blues/blues-kicad-lib/3d-models/DIST-WASMSIM0250.step

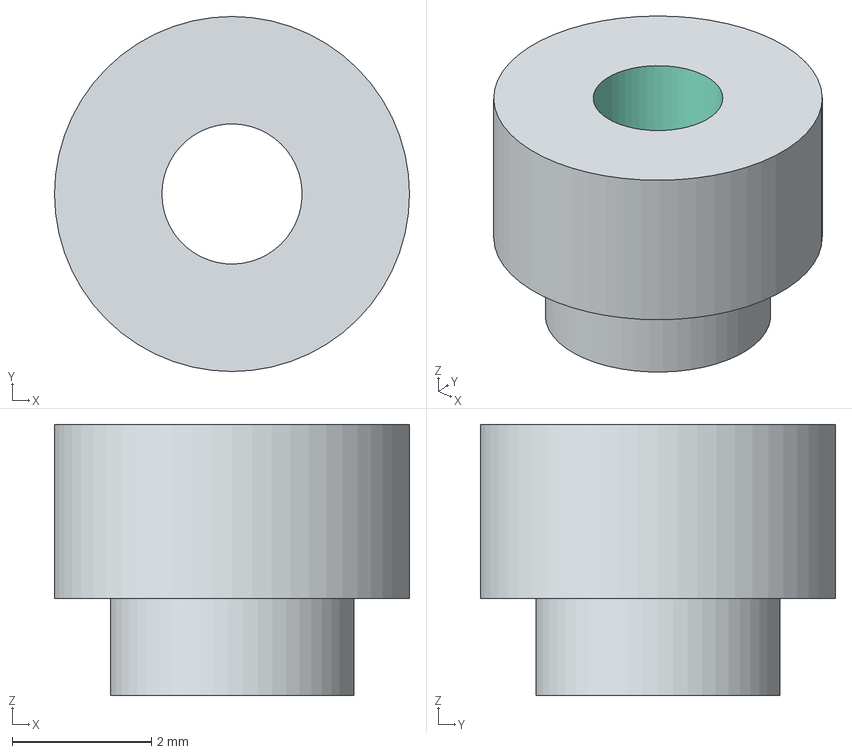
[picture p2: CAD file, 2023-12-04]
3d-models/DIST-WASMSIM0250.step
5.10 x 5.10 x 3.90 mm
