blues/blues-kicad-lib/3d-models/F930J107KAABE1.stp

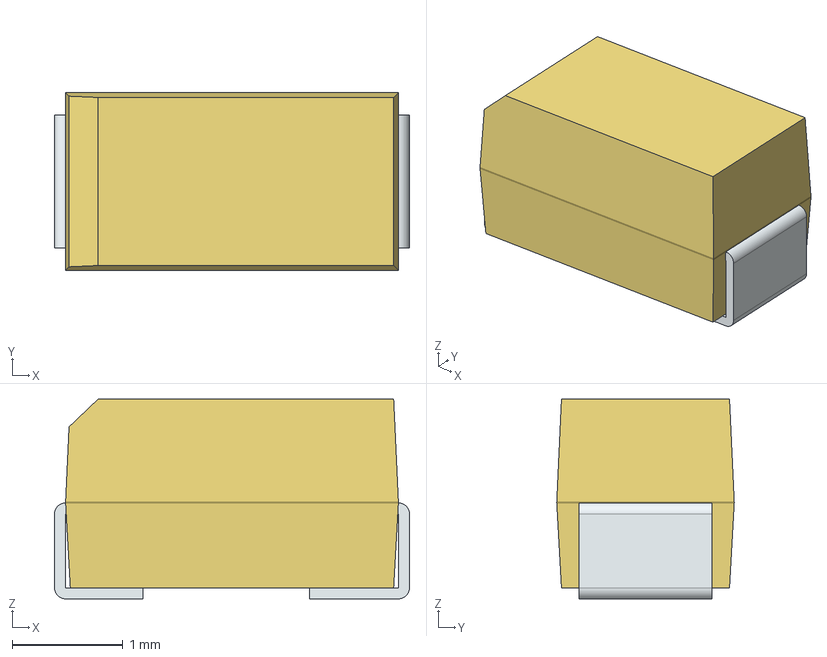
[picture p3: CAD file, 2026-10-05]
3d-models/F930J107KAABE1.stp
3.20 x 1.60 x 1.80 mm
FilletPin1
FilletPin2
