blues/blues-kicad-lib/3d-models/1769.stp

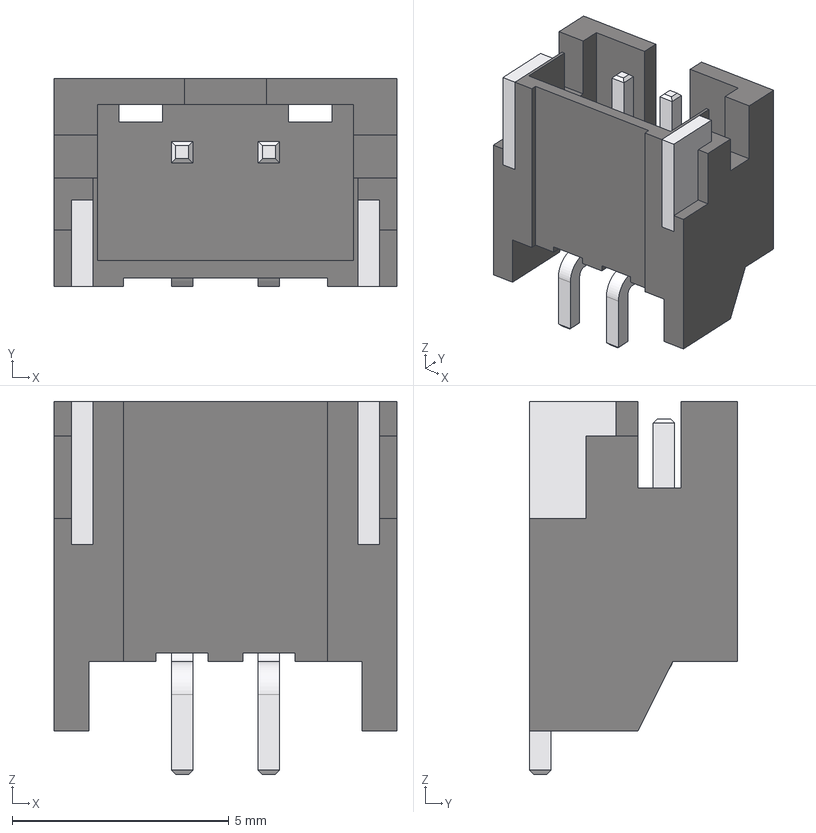
[picture p4: CAD file, 2026-10-05]
3d-models/1769.stp
7.90 x 4.80 x 8.60 mm
