blues/blues-kicad-lib/3d-models/C1206C103KDRACTU.stp

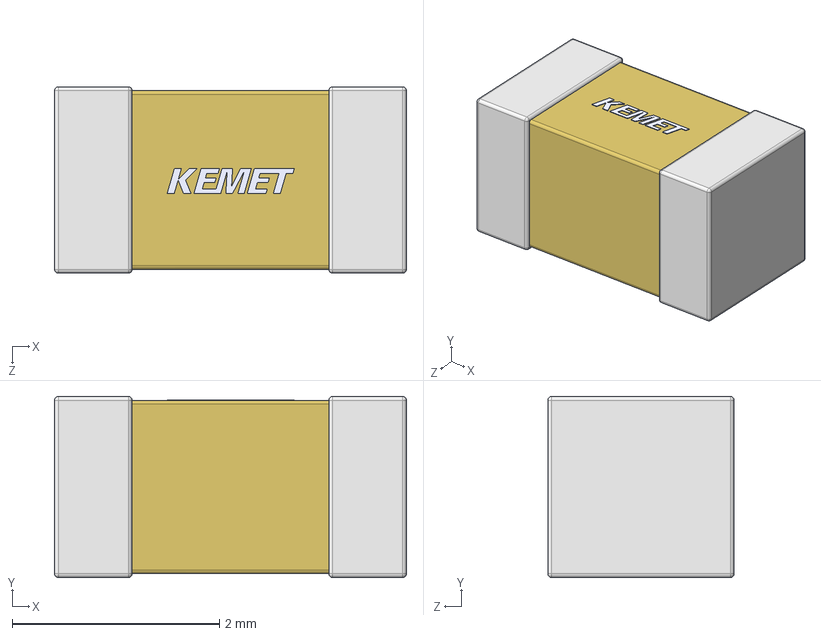
[picture p5: CAD file, 2026-10-05]
3d-models/C1206C103KDRACTU.stp
3.40 x 1.75 x 1.80 mm
