blues/blues-kicad-lib/3d-models/XTAL_3.2x1.5 MM.STEP

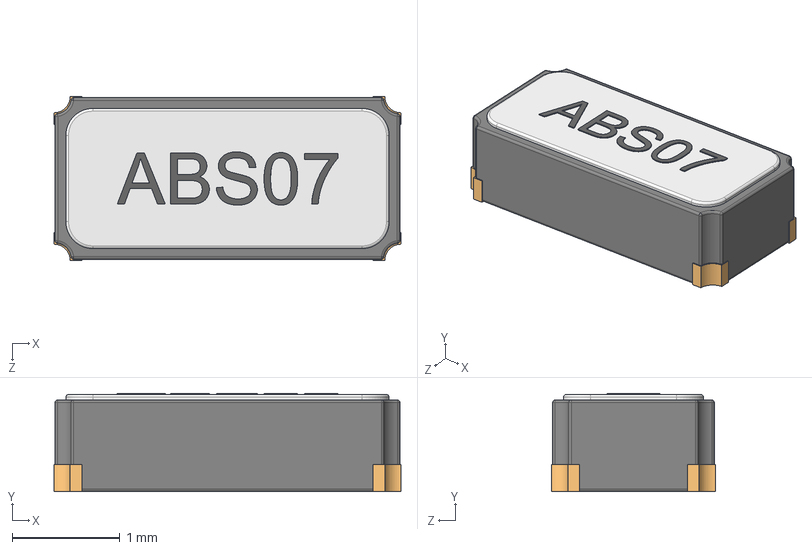
[picture p6: CAD file, 2026-10-05]
3d-models/XTAL_3.2x1.5 MM.STEP
3.22 x 0.91 x 1.52 mm
User Library-ABS07_ABS07 Body_2
User Library-ABS07_ABS07 Body2_2
User Library-ABS07_ABS07 Beschriftung_2
User Library-ABS07_ABS07 Pads_2
