blues/blues-kicad-lib/3d-models/XCVR_NN03-310.STEP

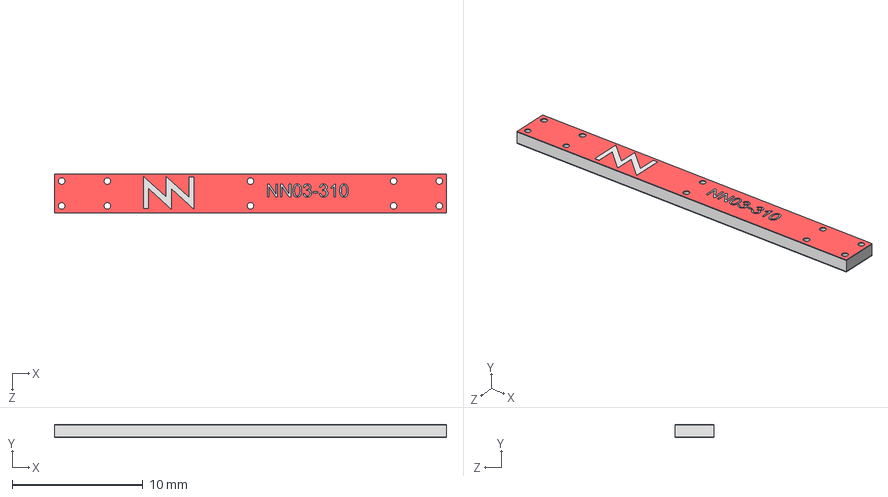
[picture p7: CAD file, 2026-10-05]
3d-models/XCVR_NN03-310.STEP
30.0 x 1.01 x 3.00 mm
