blues/blues-kicad-lib/3d-models/PHR-2-for-Battery-Adafruit.stp

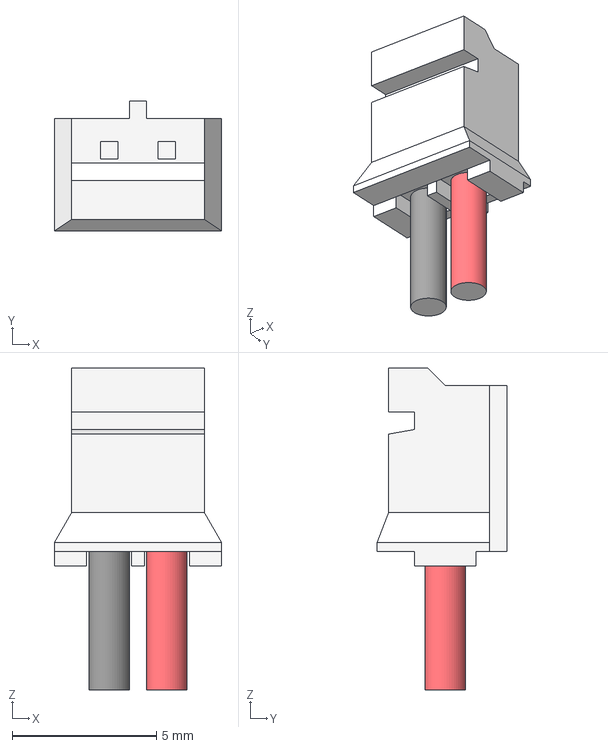
[picture p8: CAD file, 2026-10-05]
3d-models/PHR-2-for-Battery-Adafruit.stp
5.80 x 4.50 x 11.2 mm
