blues/blues-kicad-lib/3d-models/Cap_Murata_GRM188R61A106KE69D_eec.STEP

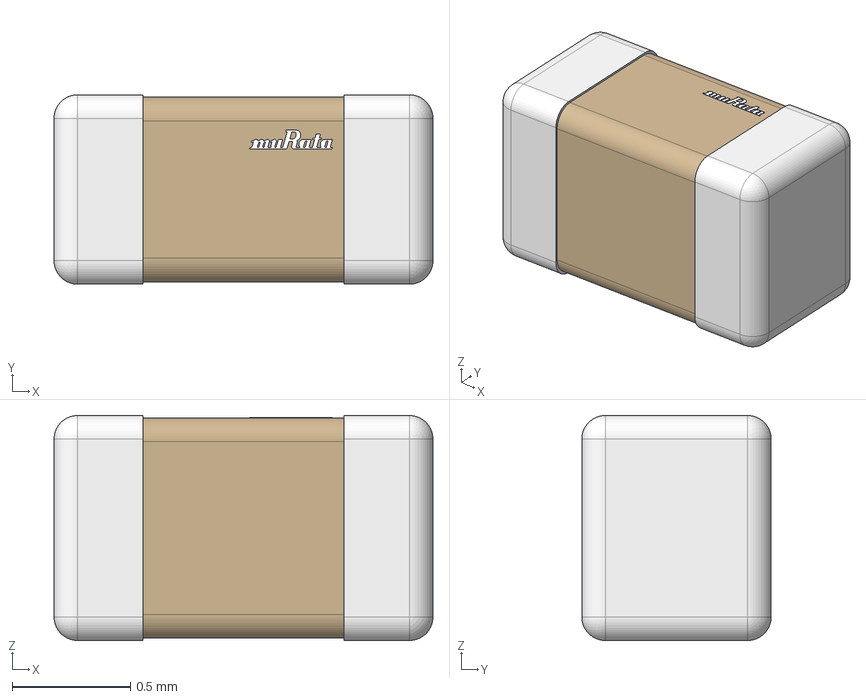
[picture p9: CAD file, 2026-10-05]
3d-models/Cap_Murata_GRM188R61A106KE69D_eec.STEP
1.60 x 0.8 x 0.95 mm
