blues/blues-kicad-lib/3d-models/RESC1608X38N EIA 0603.step

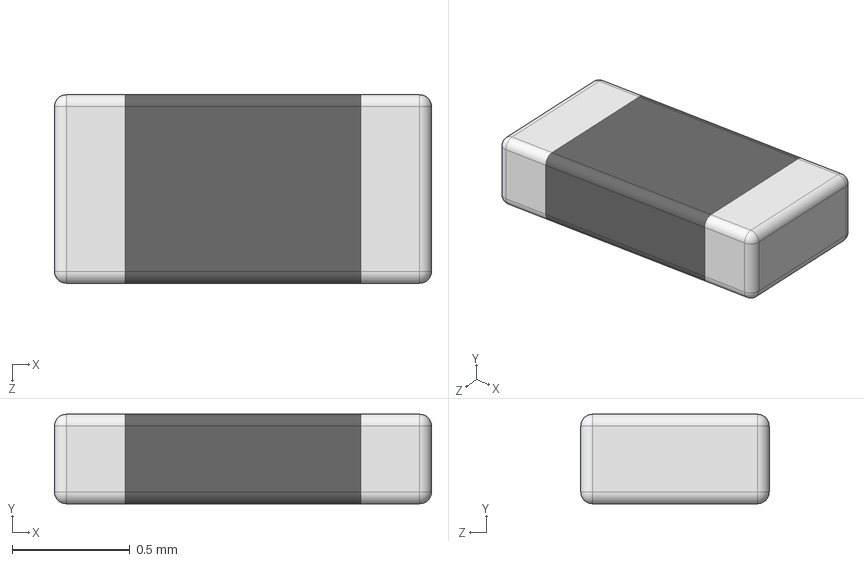
[picture p10: CAD file, 2026-10-05]
3d-models/RESC1608X38N EIA 0603.step
1.60 x 0.38 x 0.8 mm
