blues/blues-kicad-lib/3d-models/MAXWELL_BCAP0010_P300_X12.stp

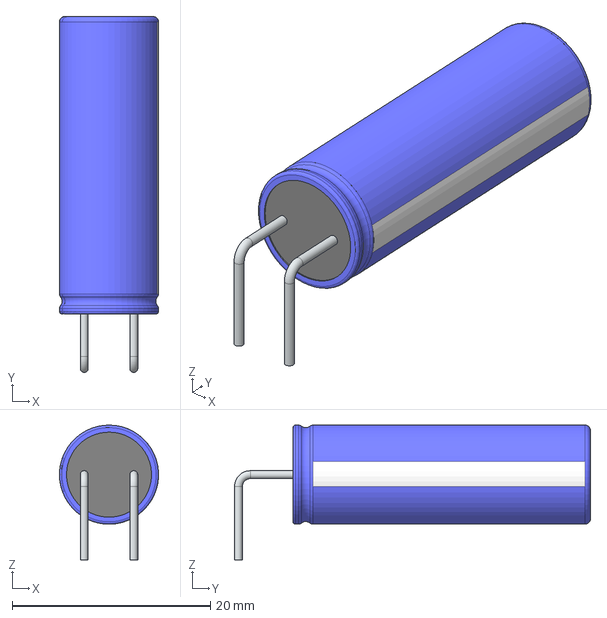
[picture p11: CAD file, 2026-10-05]
3d-models/MAXWELL_BCAP0010_P300_X12.stp
10.00 x 35.9 x 13.6 mm
