blues/blues-kicad-lib/3d-models/LQFP48_Grid_0_5.STEP

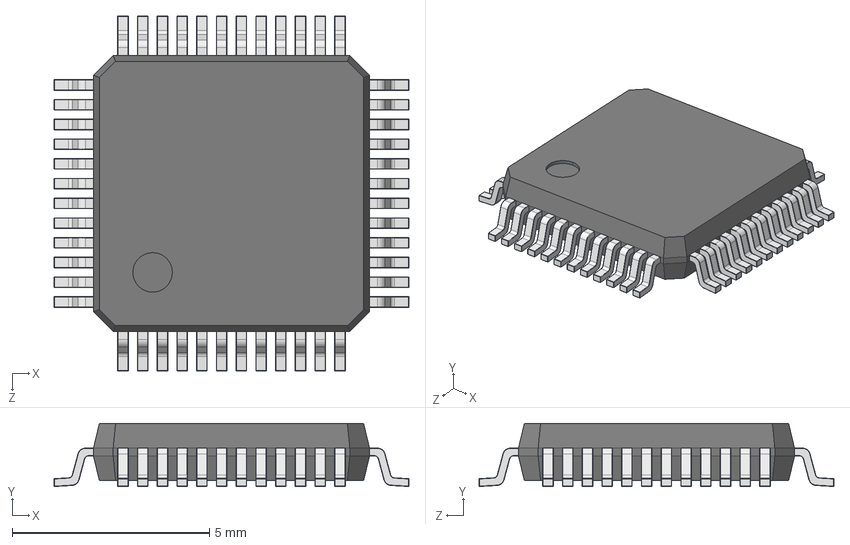
[picture p12: CAD file, 2026-10-05]
3d-models/LQFP48_Grid_0_5.STEP
9.00 x 1.60 x 9.00 mm
User Library-LQFP48_Grid_0.5_LQFP48_Koerper_2
User Library-LQFP48_Grid_0.5_LQFP_PIN_2 x 48
