blues/blues-kicad-lib/3d-models/IC_STMicroelectronics_STM32L433CCT6_eec.STEP

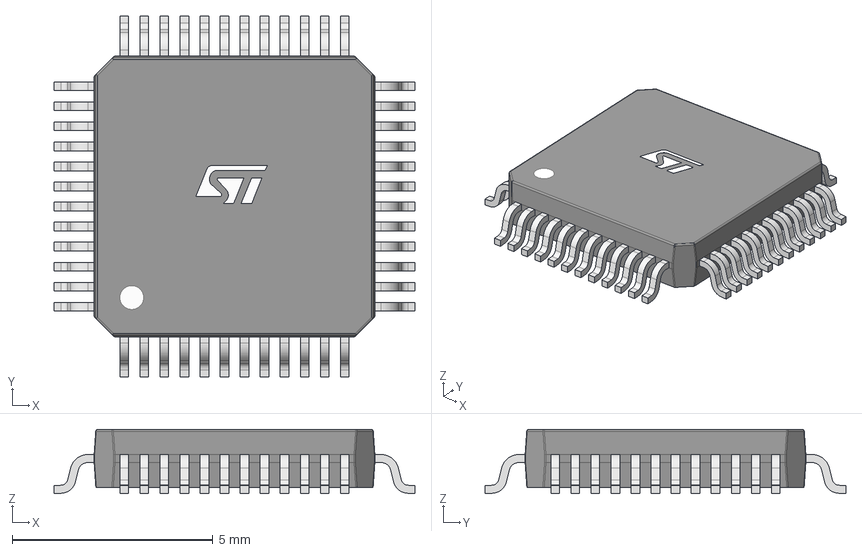
[picture p13: CAD file, 2026-10-05]
3d-models/IC_STMicroelectronics_STM32L433CCT6_eec.STEP
9.00 x 9.00 x 1.60 mm
STMicroelectronics STM32L433CCT6 1
STMicroelectronics STM32L433CCT6 2_MIR x 24
STMicroelectronics STM32L433CCT6 2 x 24
STMicroelectronics
