blues/blues-kicad-lib/3d-models/Cap_YAGEO_CC0402KRX7R9BB101_eec.STEP

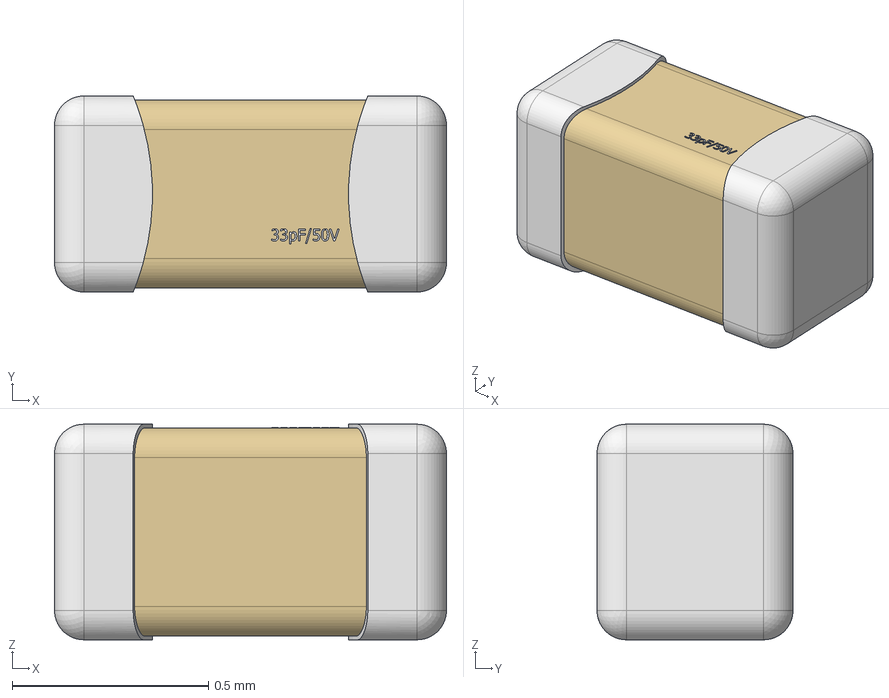
[picture p14: CAD file, 2026-10-05]
3d-models/Cap_YAGEO_CC0402KRX7R9BB101_eec.STEP
1.00 x 0.5 x 0.55 mm
