blues/blues-kicad-lib/3d-models/SOT-23-5.STEP

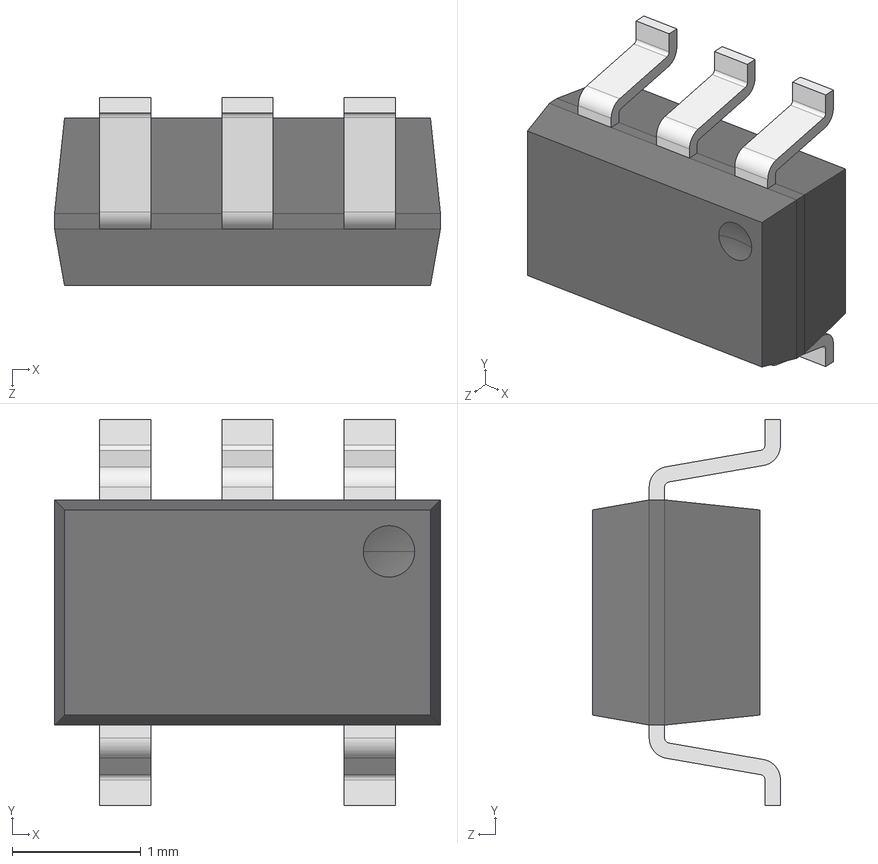
[picture p15: CAD file, 2026-10-05]
3d-models/SOT-23-5.STEP
3.00 x 3.00 x 1.46 mm
User Library-SOT-23-5_pin_SOT_sot-23-6_1 x 5
User Library-SOT-23-5_body_sot23-6_1
