blues/blues-kicad-lib/3d-models/User Library-XQFN-16-1.step

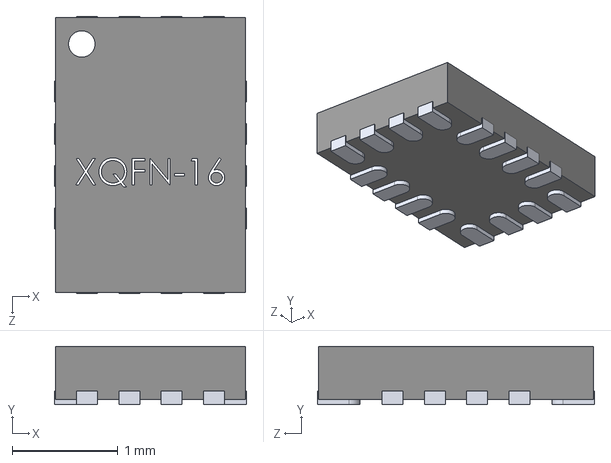
[picture p16: CAD file, 2026-10-05]
3d-models/User Library-XQFN-16-1.step
1.82 x 0.55 x 2.62 mm
