blues/blues-kicad-lib/3d-models/SSSS820101.STEP

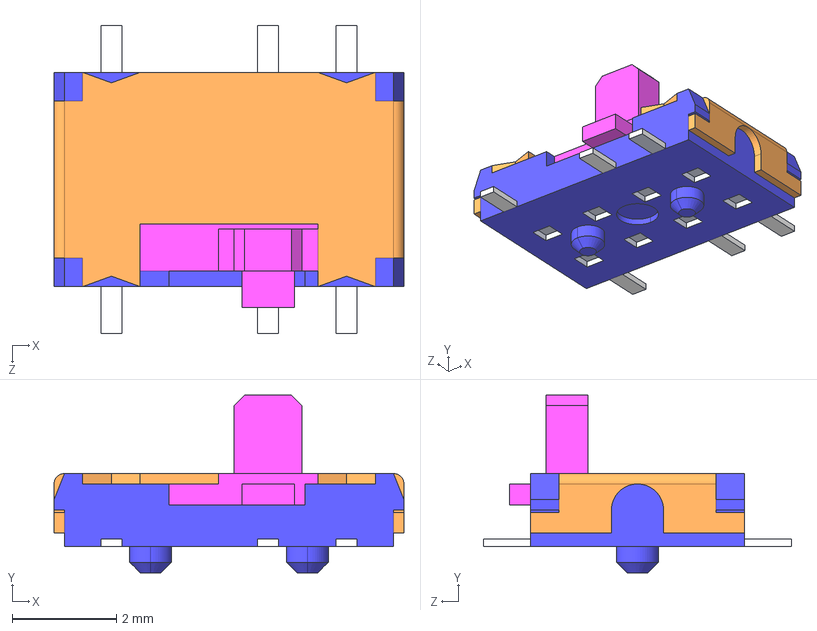
[picture p17: CAD file, 2026-10-05]
3d-models/SSSS820101.STEP
6.70 x 3.40 x 5.90 mm
