blues/blues-kicad-lib/3d-models/CAPC1608X95N EIA 0603.STEP

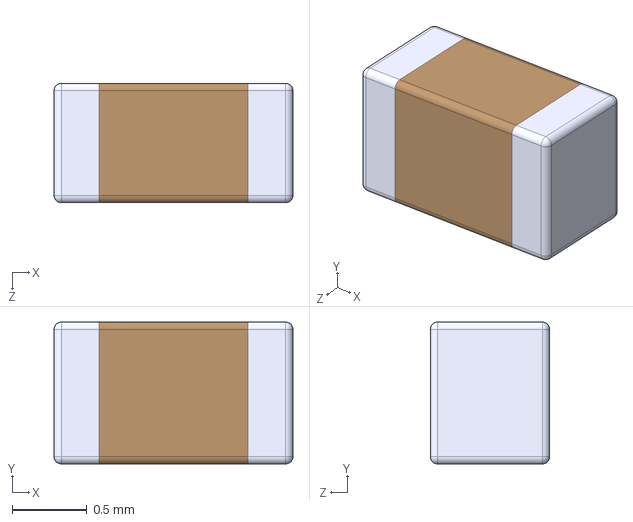
[picture p18: CAD file, 2026-10-05]
3d-models/CAPC1608X95N EIA 0603.STEP
1.60 x 0.95 x 0.8 mm
