blues/blues-kicad-lib/3d-models/SMLP1.step

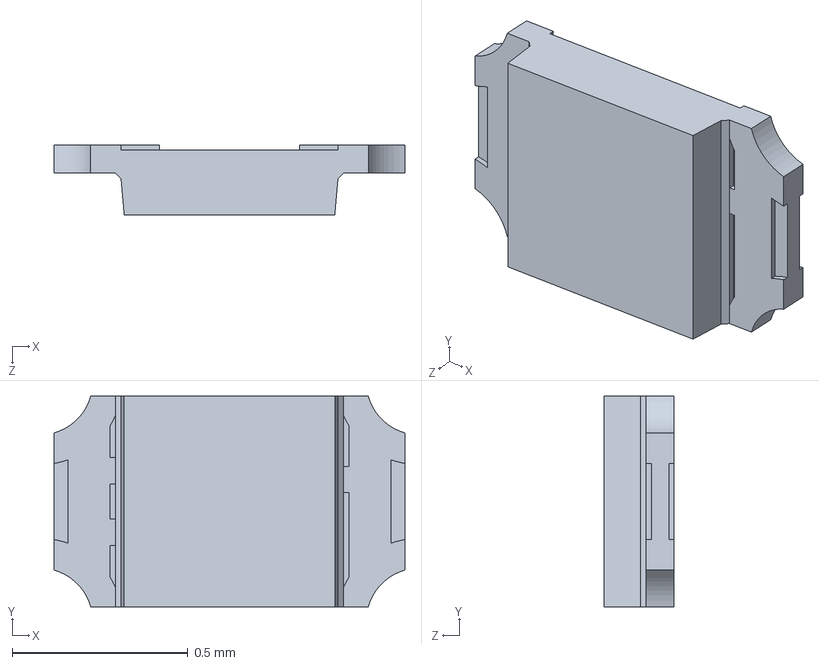
[picture p19: CAD file, 2026-10-05]
3d-models/SMLP1.step
1.00 x 0.6 x 0.2 mm
