blues/blues-kicad-lib/3d-models/ESDA7P120-1U1M.STEP

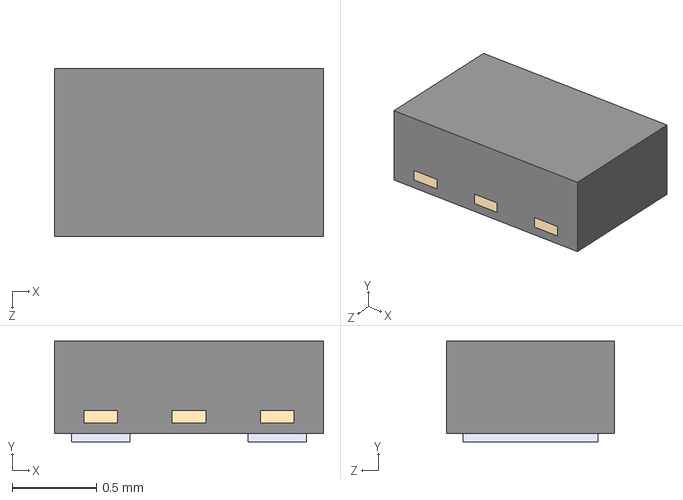
[picture p20: CAD file, 2026-10-05]
3d-models/ESDA7P120-1U1M.STEP
1.60 x 0.6 x 1.00 mm
