blues/blues-kicad-lib/3d-models/ftsh-107-01-l-dv-k.stp

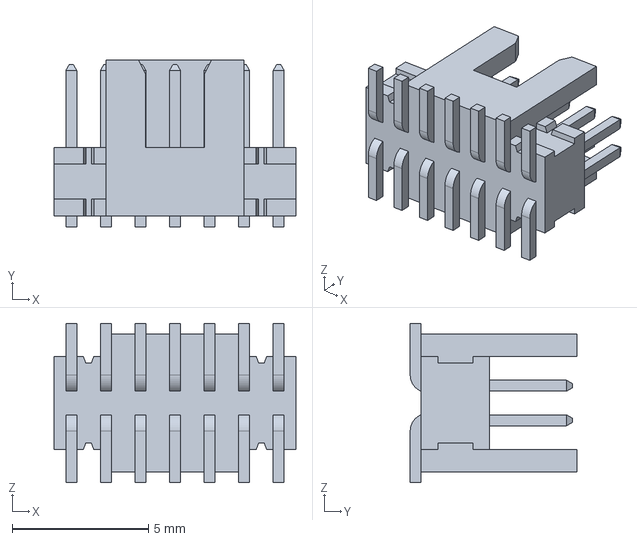
[picture p21: CAD file, 2026-10-05]
3d-models/ftsh-107-01-l-dv-k.stp
8.89 x 6.12 x 5.84 mm
