blues/blues-kicad-lib/3d-models/U.FL-R-SMT-1(10).STEP

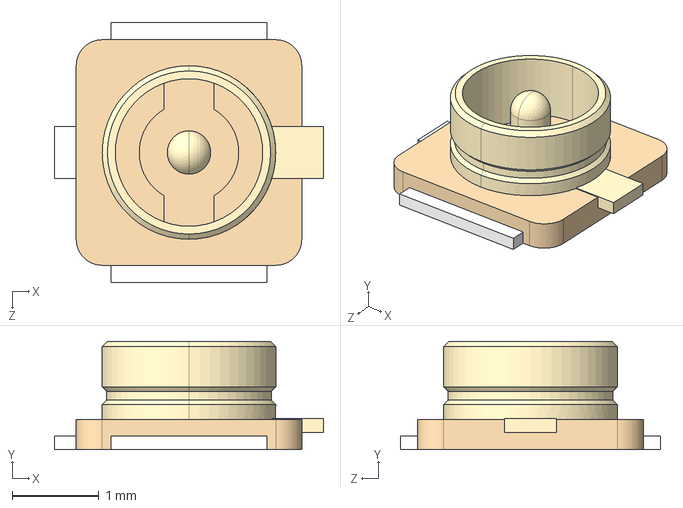
[picture p22: CAD file, 2026-10-05]
3d-models/U.FL-R-SMT-1(10).STEP
3.10 x 1.25 x 3.00 mm
