blues/blues-kicad-lib/3d-models/Hold Wire.stp

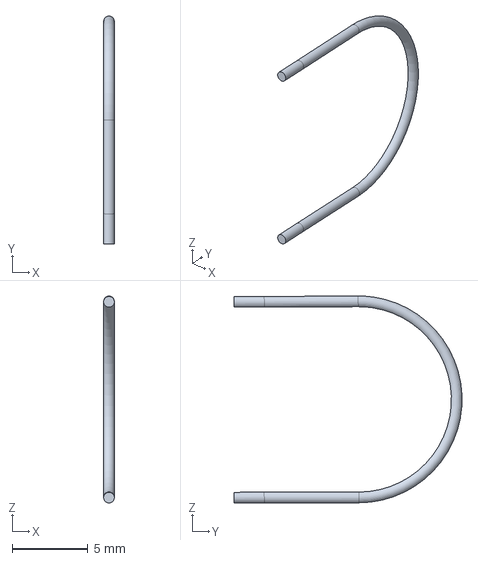
[picture p23: CAD file, 2026-10-05]
3d-models/Hold Wire.stp
0.709 x 15.1 x 13.7 mm
