blues/blues-kicad-lib/3d-models/IC_Microchip_MCP73831-2ACI-MC_eec.STEP

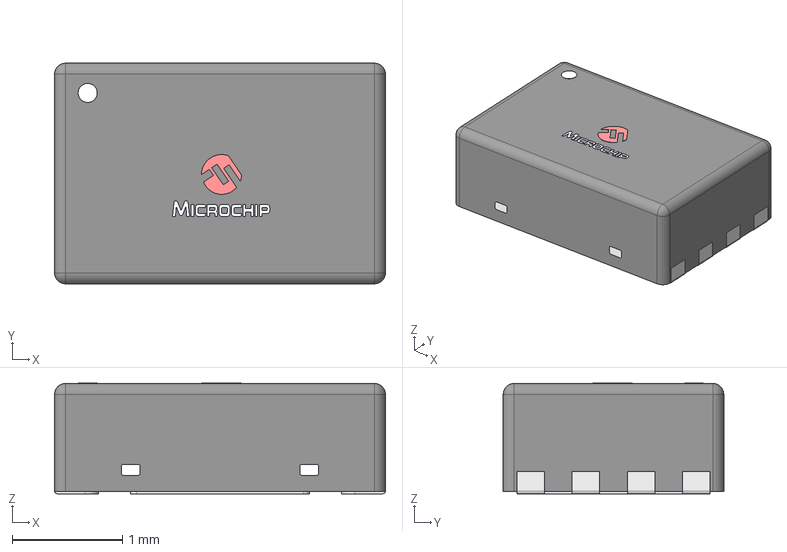
[picture p24: CAD file, 2026-10-05]
3d-models/IC_Microchip_MCP73831-2ACI-MC_eec.STEP
3.00 x 2.00 x 1.00 mm
