blues/blues-kicad-lib/3d-models/IC_Texas_Instruments_TPS63020DSJT_eec.STEP

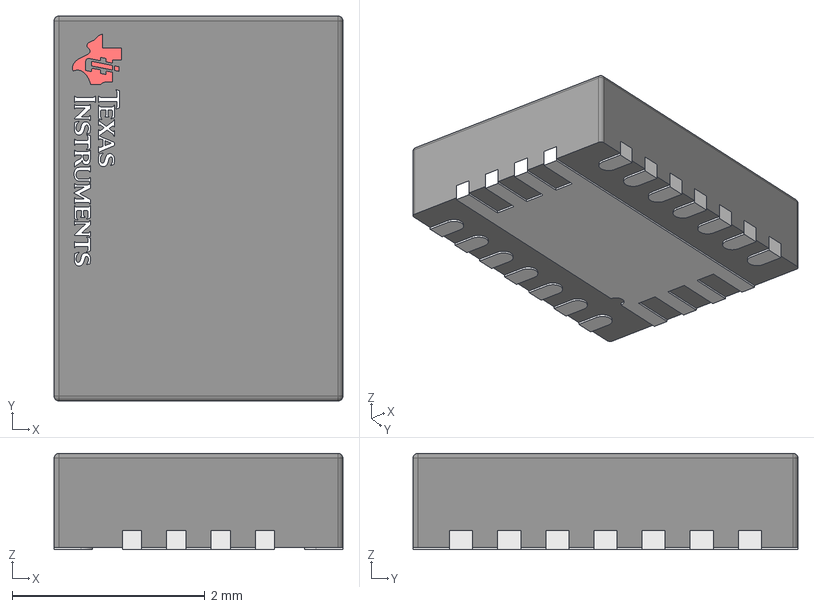
[picture p25: CAD file, 2026-10-05]
3d-models/IC_Texas_Instruments_TPS63020DSJT_eec.STEP
3.00 x 4.00 x 1.00 mm
