blues/blues-kicad-lib/3d-models/SOD-523F.step

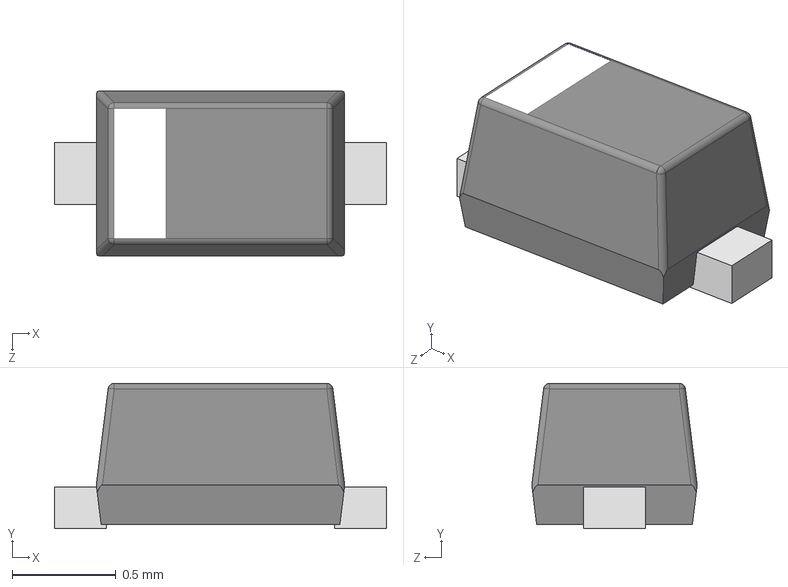
[picture p26: CAD file, 2026-10-05]
3d-models/SOD-523F.step
1.60 x 0.7 x 0.798 mm
