blues/blues-kicad-lib/3d-models/Coilcraft-XFL4020.STEP

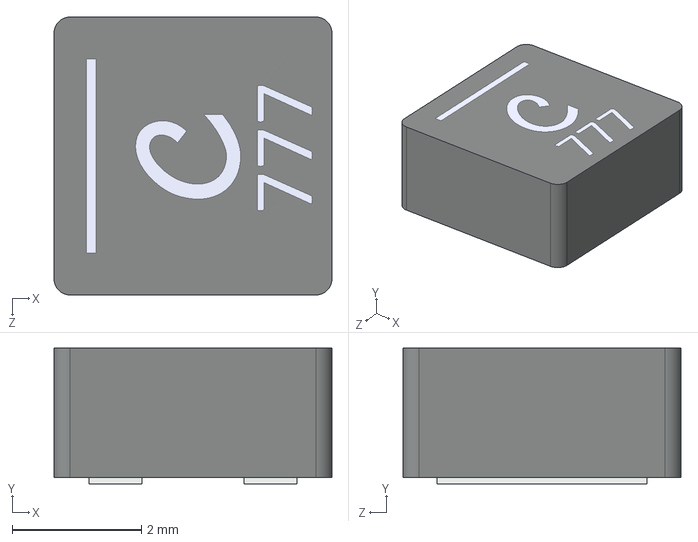
[picture p27: CAD file, 2026-10-05]
3d-models/Coilcraft-XFL4020.STEP
4.30 x 2.10 x 4.30 mm
