blues/blues-kicad-lib/3d-models/Header 254 1x2.STEP

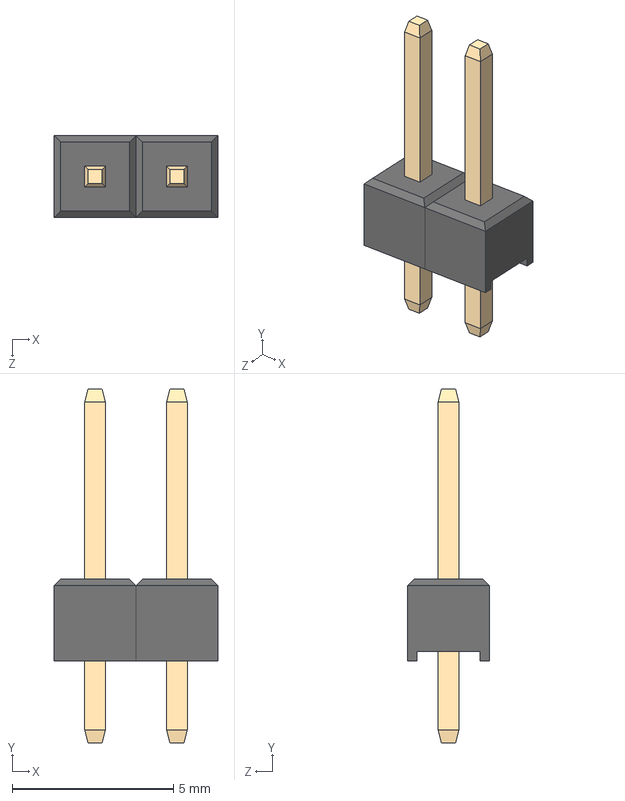
[picture p28: CAD file, 2026-10-05]
3d-models/Header 254 1x2.STEP
5.08 x 11.0 x 2.54 mm
User Library-Header1x2_Header1_1 x 2
