blues/blues-kicad-lib/3d-models/User Library-TSOT-23.step

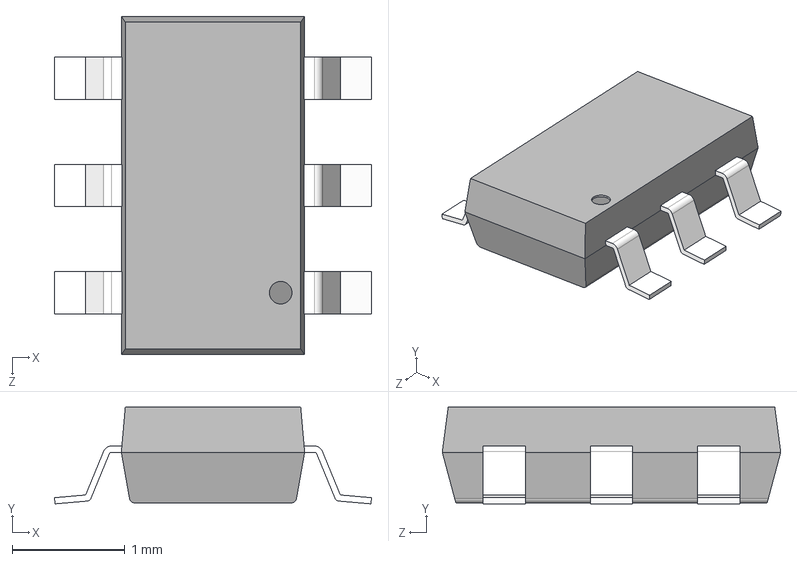
[picture p29: CAD file, 2026-10-05]
3d-models/User Library-TSOT-23.step
2.81 x 0.857 x 3.00 mm
