blues/blues-kicad-lib/3d-models/IC_Maxim_Integrated_MAX40203AUK+T_eec.STEP

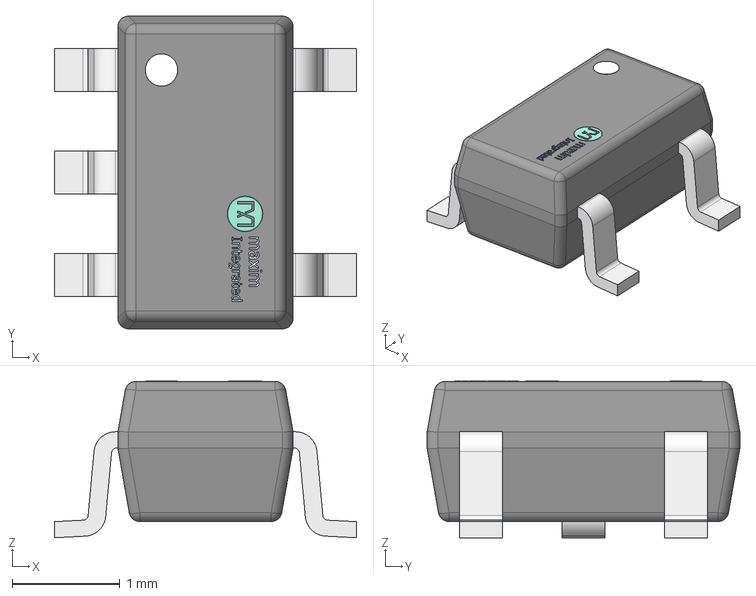
[picture p30: CAD file, 2026-10-05]
3d-models/IC_Maxim_Integrated_MAX40203AUK+T_eec.STEP
2.80 x 2.90 x 1.45 mm
