blues/blues-kicad-lib/3d-models/Crys_Abracon_ABS06-32_768KHZ-1-T_eec.STEP

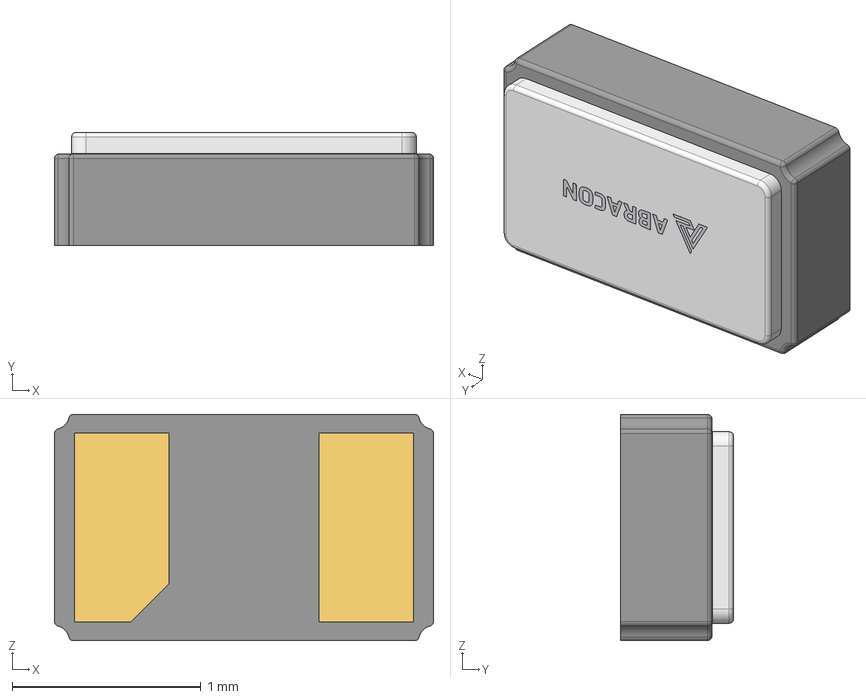
[picture p31: CAD file, 2026-10-05]
3d-models/Crys_Abracon_ABS06-32_768KHZ-1-T_eec.STEP
2.01 x 0.6 x 1.20 mm
LID
Termination
Logo
