blues/blues-kicad-lib/3d-models/Res_Vishay_Dale_WSL2010R1500FEA18_eec.STEP

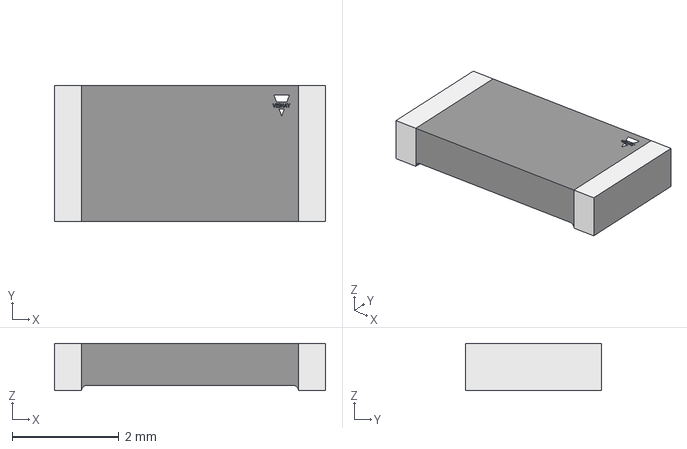
[picture p32: CAD file, 2026-10-05]
3d-models/Res_Vishay_Dale_WSL2010R1500FEA18_eec.STEP
5.08 x 2.54 x 0.89 mm
