blues/blues-kicad-lib/3d-models/MDT580E01002--3DModel-STEP-56544.STEP

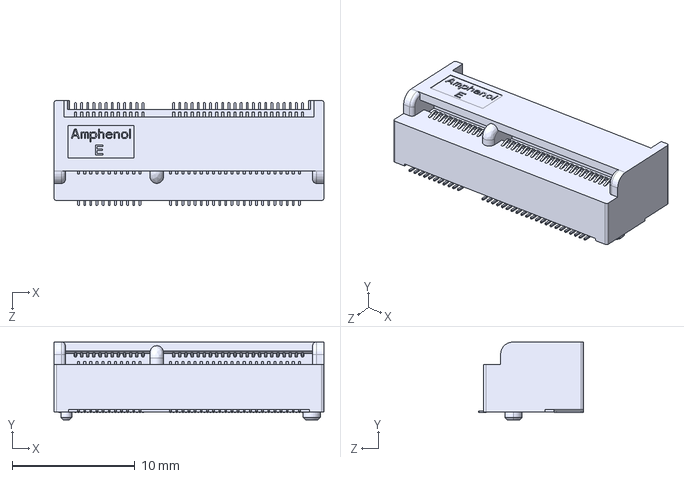
[picture p33: CAD file, 2026-10-05]
3d-models/MDT580E01002--3DModel-STEP-56544.STEP
22.0 x 6.35 x 8.55 mm
