blues/blues-kicad-lib/3d-models/L-0603.STEP

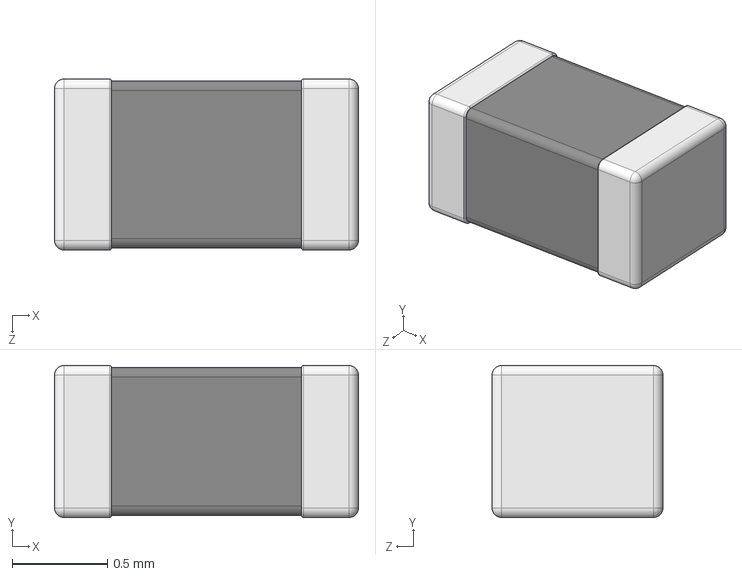
[picture p34: CAD file, 2026-10-05]
3d-models/L-0603.STEP
1.60 x 0.8 x 0.9 mm
User Library-V0603HD_K_X_F6rper_1
User Library-V0603HD_Anschl_X_FCsse_1
