blues/blues-kicad-lib/3d-models/SOT-563.STEP

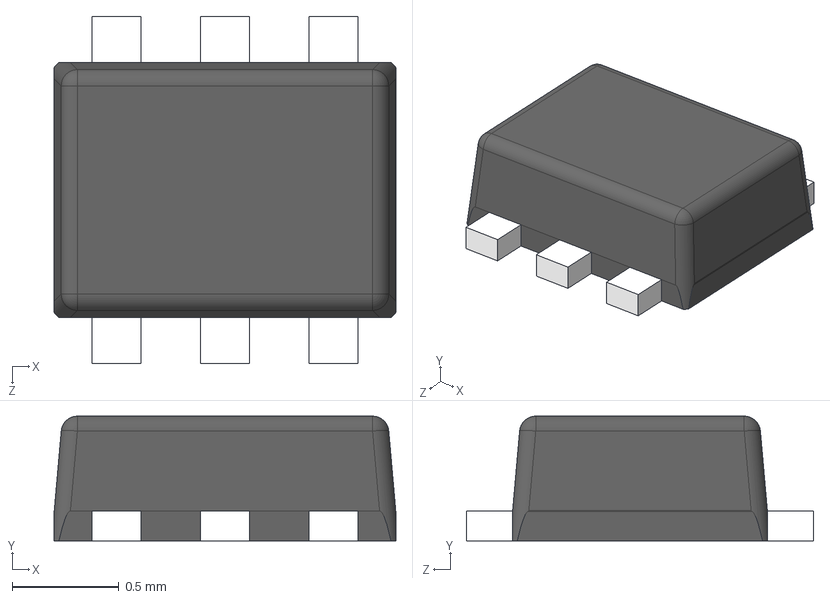
[picture p35: CAD file, 2026-10-05]
3d-models/SOT-563.STEP
1.60 x 0.584 x 1.63 mm
