blues/blues-kicad-lib/3d-models/Ind_Coilcraft_XFL4020-152MEC_eec.STEP

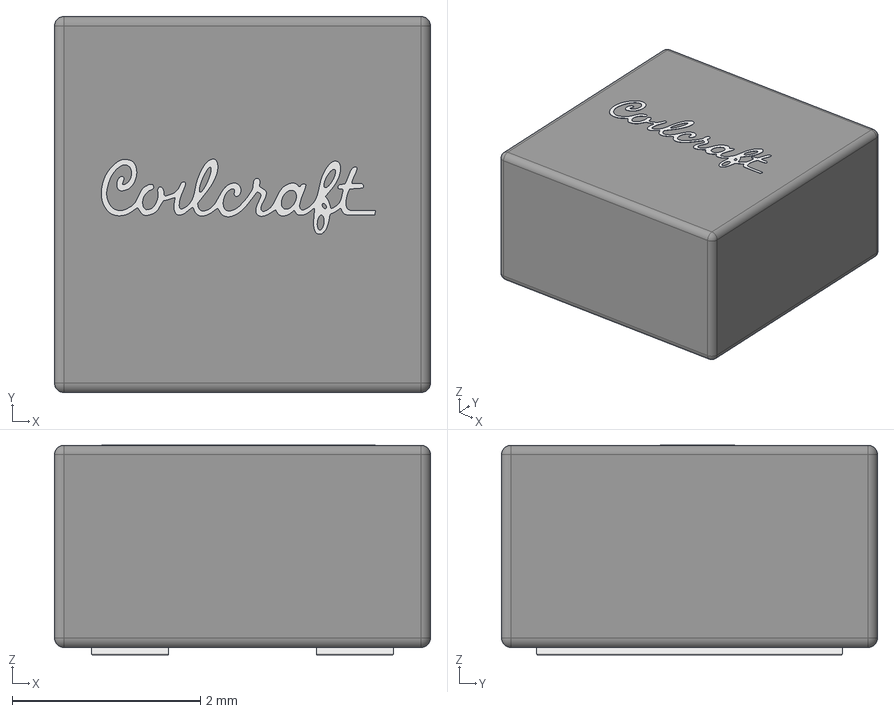
[picture p36: CAD file, 2026-10-05]
3d-models/Ind_Coilcraft_XFL4020-152MEC_eec.STEP
4.00 x 4.00 x 2.23 mm
Leads
Coilcraft Logo
