blues/blues-kicad-lib/3d-models/Cap_Samsung_CL10B473KO8NNWC_eec.STEP

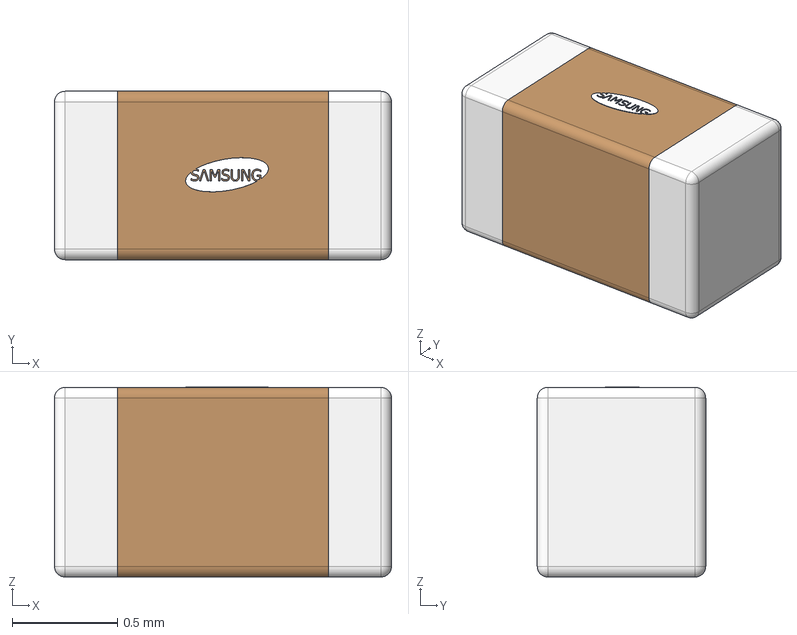
[picture p37: CAD file, 2026-10-05]
3d-models/Cap_Samsung_CL10B473KO8NNWC_eec.STEP
1.60 x 0.8 x 0.902 mm
Samsung logo
