blues/blues-kicad-lib/3d-models/RESC1005X04M.step

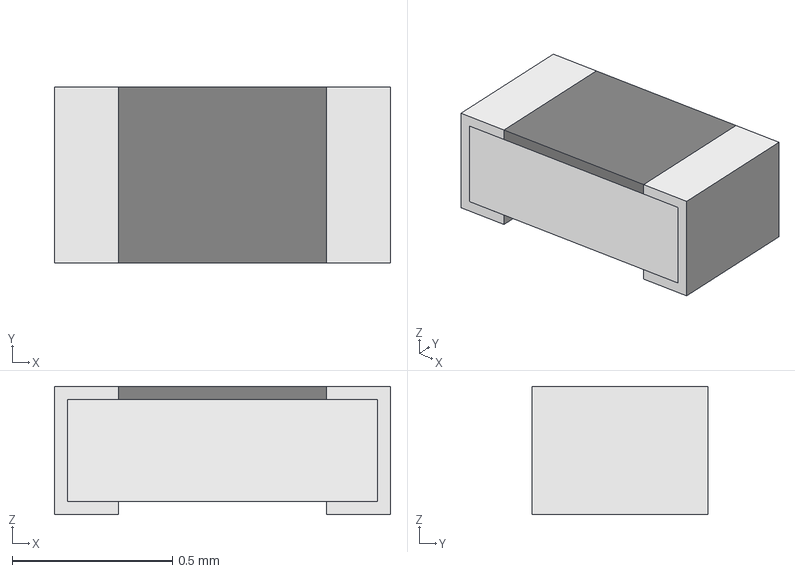
[picture p38: CAD file, 2026-10-05]
3d-models/RESC1005X04M.step
1.05 x 0.55 x 0.4 mm
Mid_Body
Mark
