blues/blues-kicad-lib/3d-models/STEP-WE-MAPI-2512-rev1.stp

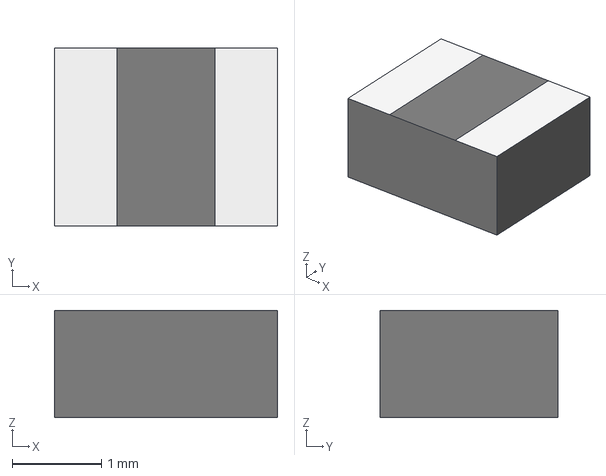
[picture p39: CAD file, 2026-10-05]
3d-models/STEP-WE-MAPI-2512-rev1.stp
2.50 x 2.00 x 1.20 mm
