blues/blues-kicad-lib/3d-models/C003SAAN-RC.STEP

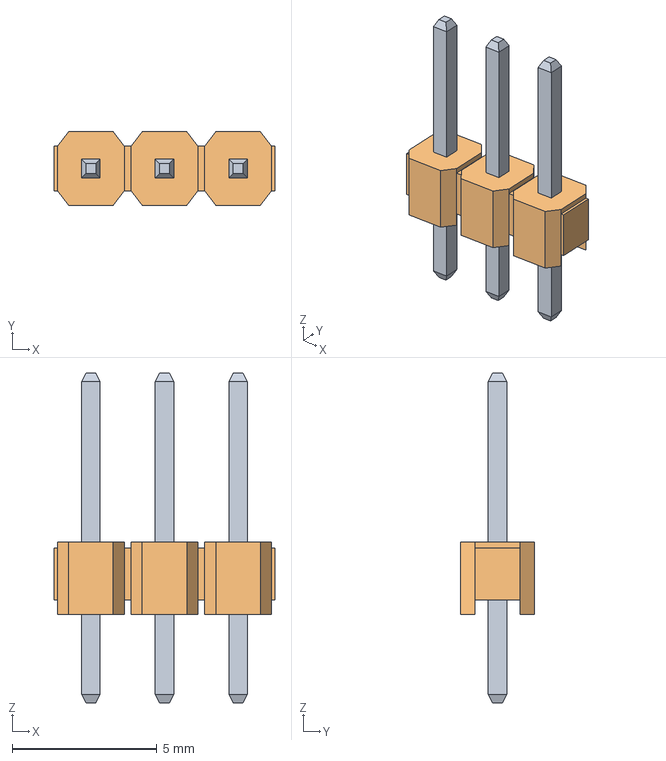
[picture p40: CAD file, 2026-10-05]
3d-models/C003SAAN-RC.STEP
7.62 x 2.54 x 11.4 mm
