blues/blues-kicad-lib/3d-models/SOT95P280X125-3N.step

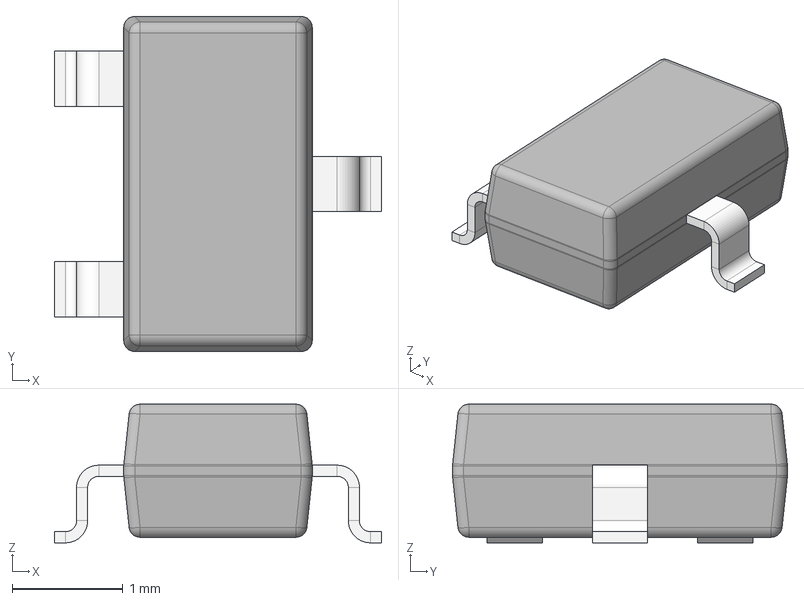
[picture p41: CAD file, 2026-10-05]
3d-models/SOT95P280X125-3N.step
2.95 x 3.02 x 1.25 mm
Leader x 3
