blues/blues-kicad-lib/3d-models/Cap_KEMET_C0805C472J3HAC_eec.STEP

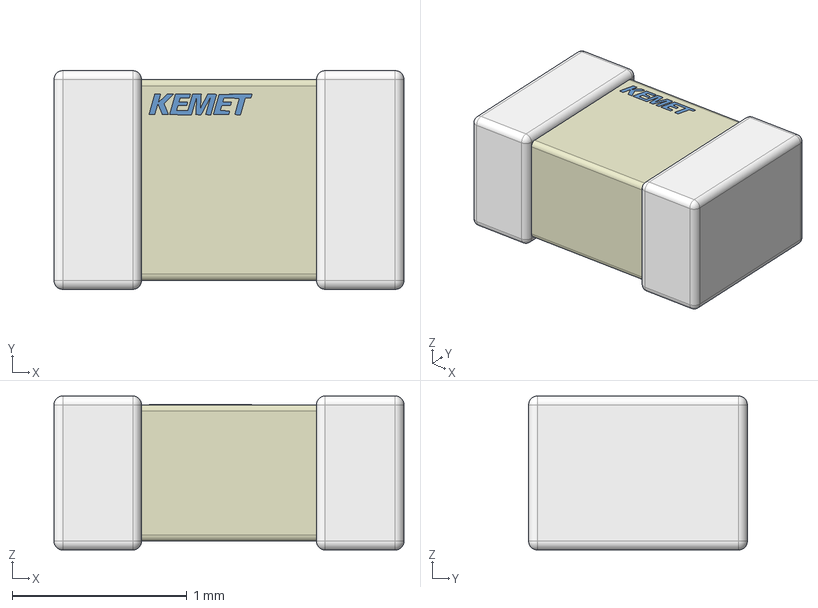
[picture p42: CAD file, 2026-10-05]
3d-models/Cap_KEMET_C0805C472J3HAC_eec.STEP
2.00 x 1.25 x 0.88 mm
