blues/blues-kicad-lib/3d-models/C002SAAN-RC.STEP

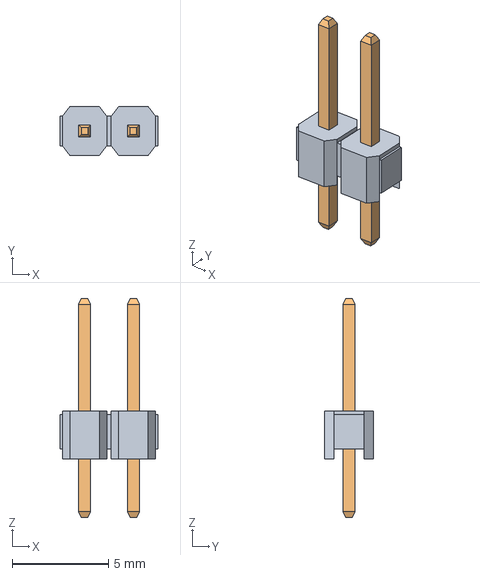
[picture p43: CAD file, 2026-10-05]
3d-models/C002SAAN-RC.STEP
5.08 x 2.54 x 11.4 mm
