blues/blues-kicad-lib/3d-models/J-5X2-0254-MDT.stp

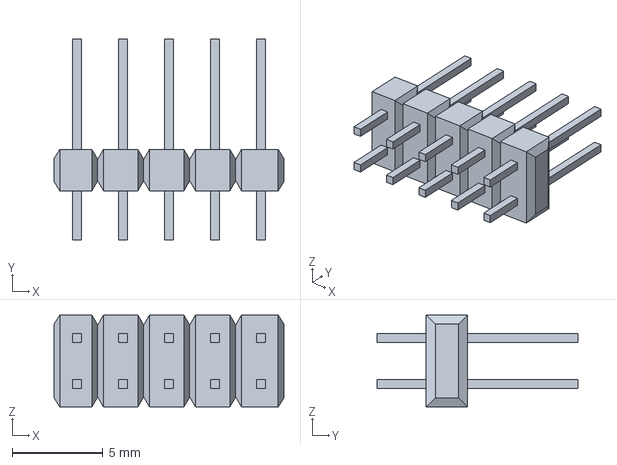
[picture p44: CAD file, 2026-10-05]
3d-models/J-5X2-0254-MDT.stp
12.7 x 11.1 x 5.08 mm
