blues/blues-kicad-lib/3d-models/IND_SRP7050_BRN.step

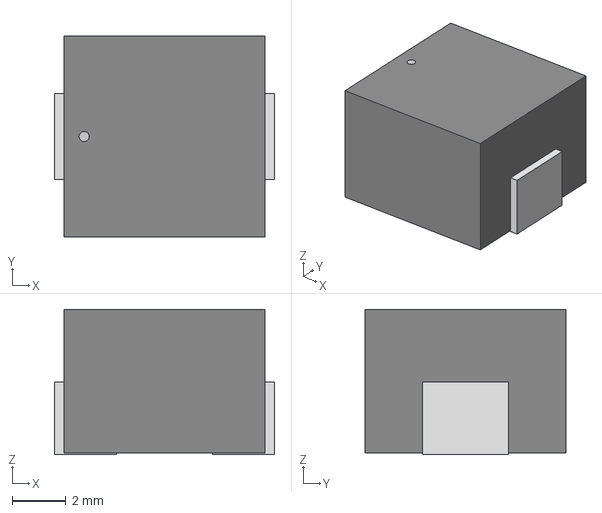
[picture p45: CAD file, 2026-10-05]
3d-models/IND_SRP7050_BRN.step
8.20 x 7.49 x 5.41 mm
