blues/blues-kicad-lib/3d-models/0805 resistor.STEP

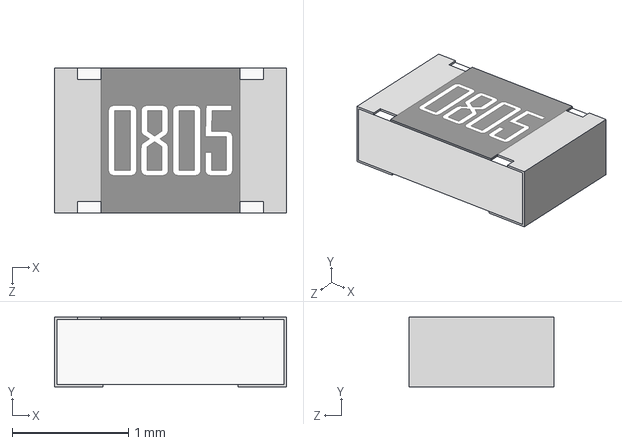
[picture p46: CAD file, 2026-10-05]
3d-models/0805 resistor.STEP
2.00 x 0.6 x 1.25 mm
