blues/blues-kicad-lib/3d-models/B2B-PH-SM4-TBT.STEP

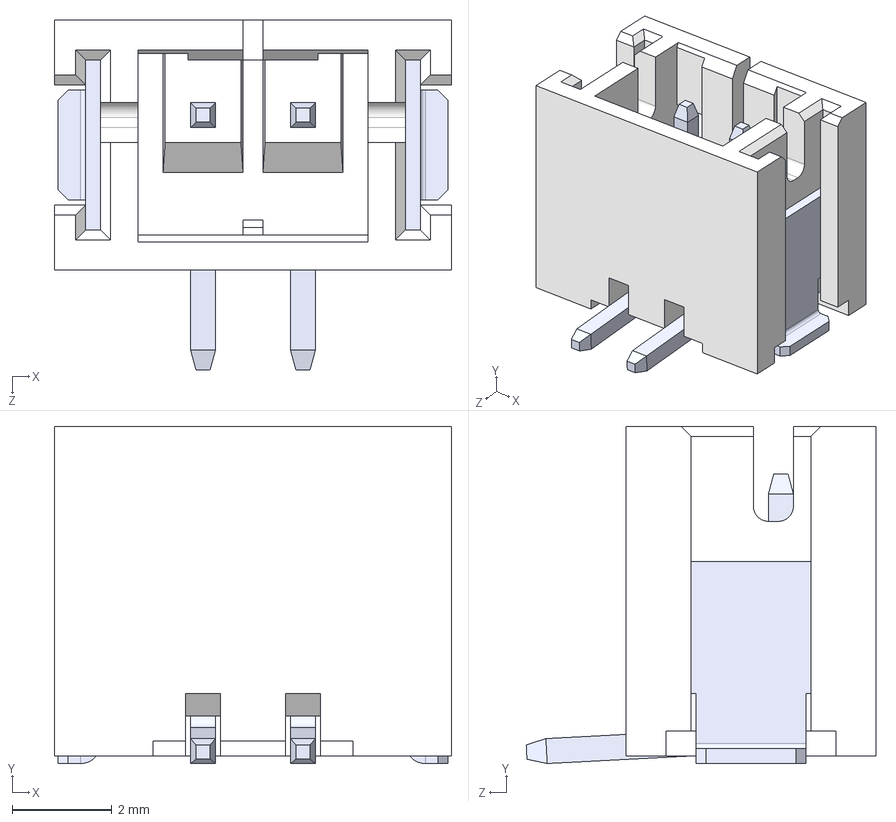
[picture p47: CAD file, 2026-10-05]
3d-models/B2B-PH-SM4-TBT.STEP
7.95 x 6.75 x 7.00 mm
BxB-PH-SM4 body_2
BxB-PH-SM4 tab x 2
BxB-PH-SM4 pin x 2
