blues/blues-kicad-lib/3d-models/Conn_JST_BM04B-SRSS-TBT_LF_SN_eec.STEP

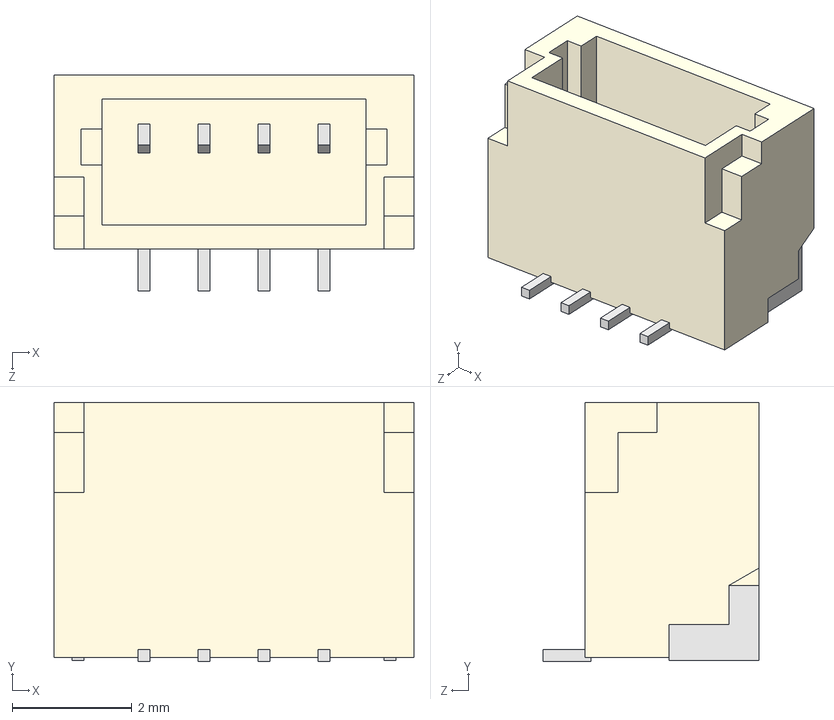
[picture p48: CAD file, 2026-10-05]
3d-models/Conn_JST_BM04B-SRSS-TBT_LF_SN_eec.STEP
6.00 x 4.32 x 3.60 mm
BNody
Pins
New Marking
JST Logo
