blues/blues-kicad-lib/3d-models/MCKK1608T1R0MN.stp

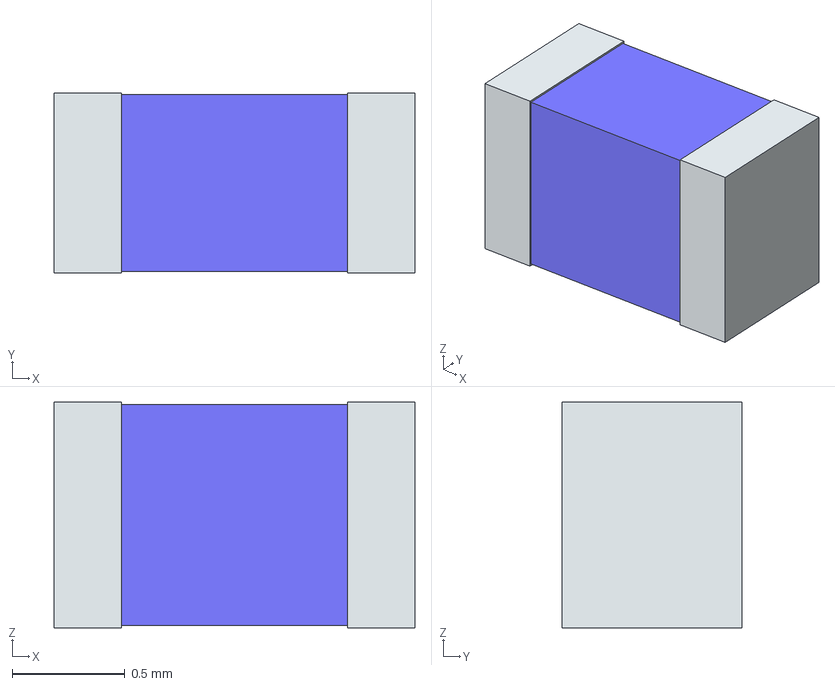
[picture p49: CAD file, 2026-10-05]
3d-models/MCKK1608T1R0MN.stp
1.60 x 0.8 x 1.00 mm
term1
term2
