blues/blues-kicad-lib/3d-models/IC_On_Semiconductor_NCP718BSNADJT1G_eec.STEP

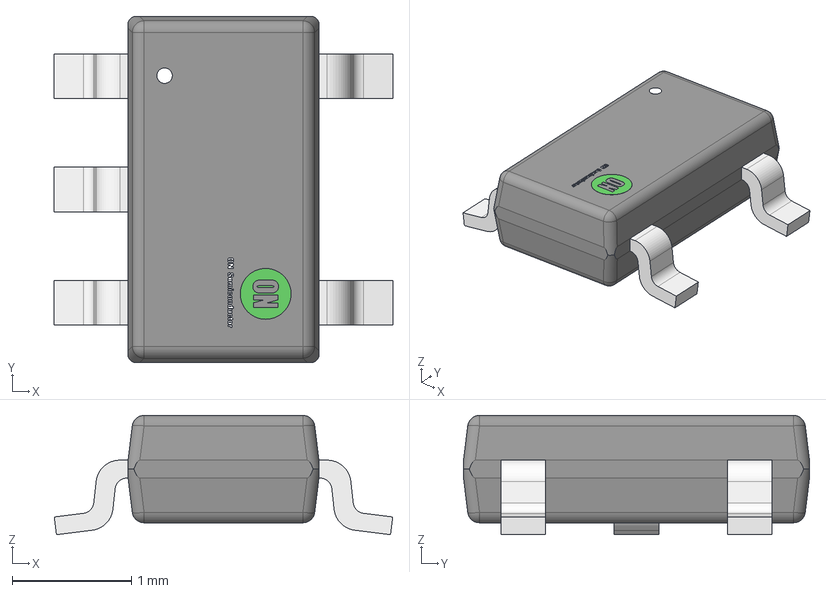
[picture p50: CAD file, 2026-10-05]
3d-models/IC_On_Semiconductor_NCP718BSNADJT1G_eec.STEP
2.84 x 2.90 x 1.00 mm
