blues/blues-kicad-lib/3d-models/SM05B-SRSS-TB--3DModel-STEP-269445.STEP

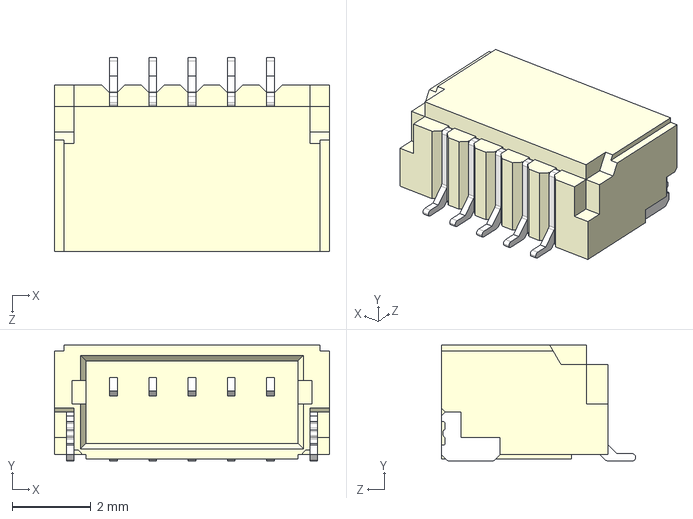
[picture p51: CAD file, 2026-10-05]
3d-models/SM05B-SRSS-TB--3DModel-STEP-269445.STEP
7.00 x 2.95 x 4.95 mm
