blues/blues-kicad-lib/3d-models/RES0603.step

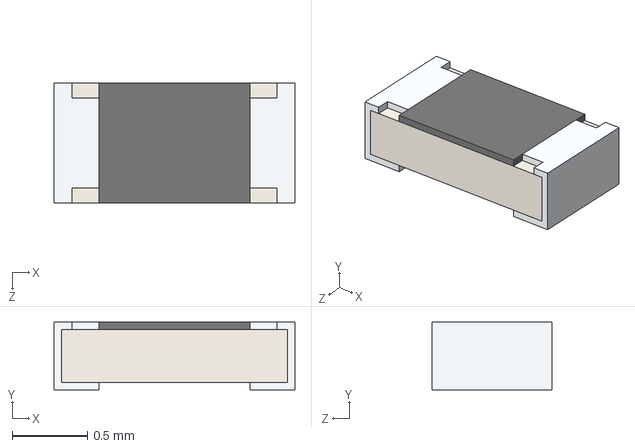
[picture p52: CAD file, 2026-10-05]
3d-models/RES0603.step
1.60 x 0.45 x 0.8 mm
