blues/blues-kicad-lib/3d-models/Cap_AVX_06036C105JAT2A_eec.STEP

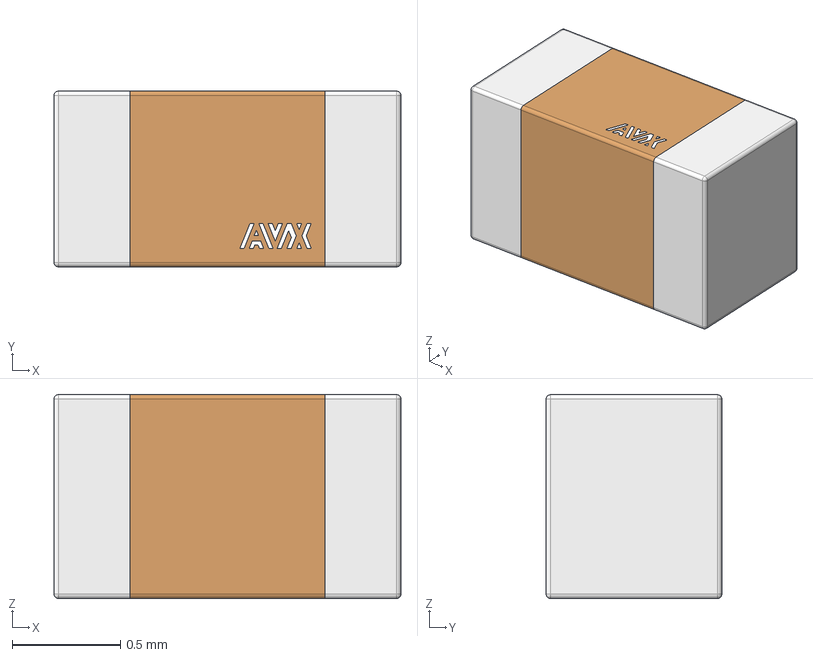
[picture p53: CAD file, 2026-10-05]
3d-models/Cap_AVX_06036C105JAT2A_eec.STEP
1.60 x 0.81 x 0.941 mm
Terminals
AVX
