blues/blues-kicad-lib/3d-models/ISL9122AIINZ-T.stp

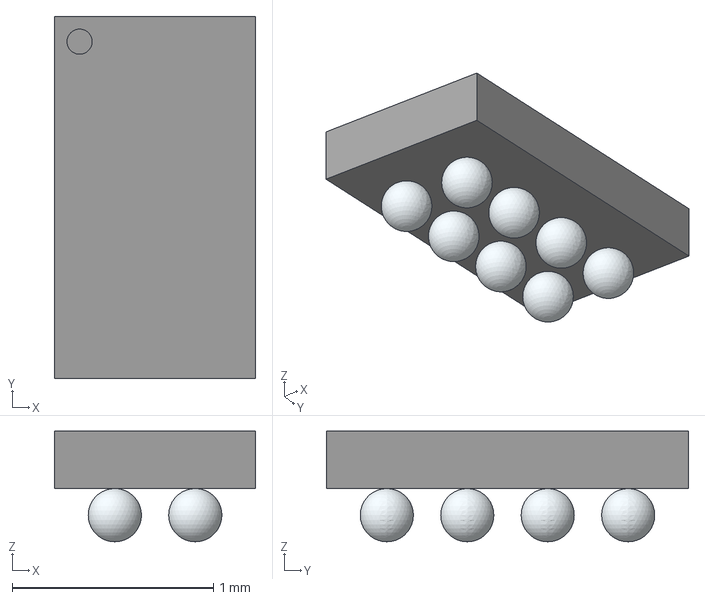
[picture p54: CAD file, 2026-10-05]
3d-models/ISL9122AIINZ-T.stp
1.00 x 1.80 x 0.55 mm
