blues/blues-kicad-lib/3d-models/Cap_Murata_GRM0335C1HR30BA01D_eec.STEP

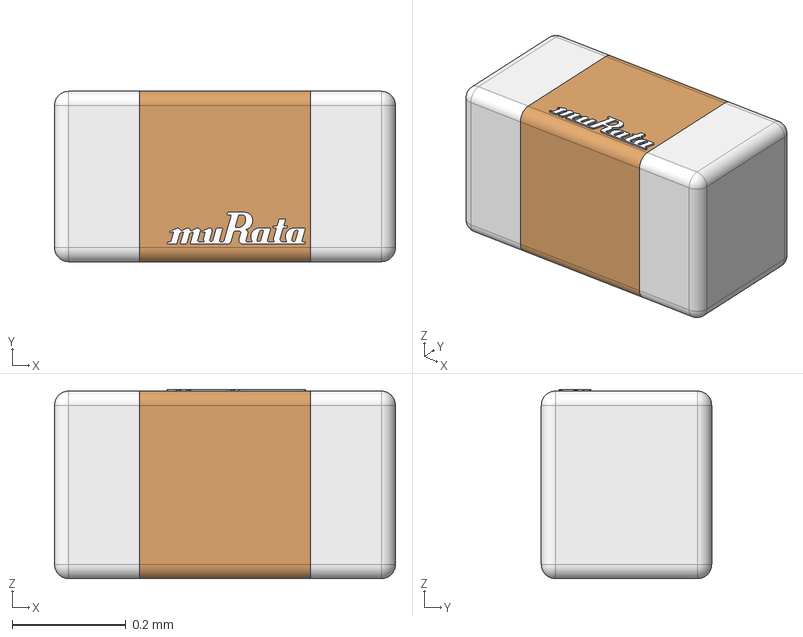
[picture p55: CAD file, 2026-10-05]
3d-models/Cap_Murata_GRM0335C1HR30BA01D_eec.STEP
0.6 x 0.3 x 0.333 mm
terminals
logo
