blues/blues-kicad-lib/3d-models/LTC2959IDDB#TRMPBF.stp

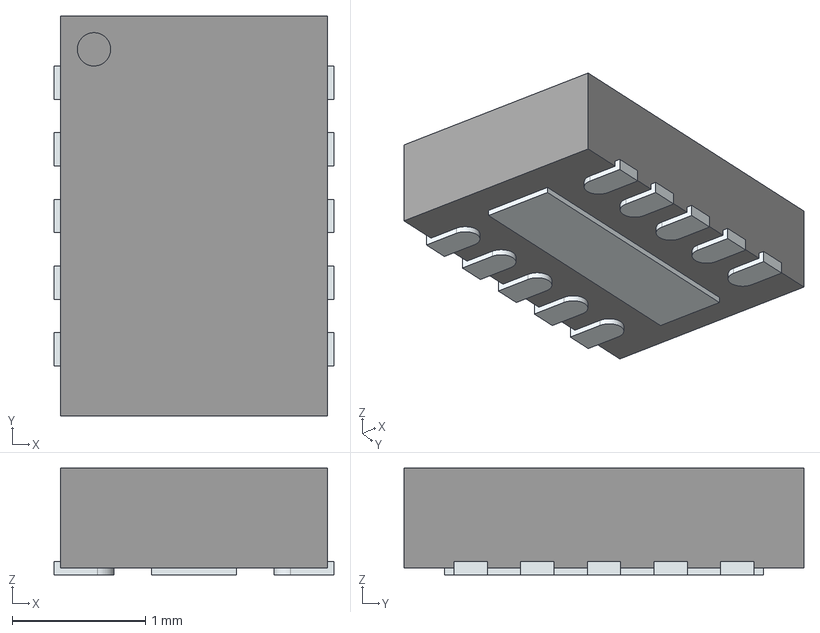
[picture p56: CAD file, 2026-10-05]
3d-models/LTC2959IDDB#TRMPBF.stp
2.10 x 3.00 x 0.8 mm
ThermalPin
PinsArrayLR
