blues/blues-kicad-lib/3d-models/BM04B-SRSS-TB.STEP

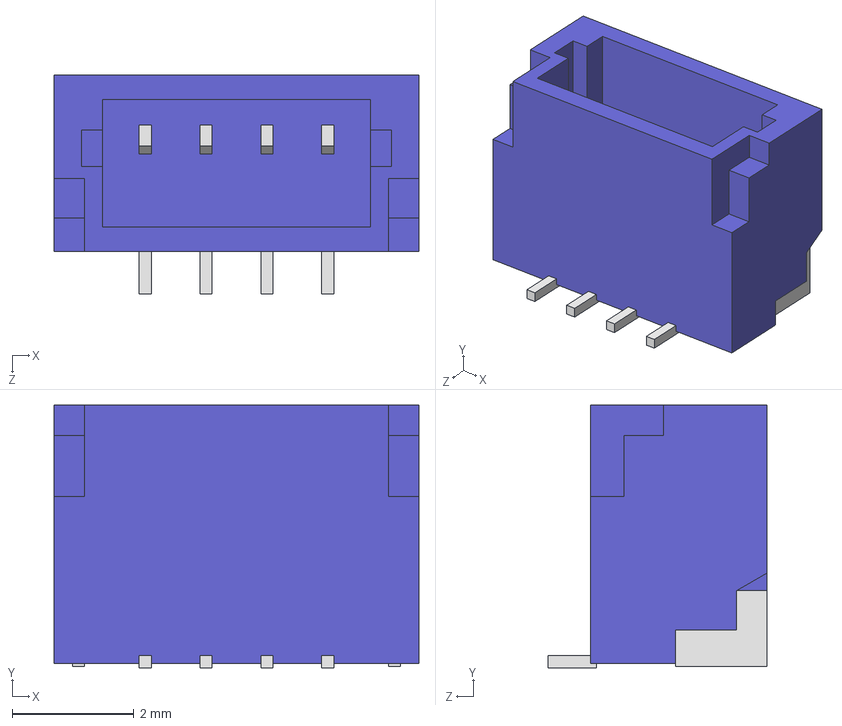
[picture p57: CAD file, 2026-10-05]
3d-models/BM04B-SRSS-TB.STEP
6.00 x 4.32 x 3.60 mm
