blues/blues-kicad-lib/3d-models/SM6T6V8A-E3_52.stp

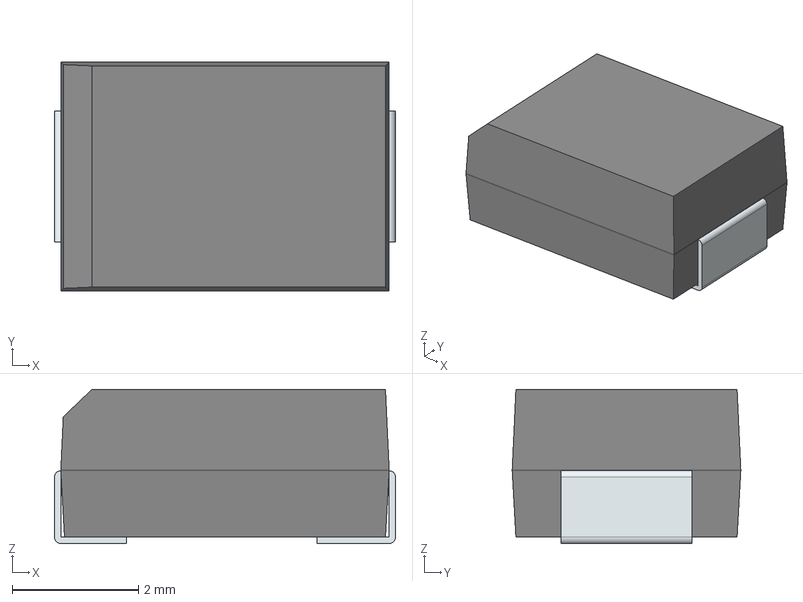
[picture p58: CAD file, 2026-09-28]
3d-models/SM6T6V8A-E3_52.stp
5.40 x 3.62 x 2.44 mm
FilletPin1
FilletPin2
