blues/blues-kicad-lib/3d-models/AMPHENOL_12402012E212A.STEP

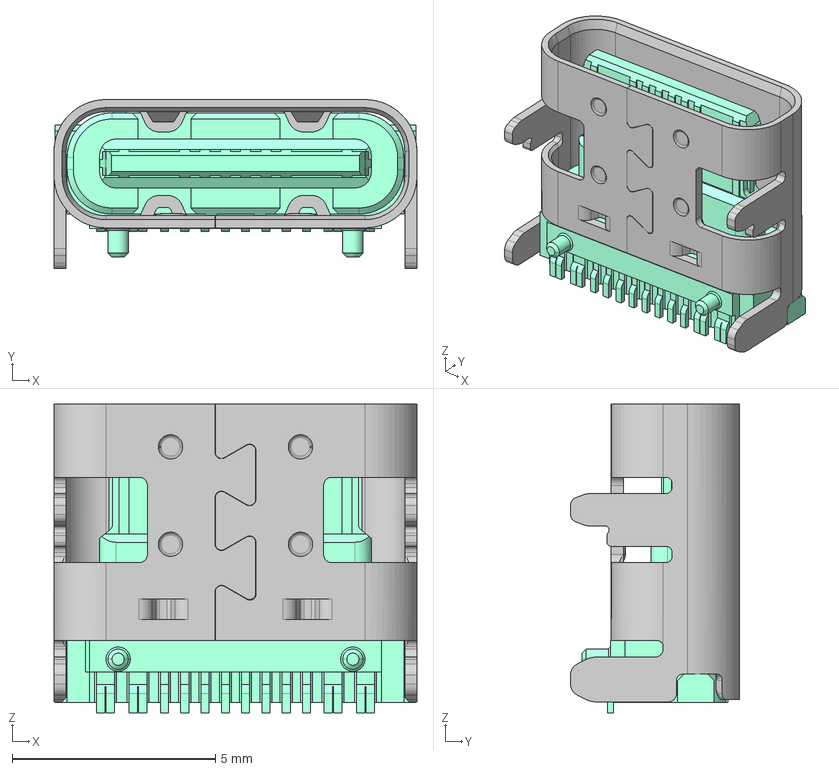
[picture p59: CAD file, 2026-09-28]
3d-models/AMPHENOL_12402012E212A.STEP
8.94 x 4.16 x 7.60 mm
