blues/blues-kicad-lib/3d-models/Conn_Samtec_FTSH-107-01-L-DV-K_eec.STEP

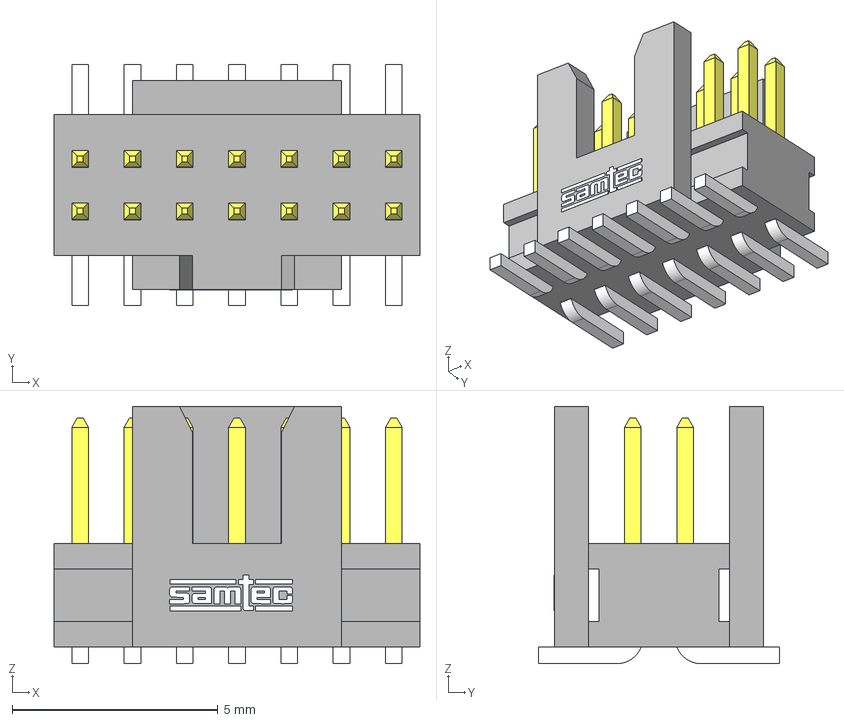
[picture p60: CAD file, 2026-09-28]
3d-models/Conn_Samtec_FTSH-107-01-L-DV-K_eec.STEP
8.89 x 5.84 x 6.25 mm
FTSH-107-01-L-DV-K_body
FTSH-107-01-L-DV-K_pins1
FTSH-107-01-L-DV-K_pins2
Samtec
