blues/blues-kicad-lib/3d-models/SKRPAD.STEP

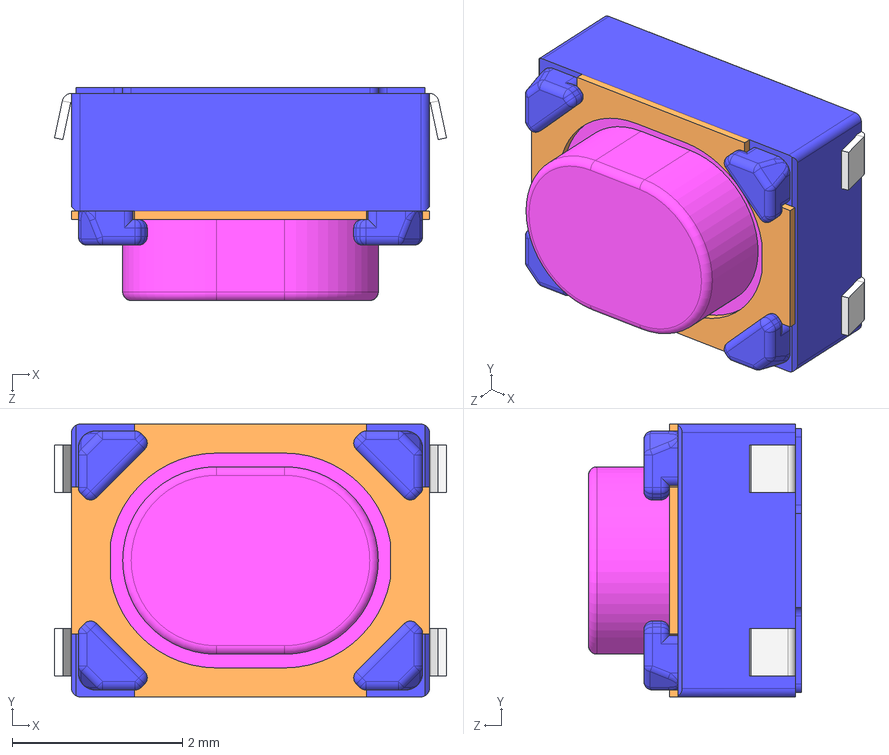
[picture p61: CAD file, 2026-09-28]
3d-models/SKRPAD.STEP
4.60 x 3.20 x 2.50 mm
