blues/blues-kicad-lib/3d-models/NOTECARD_STEP.step

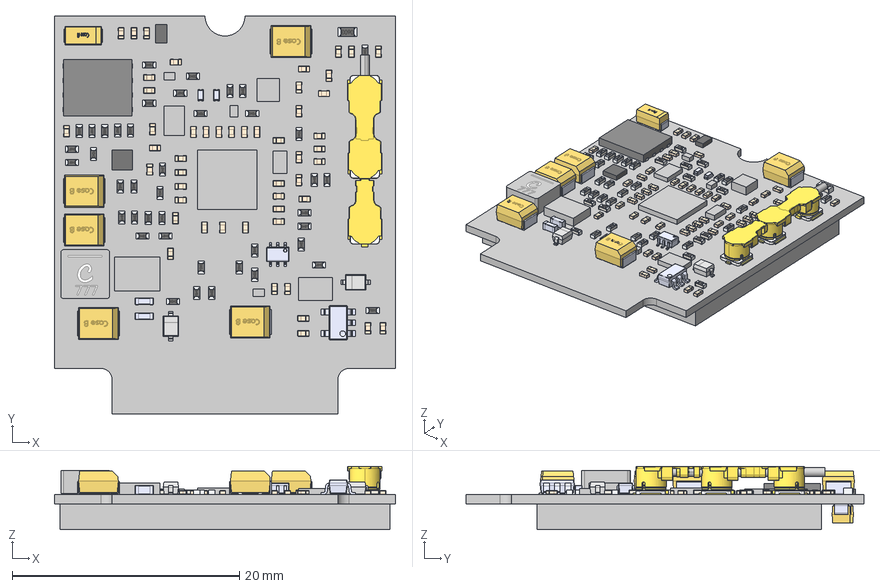
[picture p62: CAD file, 2023-12-04]
3d-models/NOTECARD_STEP.step
30.0 x 35.0 x 5.58 mm
BOARD_OUTLINE45
User Library-Tantalum Capacitor Case A_Tantalum case A part211 x 8
User Library-Tantalum Capacitor Case A_Tantalum case A part128 x 4
Document40
Document48
User Library-RES_1609-0603
Document32
Document44 x 3
User Library-Tantalum Capacitor Case B_Tantalum case B part126 x 5
User Library-Tantalum Capacitor Case B_Tantalum case B part29 x 10
UFDFN3 x 3
Document2021
Document1617
Document67
Document38
Document42
User Library-led_0402 x 2
User Library-DFN8-5X6_Pad004
User Library-DFN8-5X6_Pad009
User Library-DFN8-5X6_Pad007
User Library-DFN8-5X6_Pad001
User Library-DFN8-5X6_Pad006
User Library-DFN8-5X6_Pad
User Library-DFN8-5X6_Pad008
User Library-DFN8-5X6_Pad003
User Library-DFN8-5X6_Pad002
User Library-DFN8-5X6_Pad005
Cubo46
SW3dPS-SW3dPS-SOT363
User Library-SOT23-5-1
User Library-0402C24
User Library-SOD323-1 x 2
Document36
User Library-cap_0603_lowprofile34 x 2
Document23
User Library-RES_1005-040213 x 42
User Library-0402C30 x 49
