blues/blues-kicad-lib/3d-models/J-20X2-0254-FDT-SSQX03.step

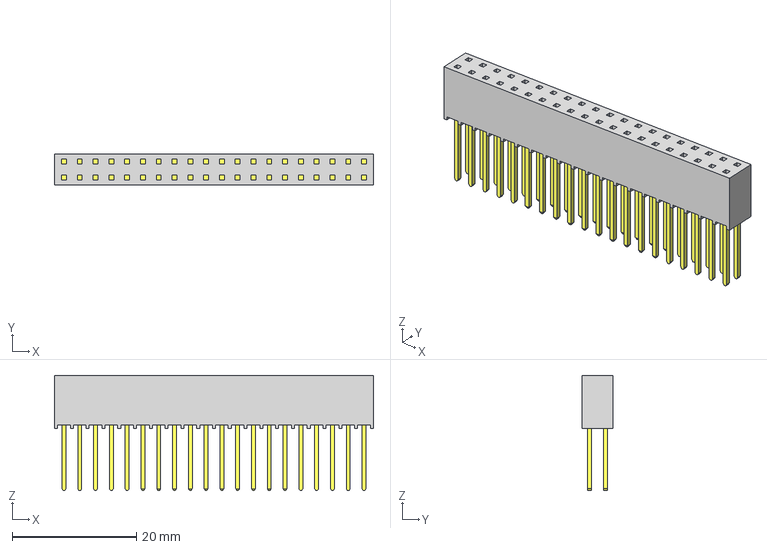
[picture p63: CAD file, 2023-12-04]
3d-models/J-20X2-0254-FDT-SSQX03.step
51.3 x 4.95 x 18.5 mm
_T1SSQ-120-03-G-D
_P2SSQ-120-03-G-D
