blues/blues-kicad-lib/3d-models/DSS-CHS-01TB.step

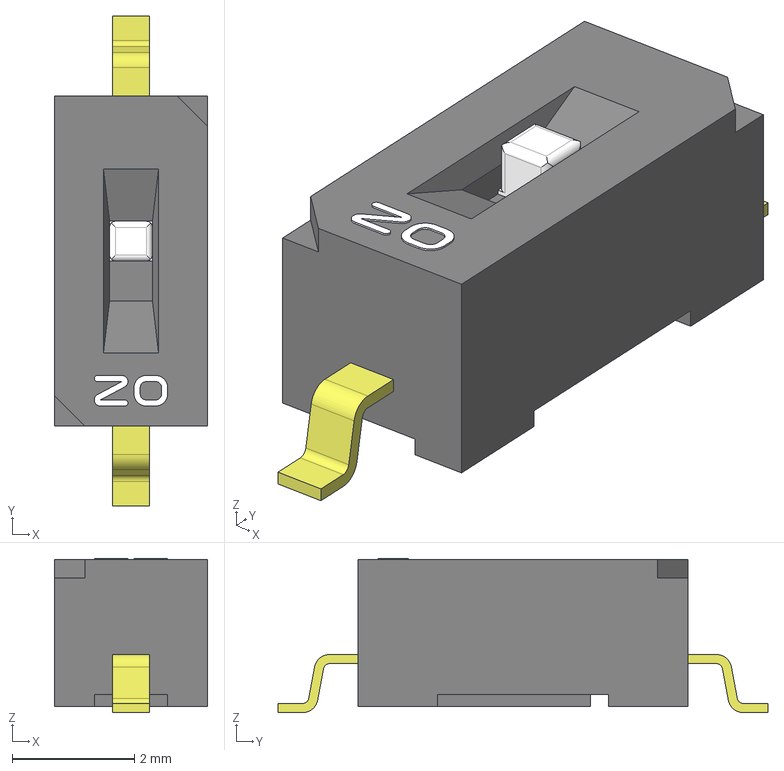
[picture p64: CAD file, 2023-12-04]
3d-models/DSS-CHS-01TB.step
2.50 x 8.00 x 2.52 mm
_CHS-01-G-body
_CHS-slider
