blues/blues-kicad-lib/3d-models/CS-T-B.step

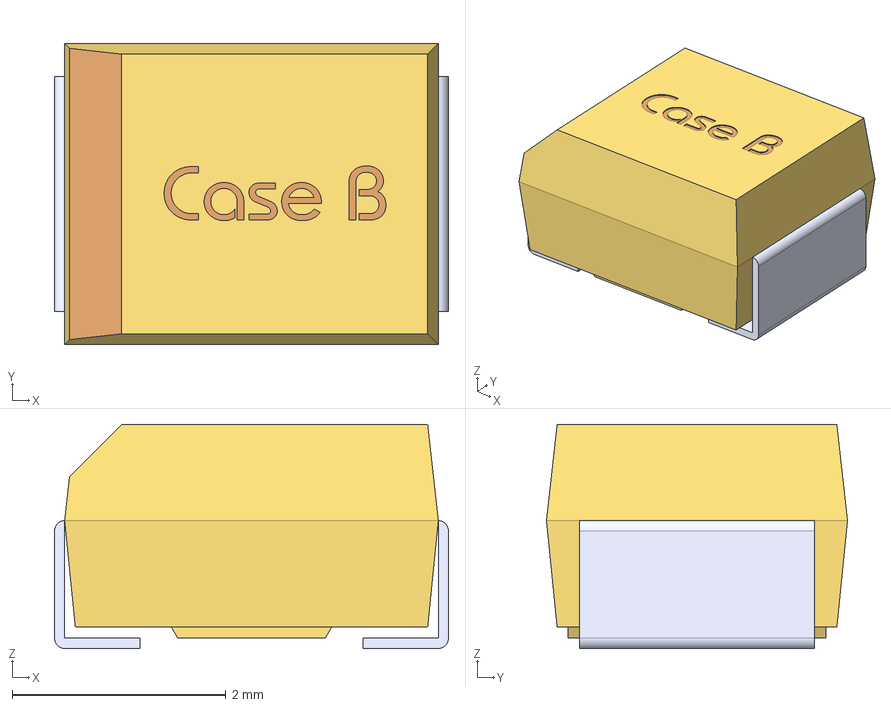
[picture p65: CAD file, 2023-12-04]
3d-models/CS-T-B.step
3.69 x 2.82 x 2.10 mm
User Library-Tantalum Capacitor Case B_Tantalum case B part1
User Library-Tantalum Capacitor Case B_Tantalum case B part2 x 2
