blues/blues-kicad-lib/3d-models/C-0402.step

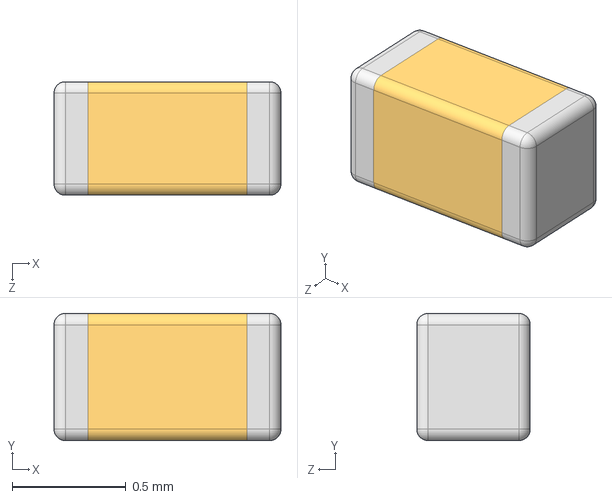
[picture p66: CAD file, 2023-12-04]
3d-models/C-0402.step
1.00 x 0.56 x 0.5 mm
