blues/blues-kicad-lib/3d-models/21-0164_L622+1C_MXM.step

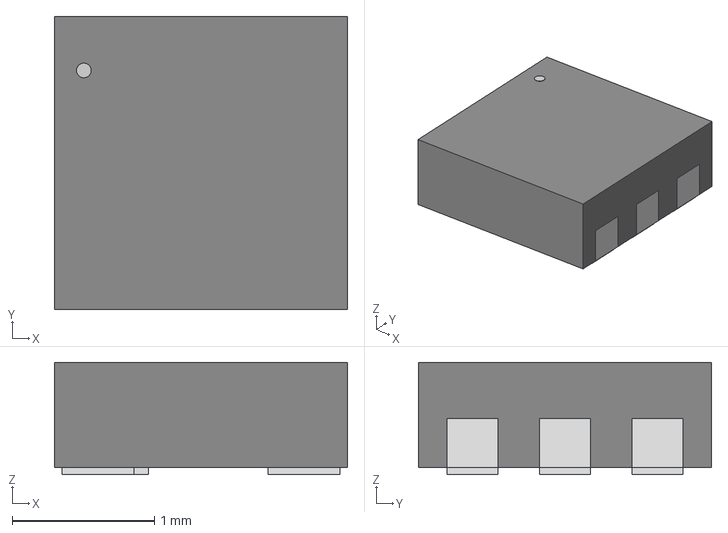
[picture p67: CAD file, 2023-12-04]
3d-models/21-0164_L622+1C_MXM.step
2.06 x 2.06 x 0.79 mm
