blues/blues-kicad-lib/3d-models/SOT23.step

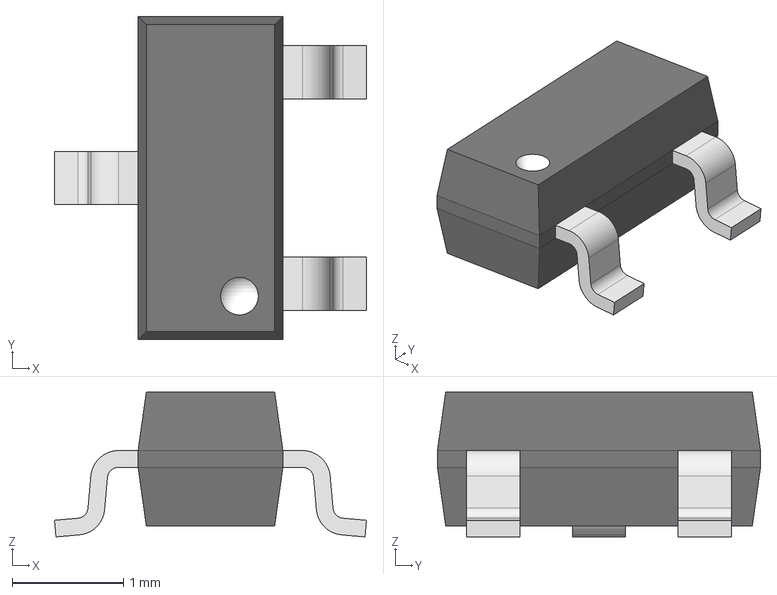
[picture p68: CAD file, 2023-12-04]
3d-models/SOT23.step
2.80 x 2.90 x 1.30 mm
