blues/blues-kicad-lib/3d-models/CAP FILM - 0805.step

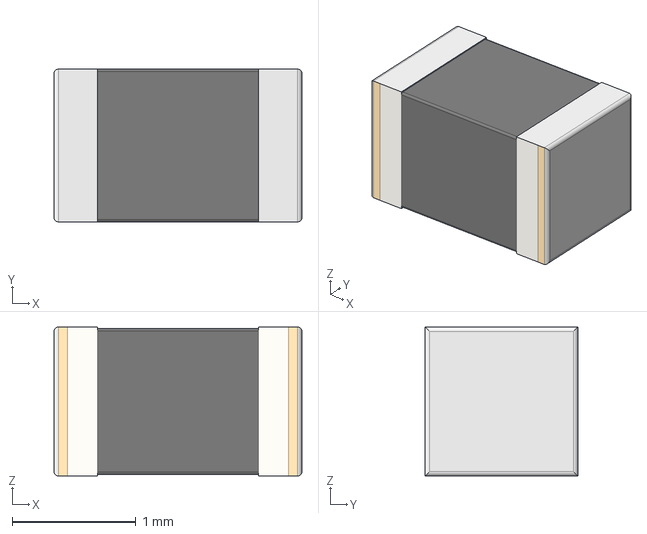
[picture p69: CAD file, 2023-12-04]
3d-models/CAP FILM - 0805.step
2.00 x 1.23 x 1.20 mm
