blues/blues-kicad-lib/3d-models/FRACTUS-0404.step

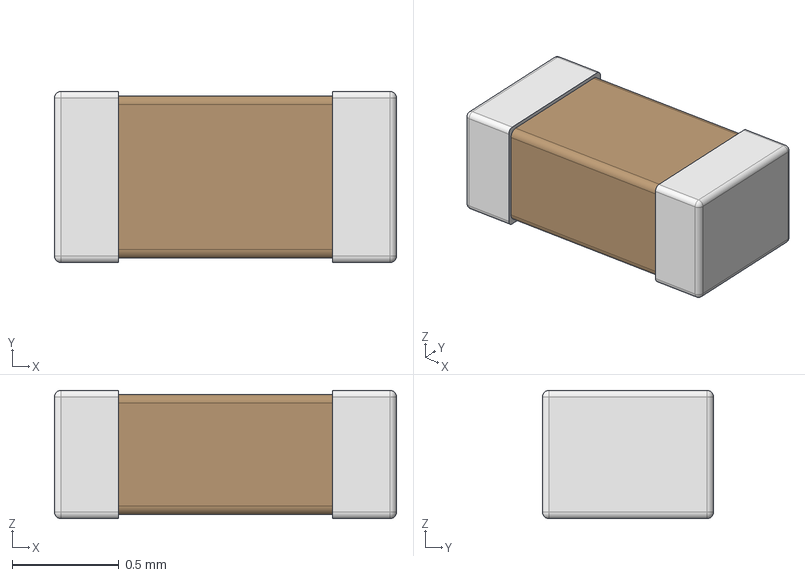
[picture p70: CAD file, 2023-12-04]
3d-models/FRACTUS-0404.step
1.60 x 0.8 x 0.6 mm
