blues/blues-kicad-lib/3d-models/SW-CJS1200TA.step

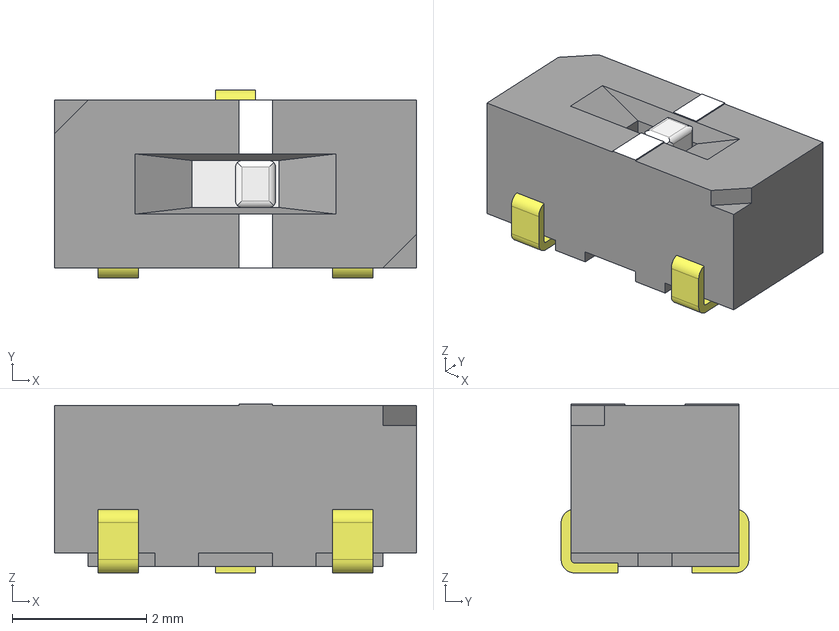
[picture p71: CAD file, 2023-12-04]
3d-models/SW-CJS1200TA.step
5.40 x 2.80 x 2.52 mm
_CJS_c_11
_CJS Slider_s
