blues/blues-kicad-lib/3d-models/S2B-PH-SM4-TB_CX17.STEP

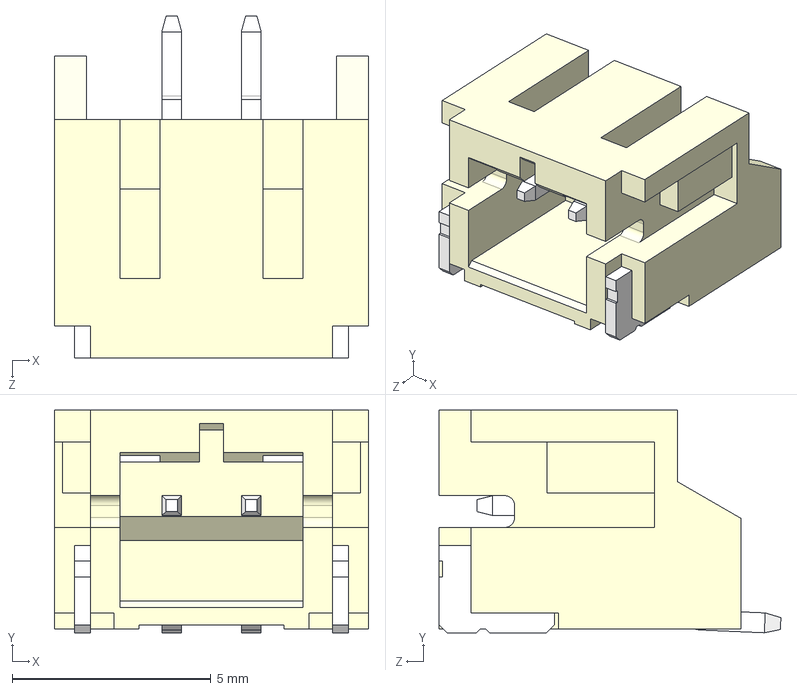
[picture p72: CAD file, 2023-12-04]
3d-models/S2B-PH-SM4-TB_CX17.STEP
7.90 x 5.60 x 8.60 mm
