blues/blues-kicad-lib/3d-models/LS-0806.step

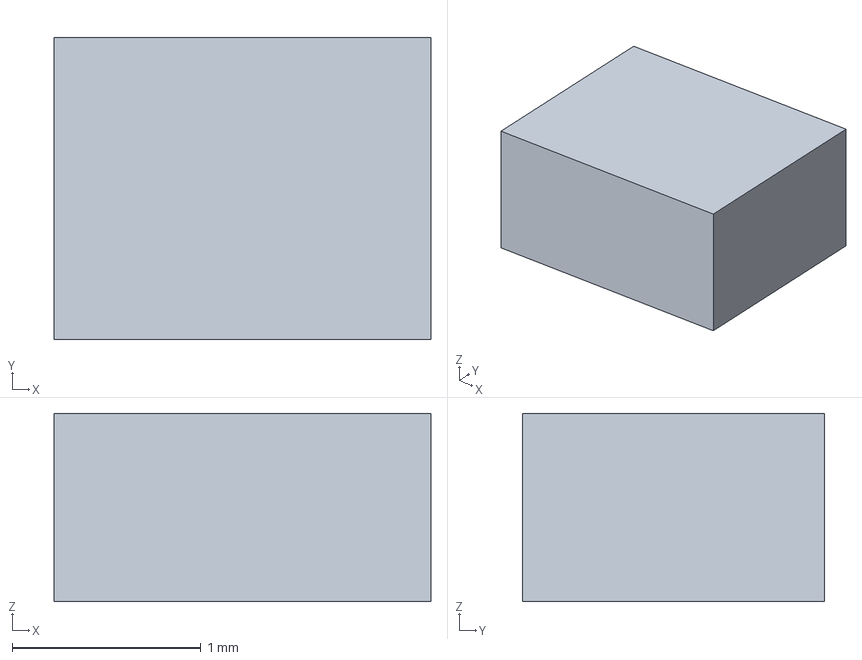
[picture p73: CAD file, 2023-12-04]
3d-models/LS-0806.step
2.00 x 1.60 x 1.00 mm
