blues/blues-kicad-lib/3d-models/CES-112-01-L-S.stp

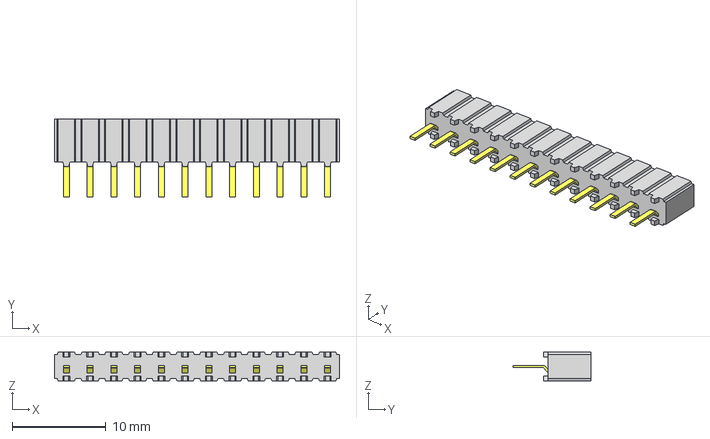
[picture p74: CAD file, 2023-12-04]
3d-models/CES-112-01-L-S.stp
30.5 x 8.33 x 3.05 mm
_CES-112-01-S_socket
_011201S
