blues/blues-kicad-lib/3d-models/LD-0402.step

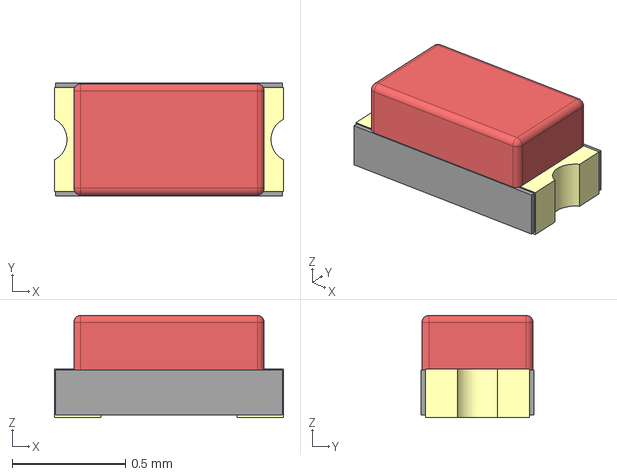
[picture p75: CAD file, 2023-12-04]
3d-models/LD-0402.step
1.01 x 0.5 x 0.45 mm
