blues/blues-kicad-lib/3d-models/0603 cap.STEP

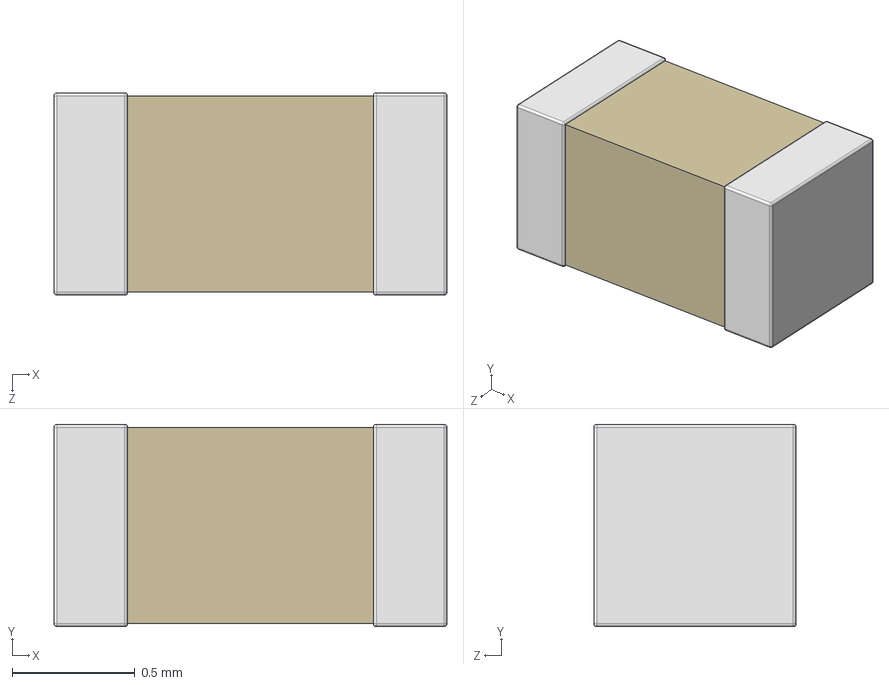
[picture p76: CAD file, 2023-12-04]
3d-models/0603 cap.STEP
1.60 x 0.824 x 0.824 mm
