blues/blues-kicad-lib/3d-models/SMB.step

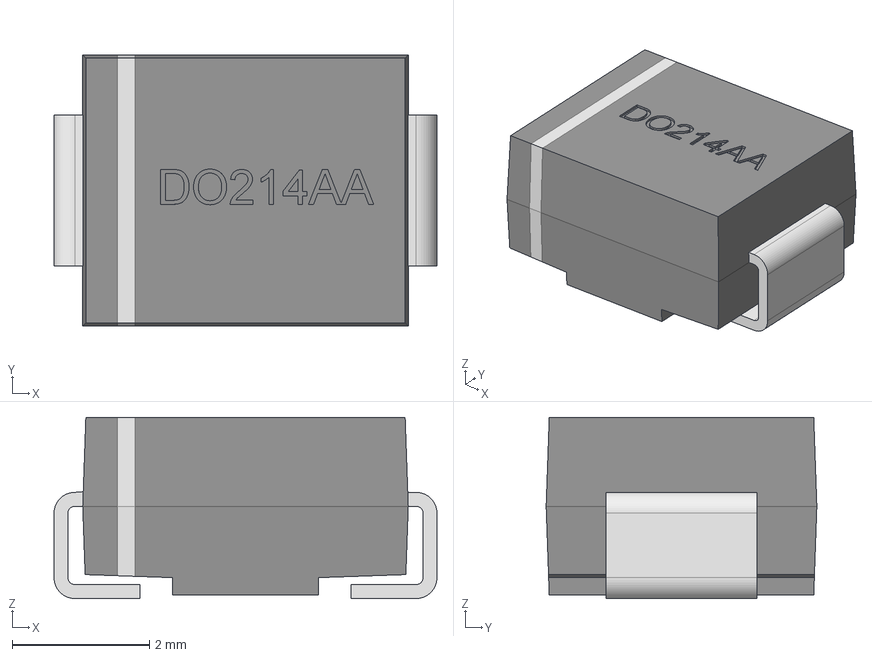
[picture p77: CAD file, 2023-12-04]
3d-models/SMB.step
5.59 x 3.95 x 2.64 mm
