blues/blues-kicad-lib/3d-models/CES-116-01-L-S.stp

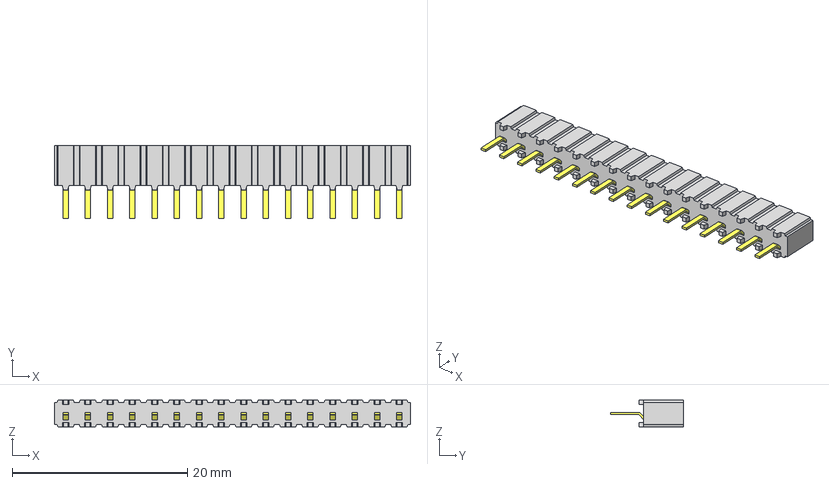
[picture p78: CAD file, 2023-12-04]
3d-models/CES-116-01-L-S.stp
40.6 x 8.33 x 3.05 mm
_CES-116-01-S_socket
_011601S
