blues/blues-kicad-lib/3d-models/J-5-0065-FOS-USB10118192-NOF.step

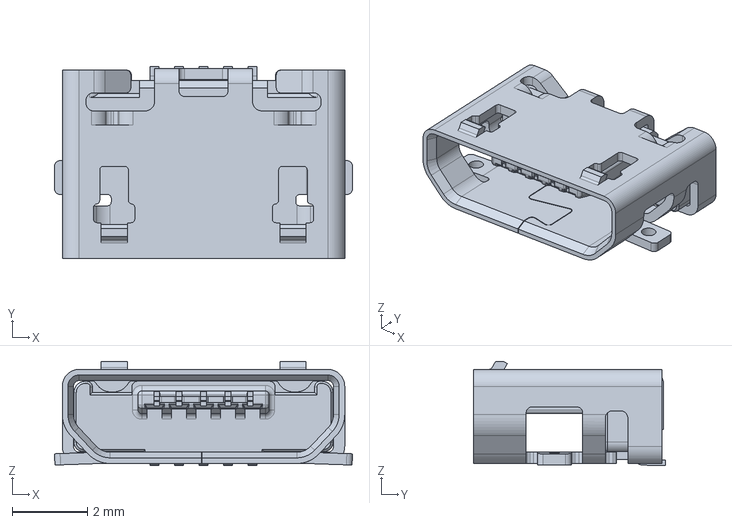
[picture p79: CAD file, 2023-12-04]
3d-models/J-5-0065-FOS-USB10118192-NOF.step
7.91 x 5.10 x 2.77 mm
