blues/blues-kicad-lib/3d-models/RS-0402.step

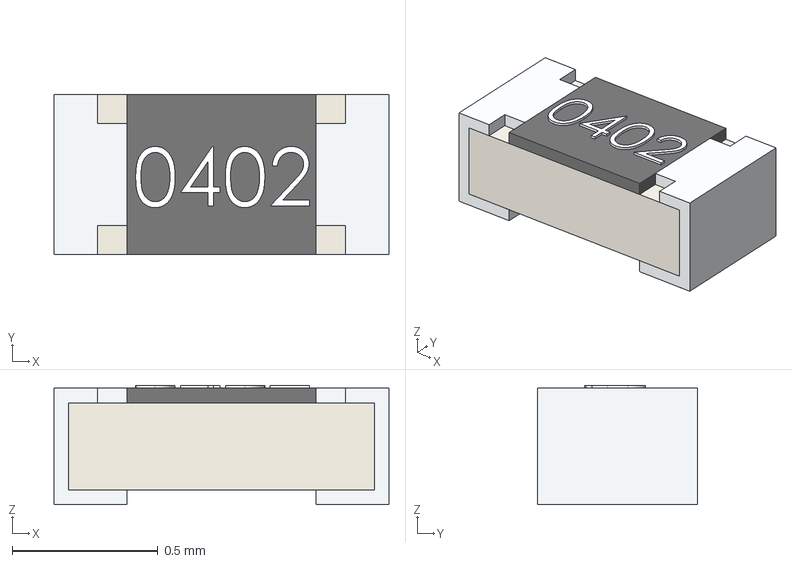
[picture p80: CAD file, 2023-12-04]
3d-models/RS-0402.step
1.15 x 0.55 x 0.41 mm
