blues/blues-kicad-lib/3d-models/XFDFN6.step

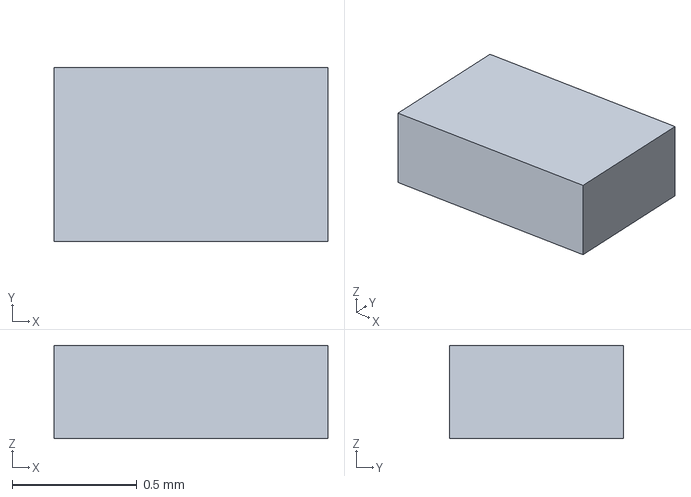
[picture p81: CAD file, 2023-12-04]
3d-models/XFDFN6.step
1.10 x 0.7 x 0.375 mm
