blues/blues-kicad-lib/3d-models/J-22-0254-FDT-H0508_EDGE.step

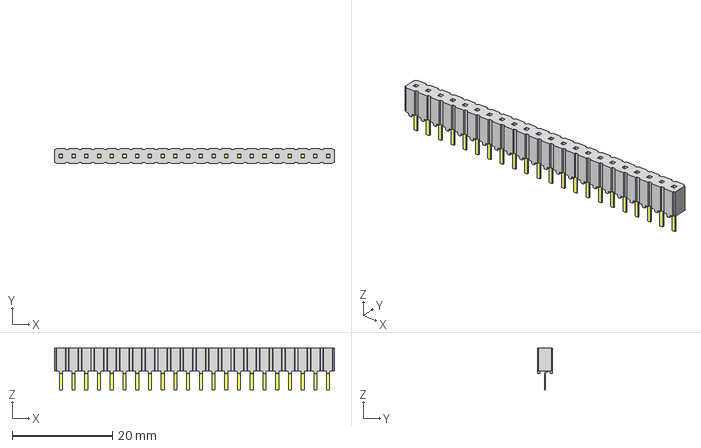
[picture p82: CAD file, 2023-12-04]
3d-models/J-22-0254-FDT-H0508_EDGE.step
55.9 x 3.05 x 8.33 mm
_CES-122-01-S_socket
_012201S
