blues/blues-kicad-lib/3d-models/TO277-3.step

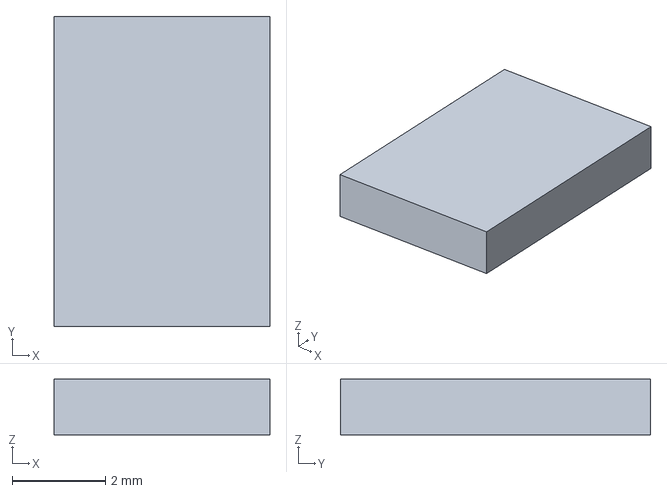
[picture p83: CAD file, 2023-12-04]
3d-models/TO277-3.step
4.63 x 6.65 x 1.20 mm
