blues/blues-kicad-lib/3d-models/cay_16-f4.stp

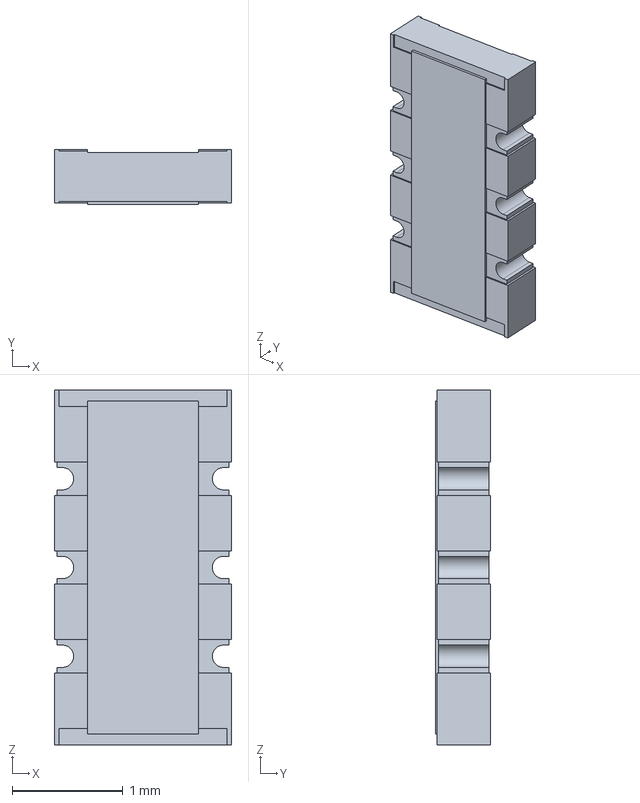
[picture p84: CAD file, 2023-12-04]
3d-models/cay_16-f4.stp
1.60 x 0.5 x 3.20 mm
