blues/blues-kicad-lib/3d-models/J-NANOSIM-SF72S006VBA.stp

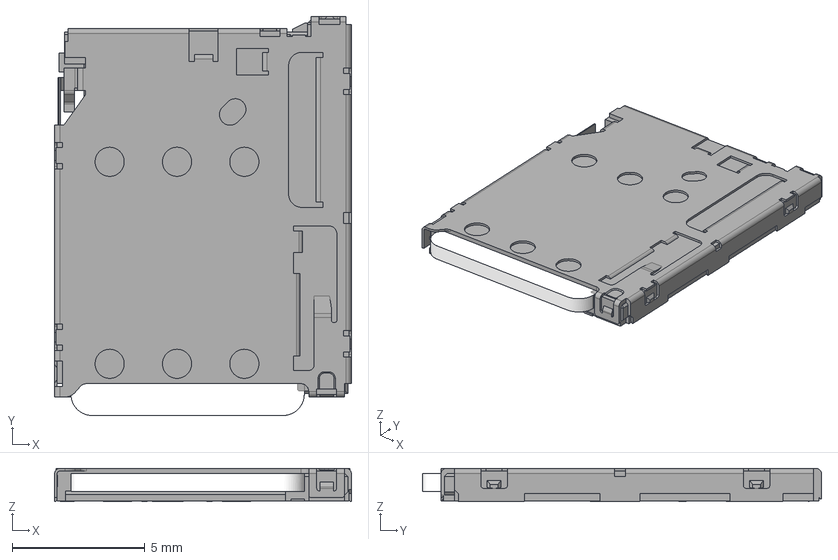
[picture p85: CAD file, 2023-12-04]
3d-models/J-NANOSIM-SF72S006VBA.stp
11.2 x 15.1 x 1.25 mm
