blues/blues-kicad-lib/3d-models/J-4-0200-MOS-GROVE.step

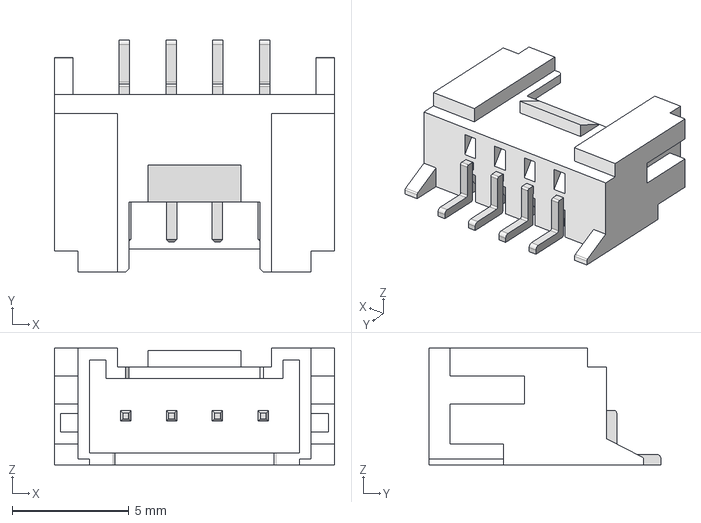
[picture p86: CAD file, 2023-12-04]
3d-models/J-4-0200-MOS-GROVE.step
12.0 x 9.95 x 5.00 mm
