blues/blues-kicad-lib/3d-models/JST SM04B-SRSS-TB.STEP

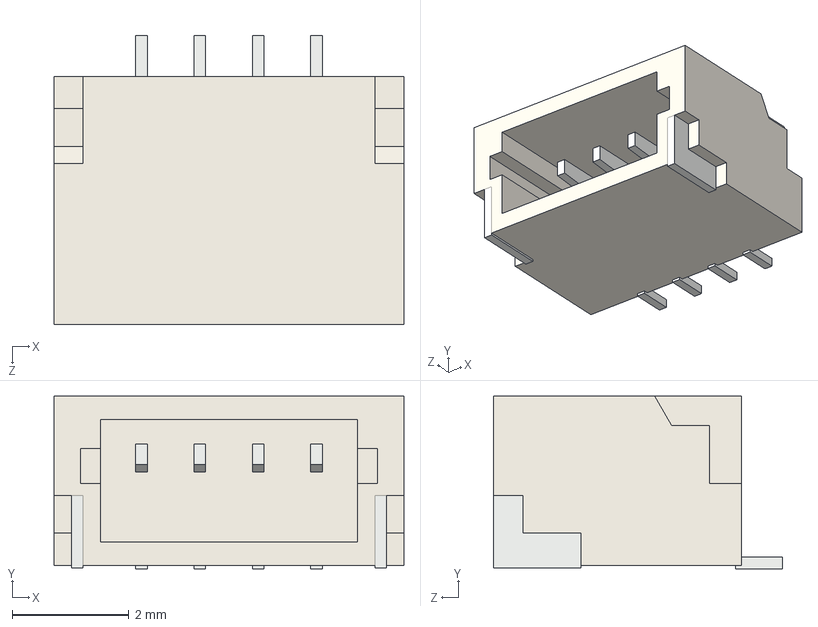
[picture p87: CAD file, 2023-12-04]
3d-models/JST SM04B-SRSS-TB.STEP
6.00 x 2.96 x 4.95 mm
