blues/blues-kicad-lib/3d-models/J-75-0050-MOS-M2-E.step

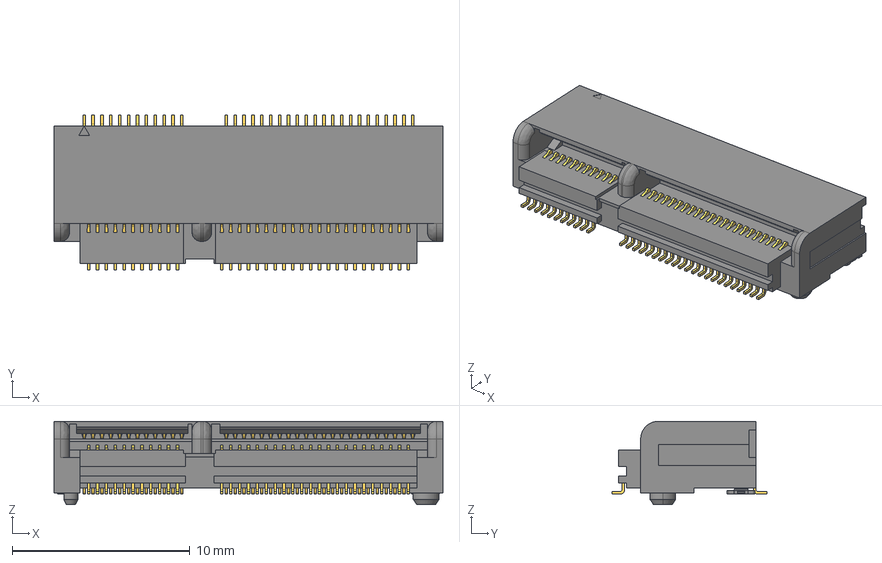
[picture p88: CAD file, 2023-12-04]
3d-models/J-75-0050-MOS-M2-E.step
21.9 x 8.70 x 4.70 mm
