blues/blues-kicad-lib/3d-models/CS-T-A.step

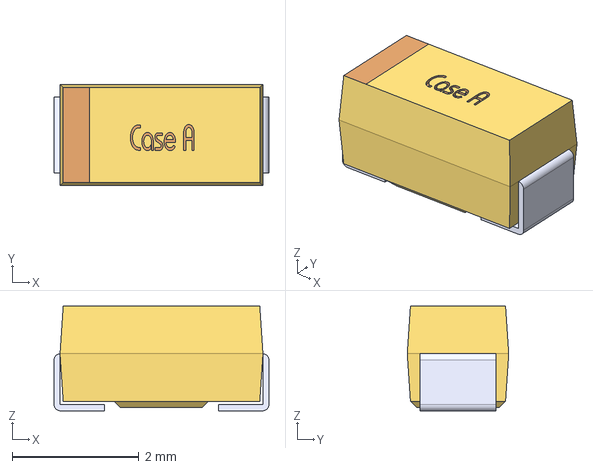
[picture p89: CAD file, 2023-12-04]
3d-models/CS-T-A.step
3.39 x 1.60 x 1.65 mm
User Library-Tantalum Capacitor Case A_Tantalum case A part1
User Library-Tantalum Capacitor Case A_Tantalum case A part2 x 2
