blues/blues-kicad-lib/3d-models/0402 cap.STEP

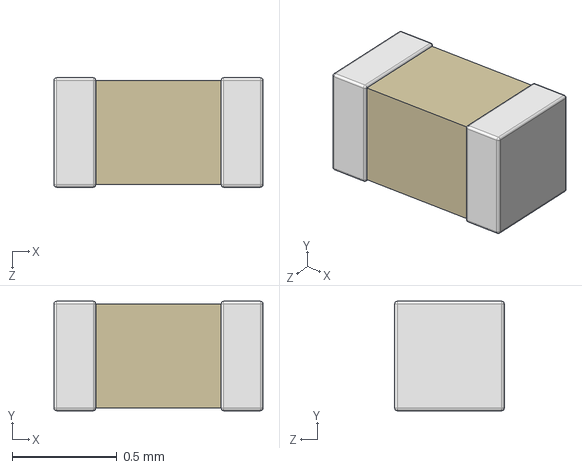
[picture p90: CAD file, 2023-12-04]
3d-models/0402 cap.STEP
1.00 x 0.524 x 0.524 mm
