blues/blues-kicad-lib/3d-models/RESC1005X38N EIA 0402.step

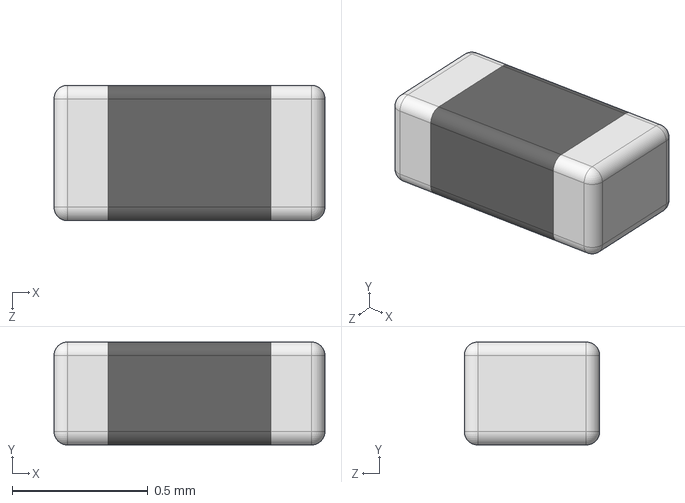
[picture p91: CAD file, 2023-12-04]
3d-models/RESC1005X38N EIA 0402.step
1 x 0.38 x 0.5 mm
