blues/blues-kicad-lib/3d-models/C-0603.step

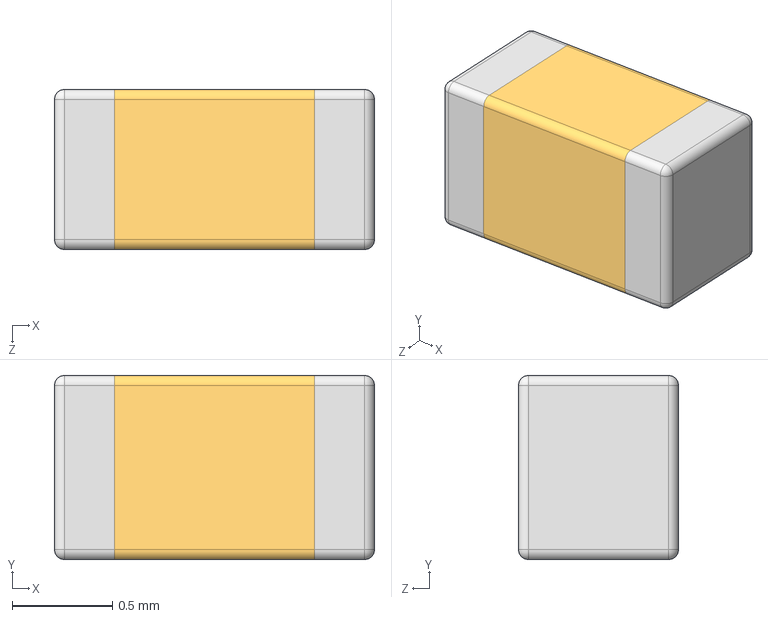
[picture p92: CAD file, 2023-12-04]
3d-models/C-0603.step
1.60 x 0.92 x 0.8 mm
