blues/blues-kicad-lib/3d-models/C&K - PTS810.step

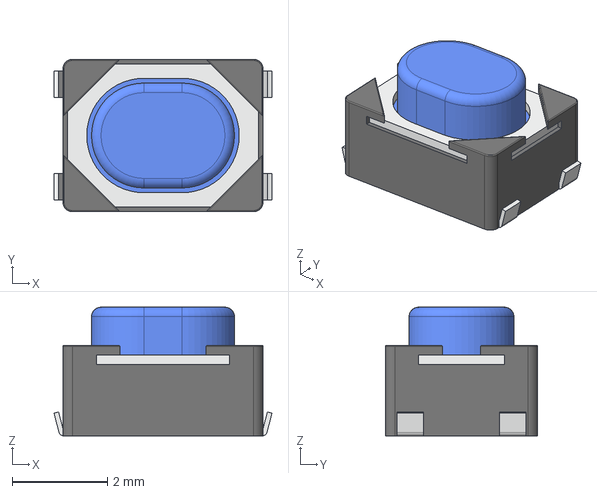
[picture p93: CAD file, 2023-12-04]
3d-models/C&K - PTS810.step
4.58 x 3.20 x 2.70 mm
