blues/blues-kicad-lib/3d-models/RS-1206.step

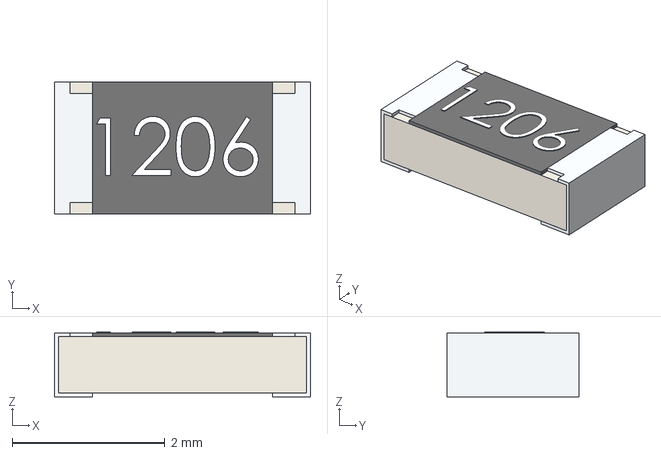
[picture p94: CAD file, 2023-12-04]
3d-models/RS-1206.step
3.35 x 1.73 x 0.85 mm
