blues/blues-kicad-lib/3d-models/VCHA042A-1R5MS6.step

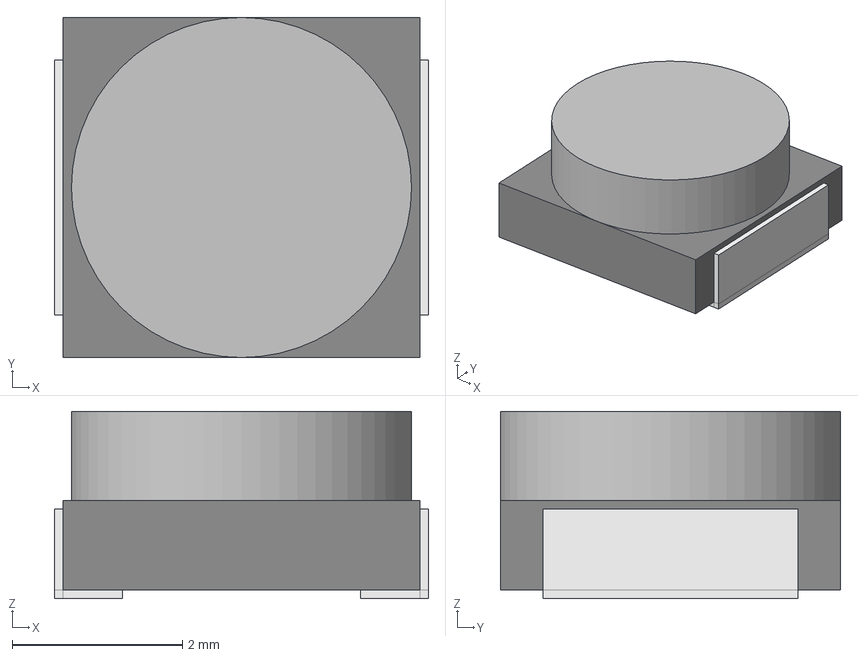
[picture p95: CAD file, 2023-12-04]
3d-models/VCHA042A-1R5MS6.step
4.40 x 4.00 x 2.20 mm
