blues/blues-kicad-lib/3d-models/J-2-0200-MDS-B2B-PH-SM4.step

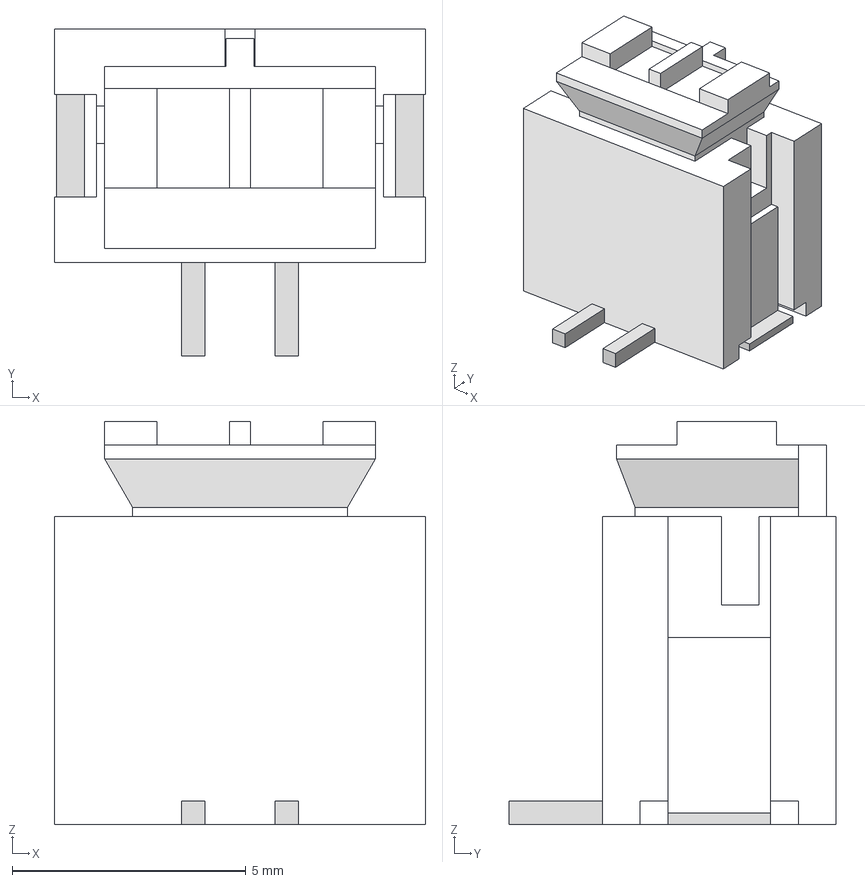
[picture p97: CAD file, 2023-12-04]
3d-models/J-2-0200-MDS-B2B-PH-SM4.step
7.95 x 7.00 x 8.63 mm
