blues/blues-kicad-lib/3d-models/User Library-EVPBB2A9B000.STEP

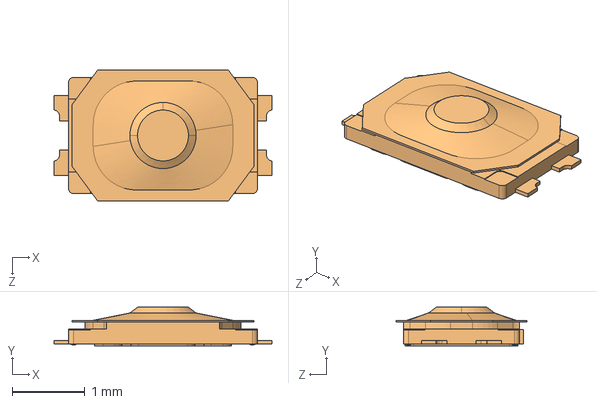
[picture p98: CAD file, 2023-12-04]
3d-models/User Library-EVPBB2A9B000.STEP
3.00 x 0.53 x 1.80 mm
