blues/blues-kicad-lib/3d-models/DO214AA SMB.STEP

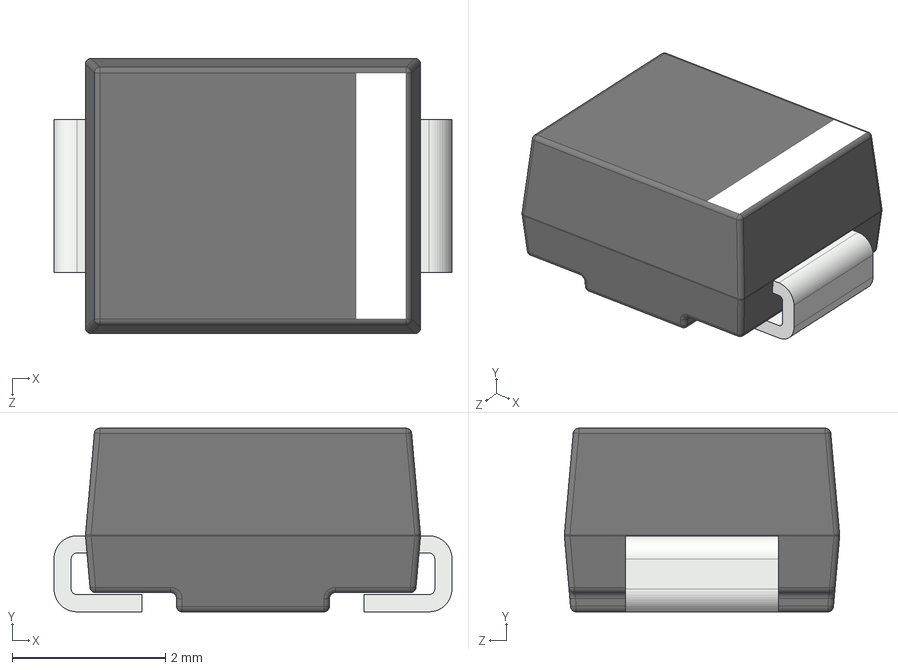
[picture p99: CAD file, 2023-12-04]
3d-models/DO214AA SMB.STEP
5.20 x 2.40 x 3.60 mm
