blues/blues-kicad-lib/3d-models/CES-124-01-S-S.stp

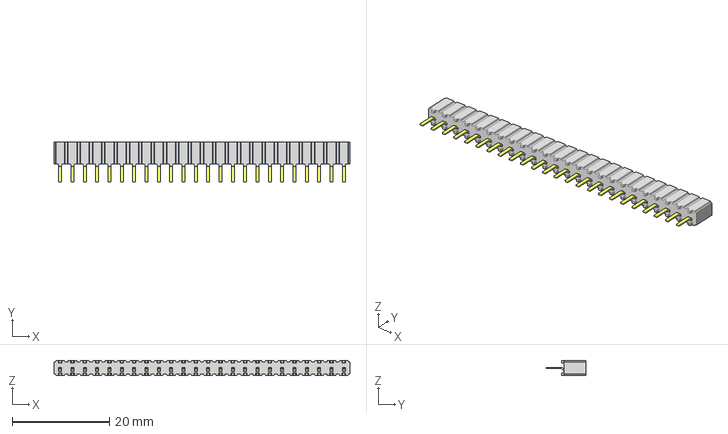
[picture p100: CAD file, 2023-12-04]
3d-models/CES-124-01-S-S.stp
61.0 x 8.33 x 3.05 mm
_CES-124-01-S_socket
_012401S
