blues/blues-kicad-lib/3d-models/RR-8X-1506.step

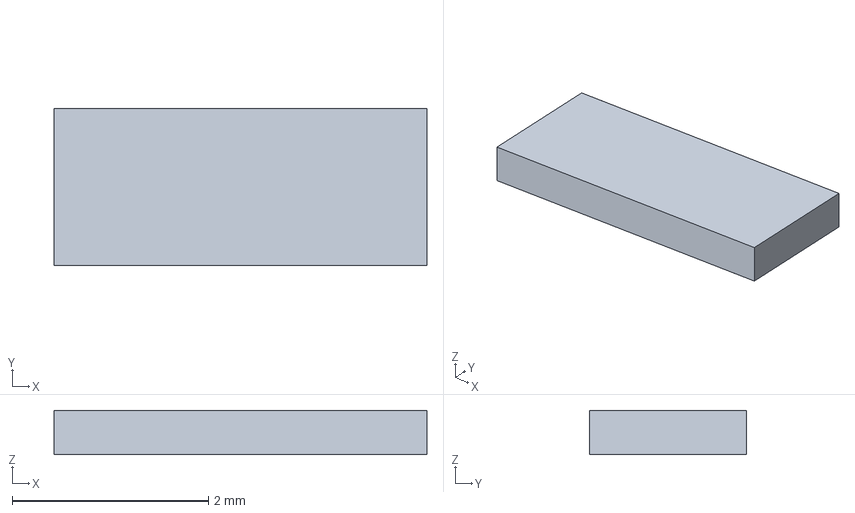
[picture p101: CAD file, 2023-12-04]
3d-models/RR-8X-1506.step
3.80 x 1.60 x 0.45 mm
