blues/blues-kicad-lib/3d-models/RS-0201.step

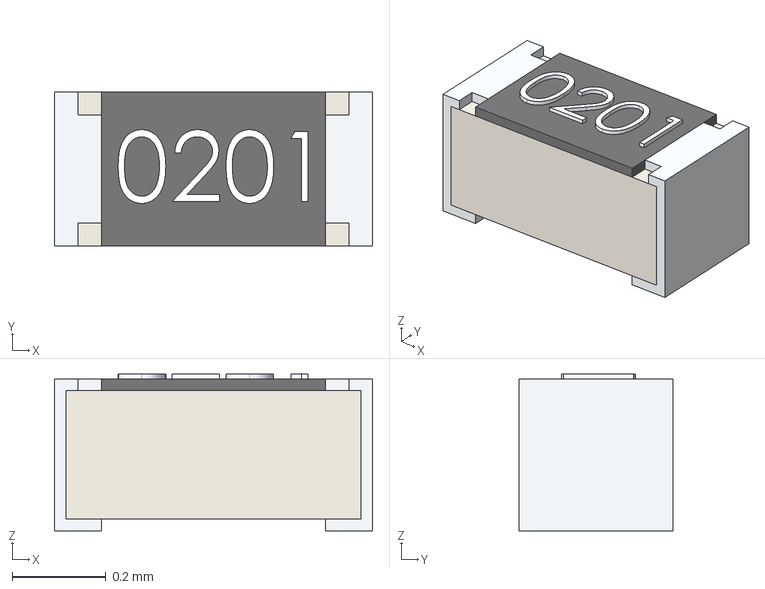
[picture p102: CAD file, 2023-12-04]
3d-models/RS-0201.step
0.68 x 0.33 x 0.335 mm
