blues/blues-kicad-lib/3d-models/SOT666.stp

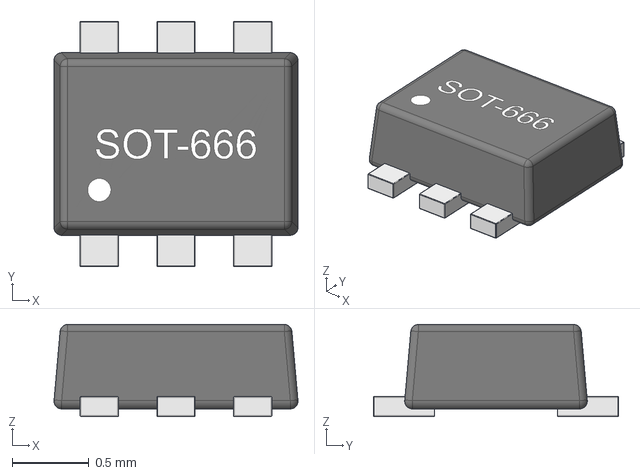
[picture p103: CAD file, 2023-12-04]
3d-models/SOT666.stp
1.59 x 1.60 x 0.6 mm
