blues/blues-kicad-lib/3d-models/D-DO216AA.step

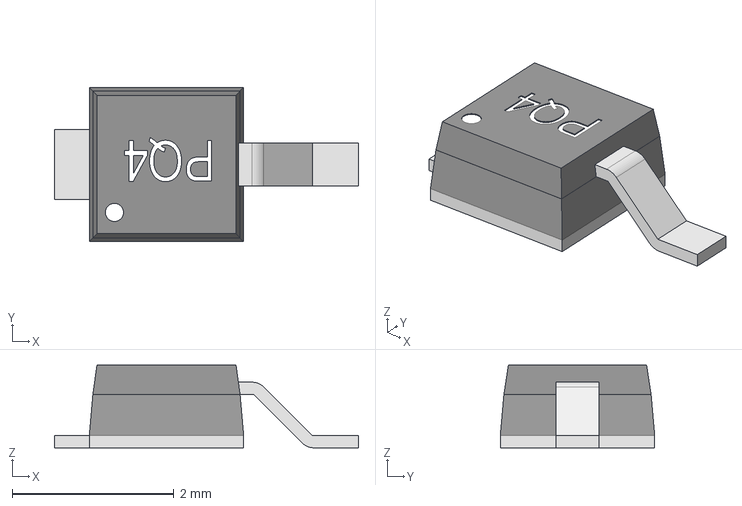
[picture p104: CAD file, 2023-12-04]
3d-models/D-DO216AA.step
3.76 x 1.91 x 1.02 mm
