blues/blues-kicad-lib/3d-models/miniqfn16 v0.step

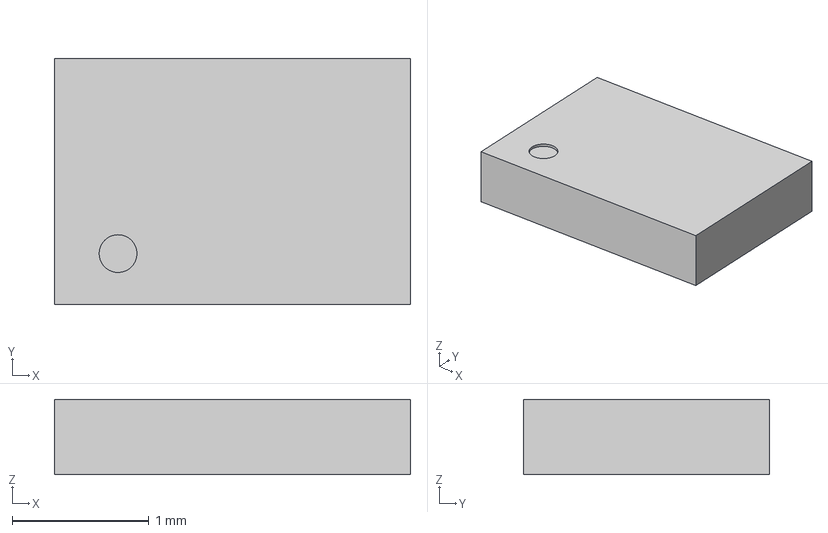
[picture p105: CAD file, 2023-12-04]
3d-models/miniqfn16 v0.step
2.60 x 1.80 x 0.55 mm
