blues/blues-kicad-lib/3d-models/VFDFN8-EXP.step

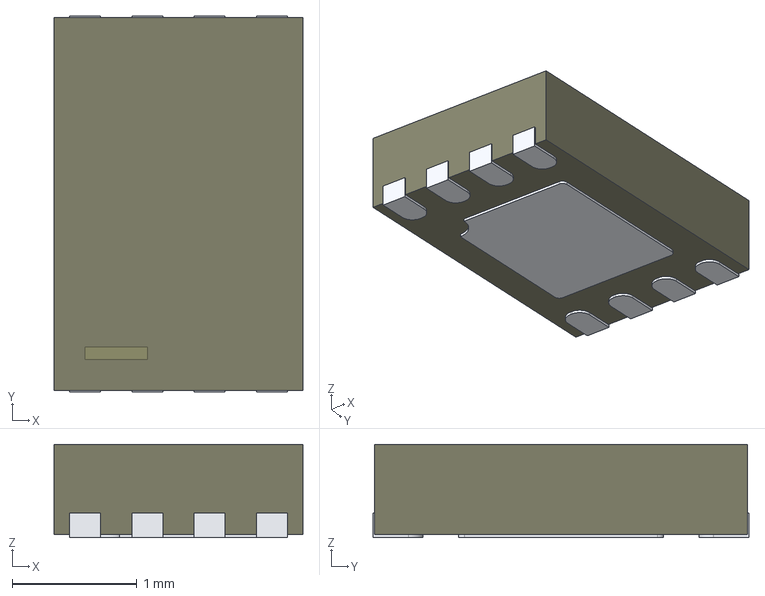
[picture p106: CAD file, 2023-12-04]
3d-models/VFDFN8-EXP.step
2.00 x 3.02 x 0.75 mm
