blues/blues-kicad-lib/3d-models/CAP 1206-0.8mm.STEP

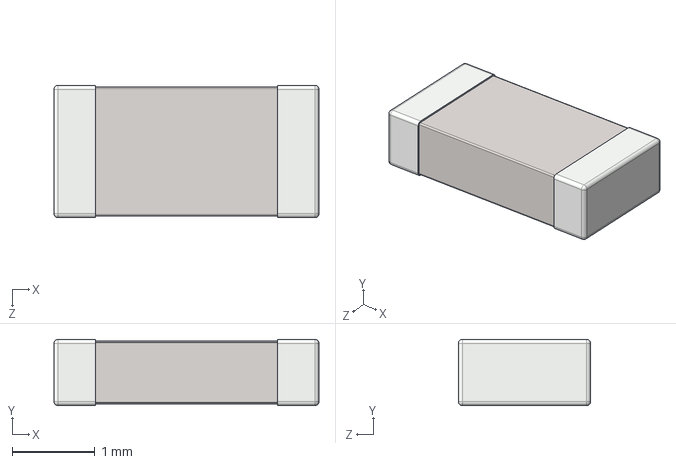
[picture p107: CAD file, 2023-12-04]
3d-models/CAP 1206-0.8mm.STEP
3.20 x 0.8 x 1.60 mm
