blues/blues-kicad-lib/3d-models/J-3-0254-FDT-H0508.step

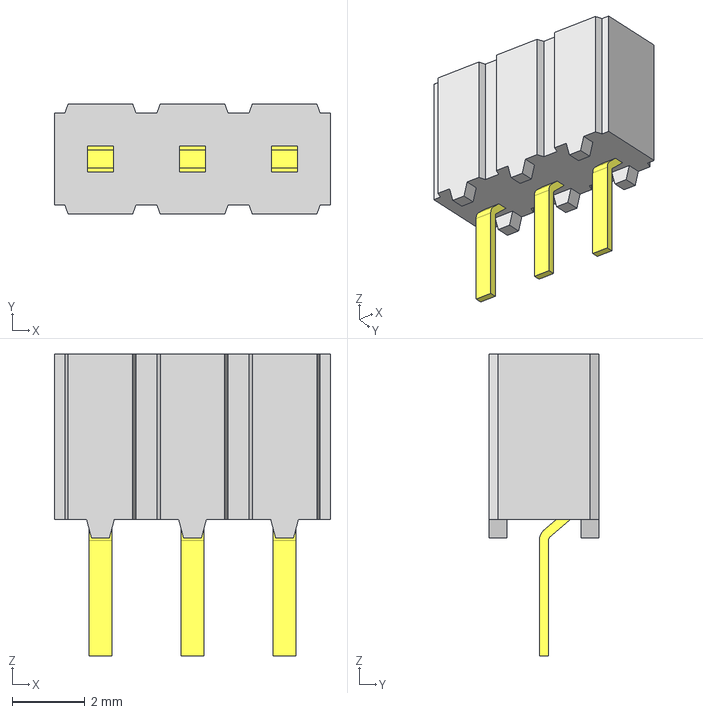
[picture p108: CAD file, 2023-12-04]
3d-models/J-3-0254-FDT-H0508.step
7.62 x 3.05 x 8.33 mm
_CES-103-01-S_socket
_010301S
