blues/blues-kicad-lib/3d-models/XFBGA8.step

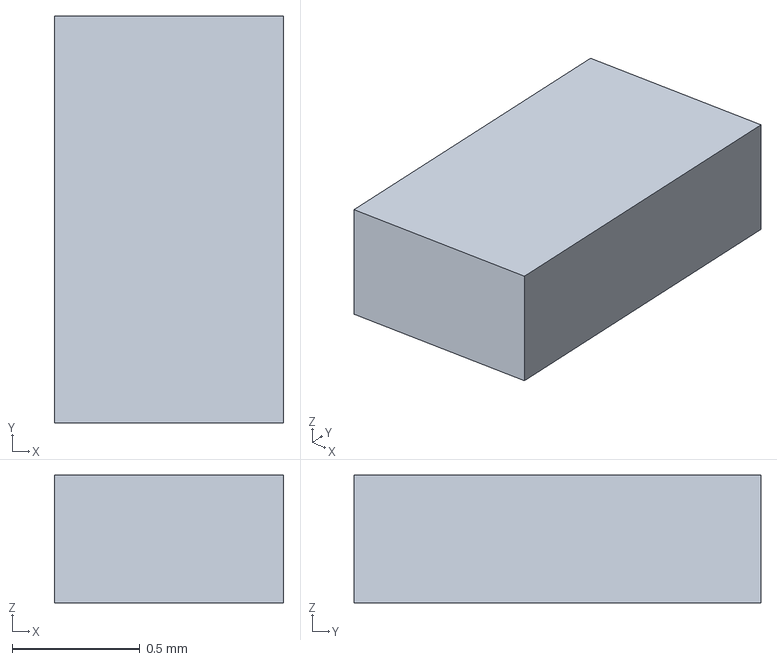
[picture p109: CAD file, 2023-12-04]
3d-models/XFBGA8.step
0.896 x 1.59 x 0.5 mm
