blues/blues-kicad-lib/3d-models/1206 resistor.STEP

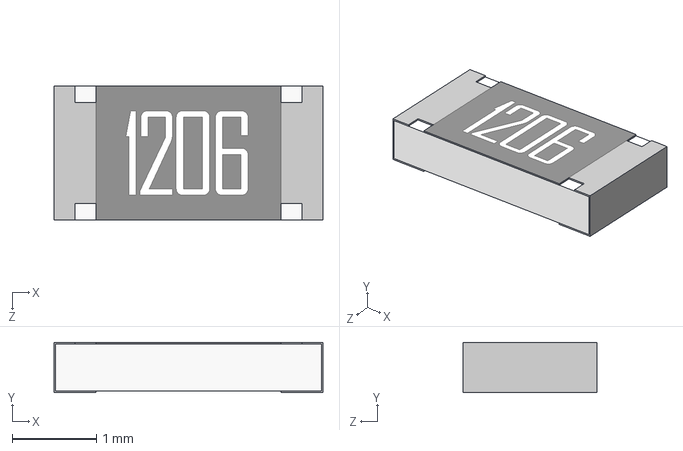
[picture p110: CAD file, 2023-12-04]
3d-models/1206 resistor.STEP
3.20 x 0.6 x 1.60 mm
