blues/blues-kicad-lib/3d-models/CS-C-0402.step

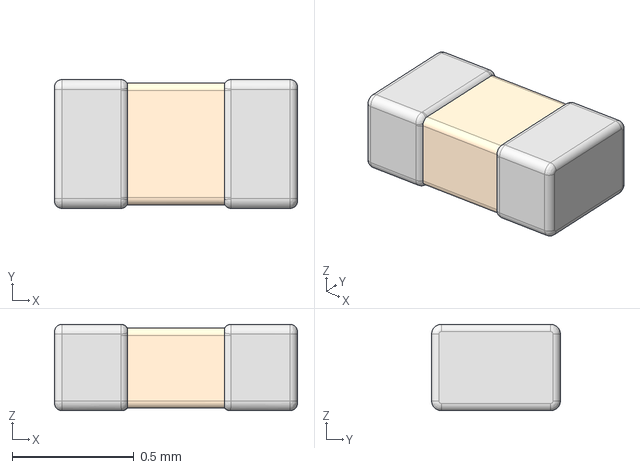
[picture p111: CAD file, 2023-12-04]
3d-models/CS-C-0402.step
1.00 x 0.53 x 0.355 mm
