blues/blues-kicad-lib/3d-models/RESNET - 1506 Convex.step

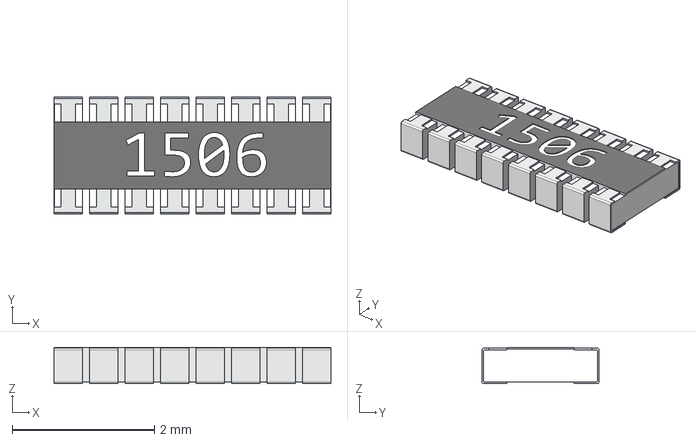
[picture p112: CAD file, 2023-12-04]
3d-models/RESNET - 1506 Convex.step
3.90 x 1.65 x 0.51 mm
