blues/blues-kicad-lib/3d-models/RESC3116X65N EIA 1206.step

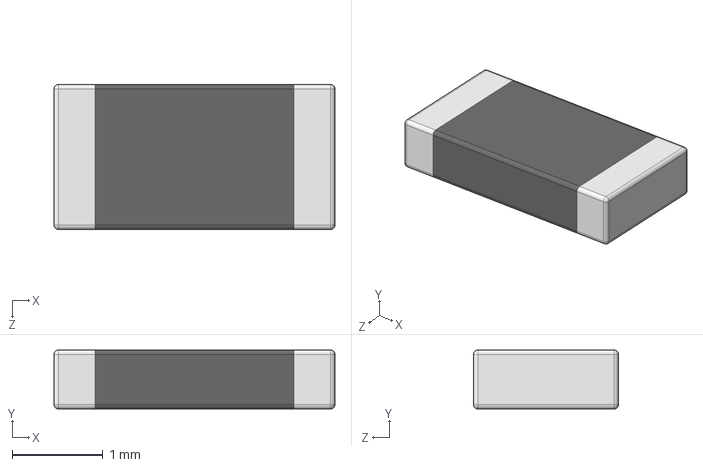
[picture p113: CAD file, 2023-12-04]
3d-models/RESC3116X65N EIA 1206.step
3.10 x 0.65 x 1.60 mm
