blues/blues-kicad-lib/3d-models/C-1206.step

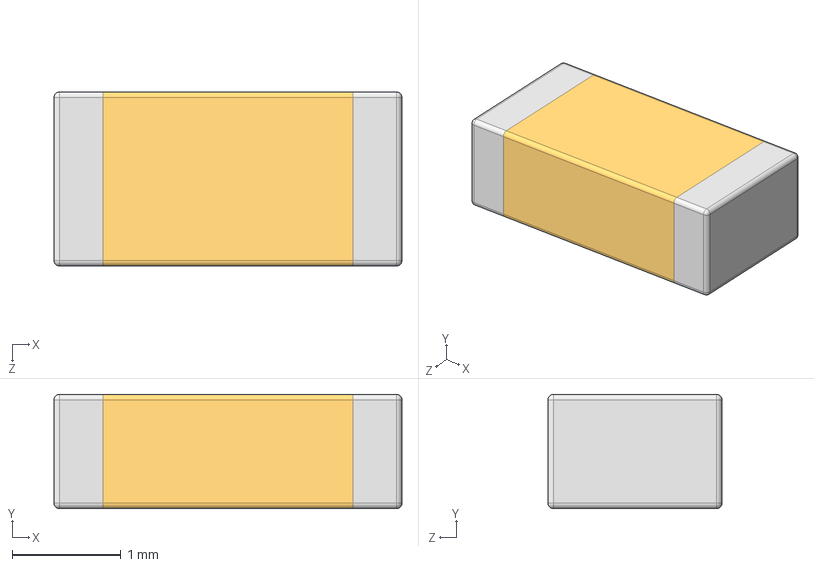
[picture p114: CAD file, 2023-12-04]
3d-models/C-1206.step
3.20 x 1.05 x 1.60 mm
