blues/blues-kicad-lib/3d-models/CAP 1210-2.8mm.STEP

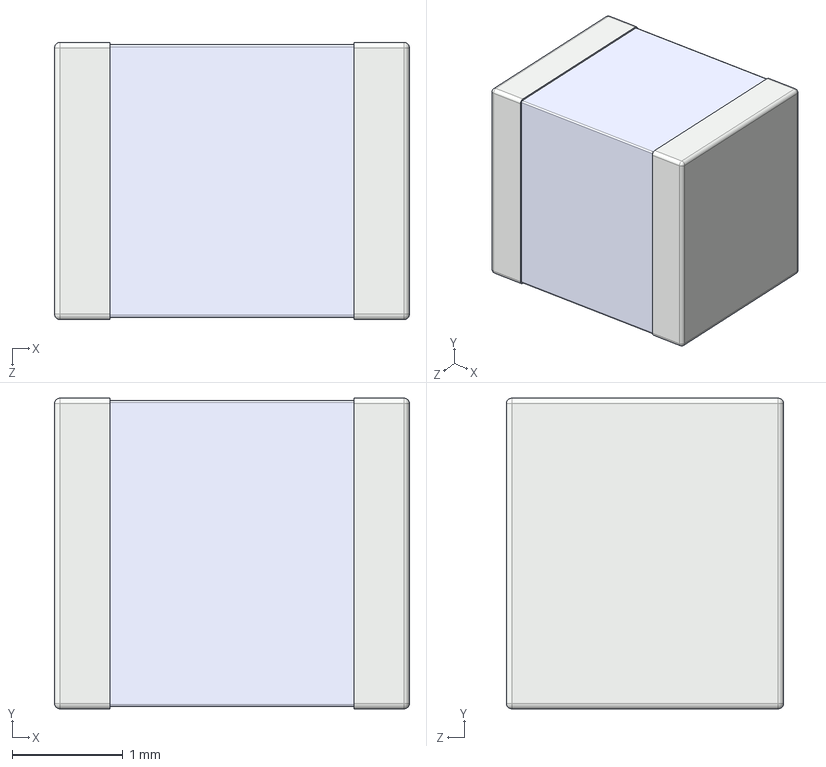
[picture p115: CAD file, 2023-12-04]
3d-models/CAP 1210-2.8mm.STEP
3.20 x 2.80 x 2.50 mm
