blues/blues-kicad-lib/3d-models/J-5-0065-FOS-MICROUSB10118192.step

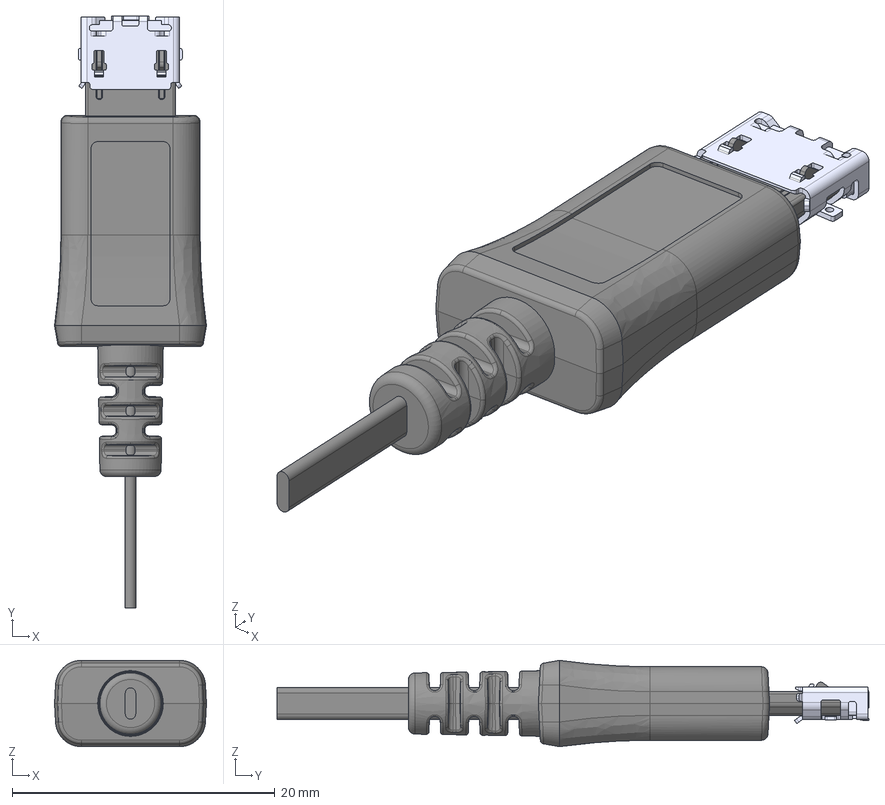
[picture p116: CAD file, 2023-12-04]
3d-models/J-5-0065-FOS-MICROUSB10118192.step
11.6 x 45.1 x 6.57 mm
Micro_USB_Plug_Molding_w]
Micro_USB_Plug_Connector_w]
Micro_USB_Plug_cable_w]
