blues/blues-kicad-lib/3d-models/J-3-MDS-UFL.step

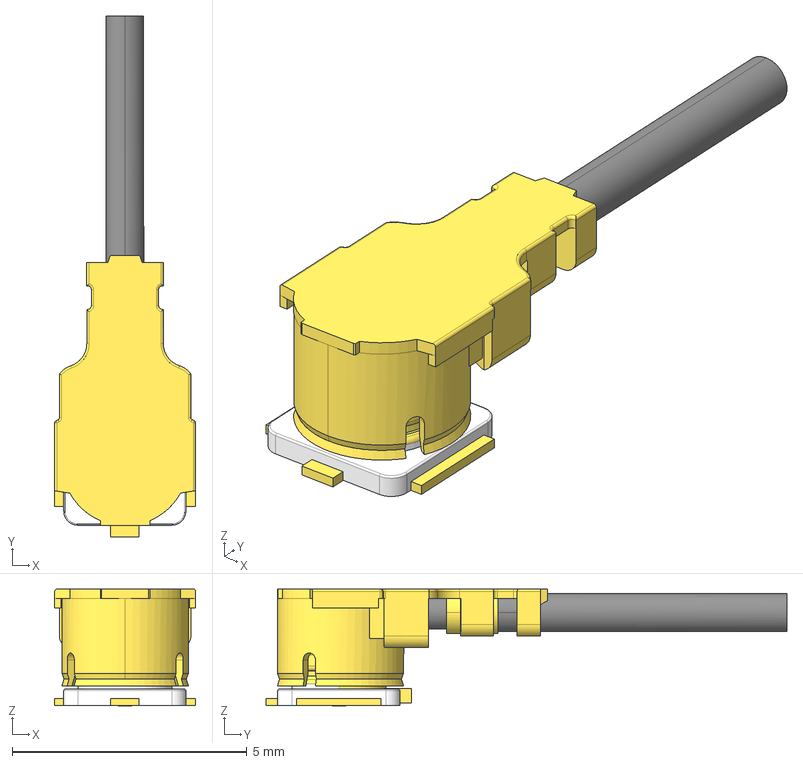
[picture p117: CAD file, 2023-12-04]
3d-models/J-3-MDS-UFL.step
3.01 x 11.1 x 2.49 mm
