blues/blues-kicad-lib/3d-models/ANT-NN03320-GPS.step

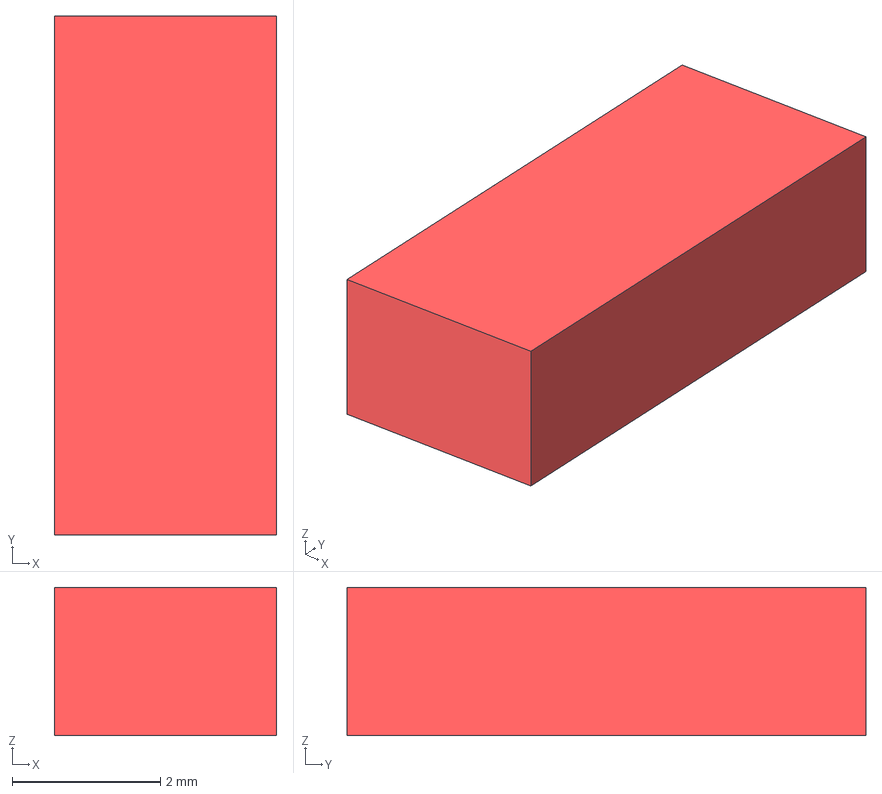
[picture p118: CAD file, 2023-12-04]
3d-models/ANT-NN03320-GPS.step
3.00 x 7.00 x 2.00 mm
