blues/blues-kicad-lib/3d-models/RS-0603.step

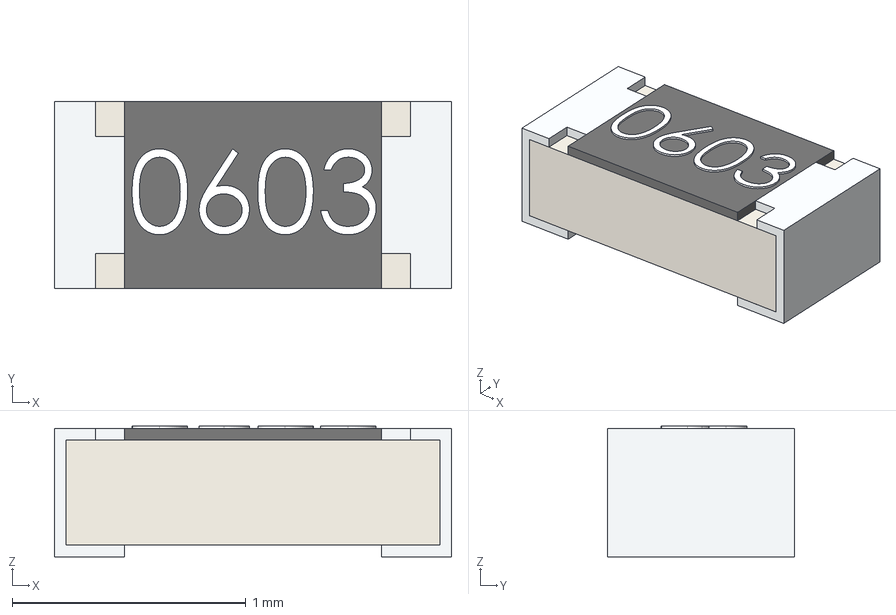
[picture p119: CAD file, 2023-12-04]
3d-models/RS-0603.step
1.70 x 0.8 x 0.56 mm
