blues/blues-kicad-lib/3d-models/ANT-NN03310-LTE.step

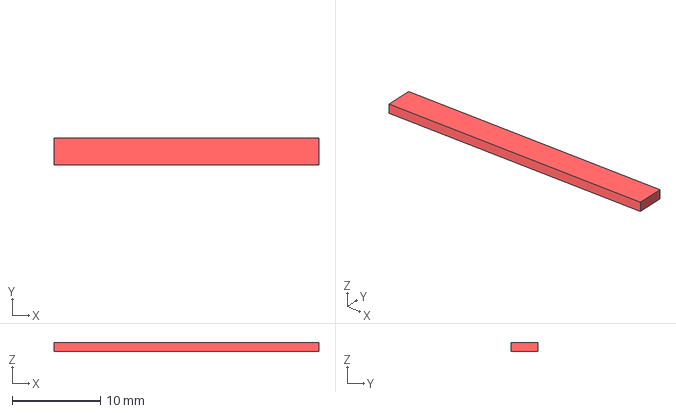
[picture p120: CAD file, 2023-12-04]
3d-models/ANT-NN03310-LTE.step
30.0 x 3.00 x 1.00 mm
