blues/blues-kicad-lib/3d-models/FCI USB 10118193-0001lfc.STEP

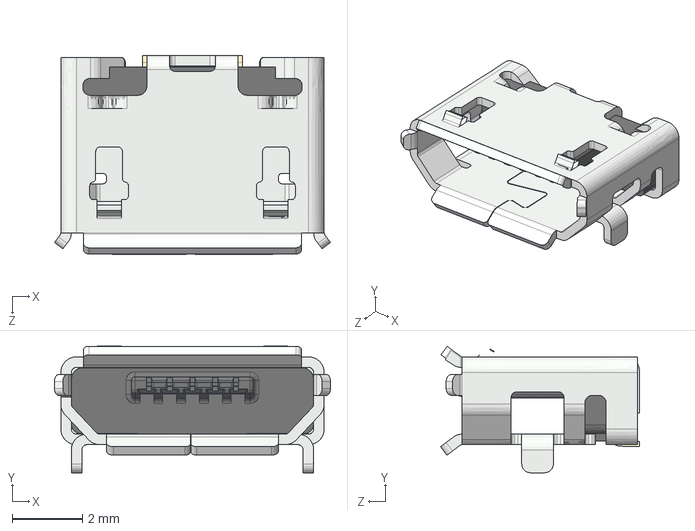
[picture p121: CAD file, 2023-12-04]
3d-models/FCI USB 10118193-0001lfc.STEP
7.86 x 3.60 x 5.66 mm
