blues/blues-kicad-lib/3d-models/JST S2B-PH-SM4-TB.step

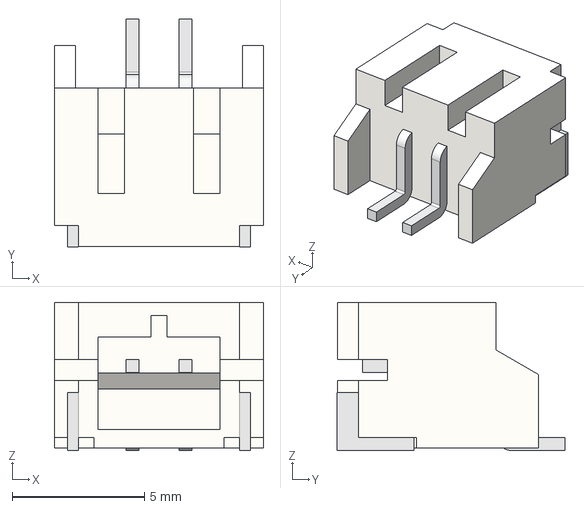
[picture p122: CAD file, 2023-12-04]
3d-models/JST S2B-PH-SM4-TB.step
7.90 x 8.61 x 5.60 mm
