blues/blues-kicad-lib/3d-models/J-10-0254-MDT.step

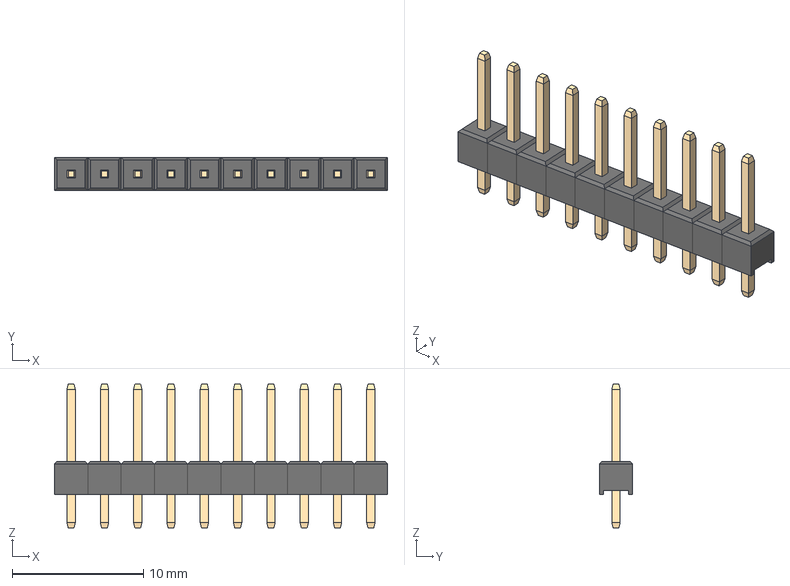
[picture p123: CAD file, 2023-12-04]
3d-models/J-10-0254-MDT.step
25.4 x 2.54 x 11.0 mm
User_Library-Header1x005
User_Library-Header1x006
User_Library-Header1x011
User_Library-Header1x007
User_Library-Header1x003
User_Library-Header1x004
User_Library-Header1x2
User_Library-Header1x008
User_Library-Header1x009
User_Library-Header1x010
