blues/blues-kicad-lib/3d-models/C-0805.step

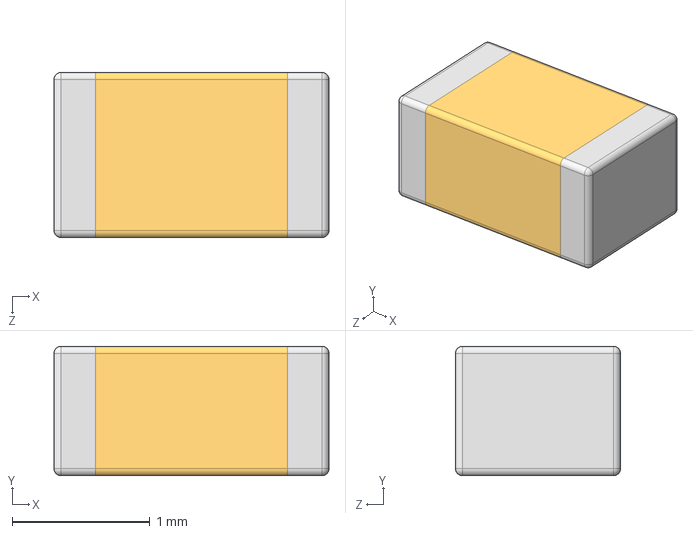
[picture p124: CAD file, 2023-12-04]
3d-models/C-0805.step
2.00 x 0.94 x 1.20 mm
