blues/blues-kicad-lib/3d-models/K3D-SF72S006VBD-V1_JAE_Proprietary.STEP

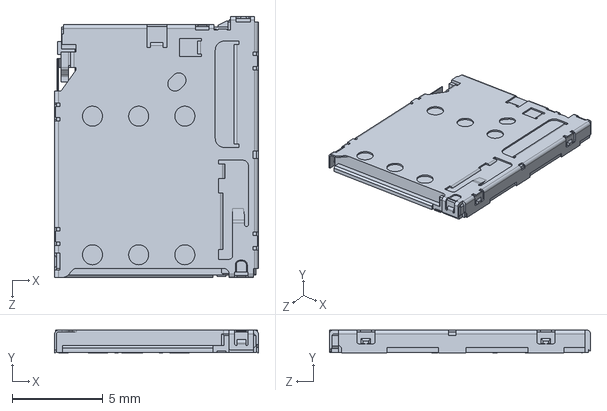
[picture p125: CAD file, 2022-10-25]
3d-models/K3D-SF72S006VBD-V1_JAE_Proprietary.STEP
11.2 x 1.25 x 14.4 mm
