blues/blues-kicad-lib/3d-models/TSM-112-01-L-SV.stp

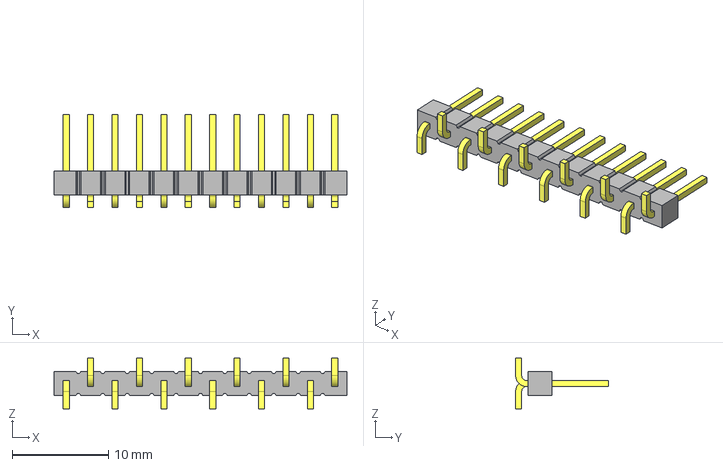
[picture p126: CAD file, 2022-10-25]
3d-models/TSM-112-01-L-SV.stp
30.5 x 9.65 x 5.28 mm
_TSM-112-01-SV_body
_T-1S6-16(-01-12-SV)
