blues/blues-kicad-lib/3d-models/ws2812b-2020 v1.step

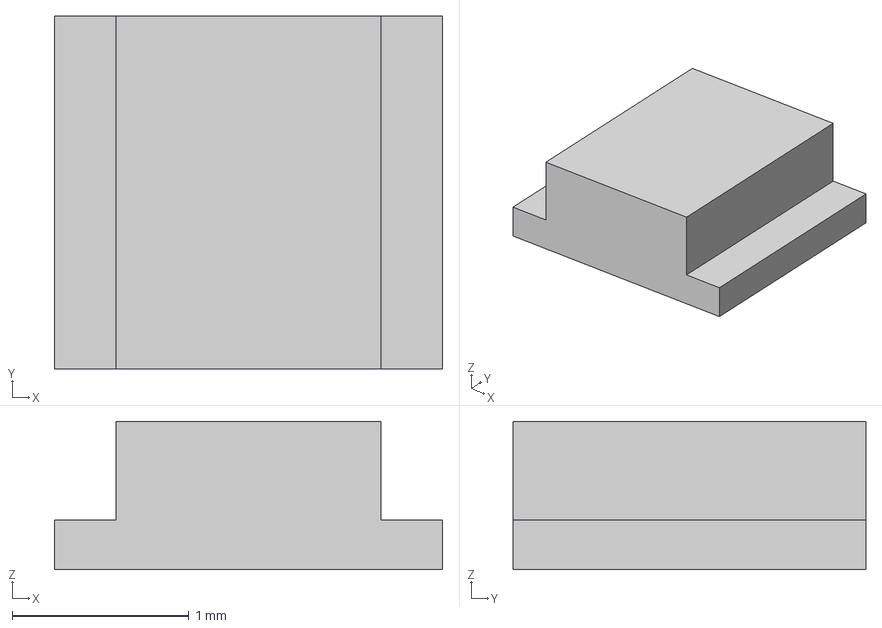
[picture p127: CAD file, 2022-10-25]
3d-models/ws2812b-2020 v1.step
2.20 x 2.00 x 0.84 mm
