blues/blues-kicad-lib/3d-models/PTS810SJG250SMTRLFS.stp

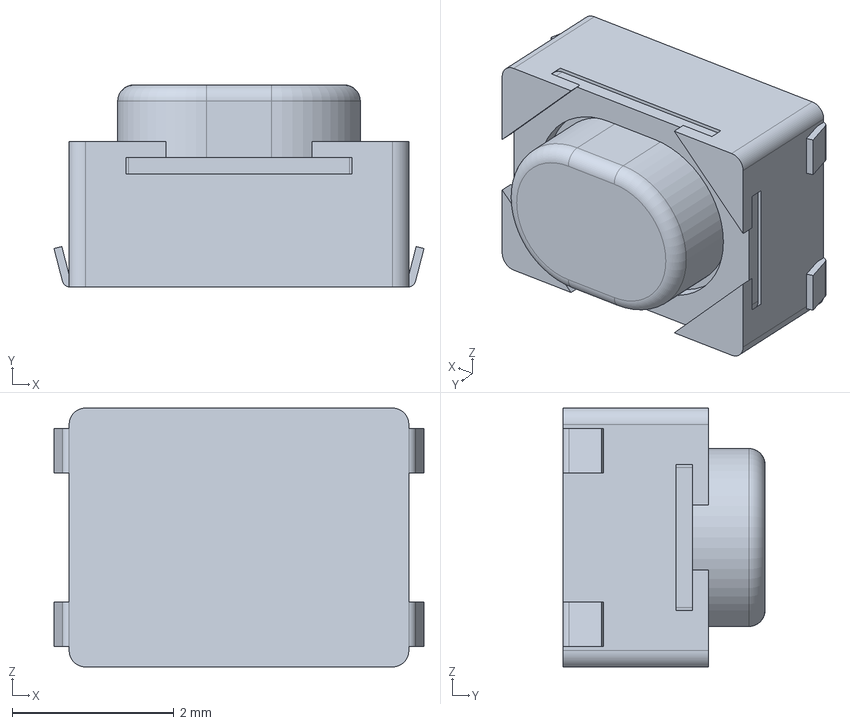
[picture p128: CAD file, 2022-10-25]
3d-models/PTS810SJG250SMTRLFS.stp
4.58 x 2.50 x 3.20 mm
