blues/blues-kicad-lib/3d-models/TSM-116-01-T-SV.stp

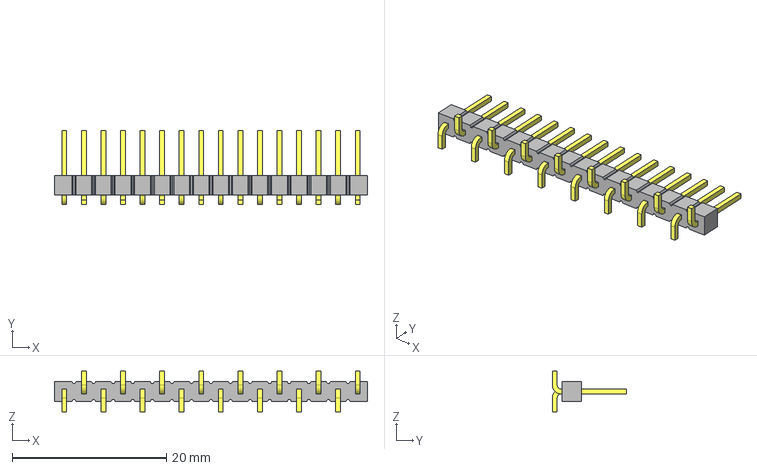
[picture p129: CAD file, 2022-10-25]
3d-models/TSM-116-01-T-SV.stp
40.6 x 9.65 x 5.28 mm
_TSM-116-01-SV_body
_T-1S6-16(-01-16-SV)
