blues/blues-kicad-lib/(list of files, cad)

Other CAD files:
3d-models/J-4-0100-MDS-SH.step
3d-models/J-75-0050-MOS-M2.stp
3d-models/CS-C-0603.step
3d-models/LS-XFL4020.step
3d-models/J-4-0100-MOS-SH.step
3d-models/S2B-PH-SM4-TB.STEP
3d-models/6103526784.step
3d-models/6104714848.step
3d-models/61300411121.stp
3d-models/6328683376.step
3d-models/6427268096.step
3d-models/91292A005_TYPE 18-8 SS SHCS M2x5.STEP
3d-models/9774040151R (rev1).stp
3d-models/BQ24210DQCT.step
3d-models/BQ25628ERYKR.stp
3d-models/LM66200DRLR.stp
3d-models/MAX40203AUK+T.stp
3d-models/SOT563.step
3d-models/TPS62748YFPT v1.step
3d-models/VEL13353R8257G-rra.stp
