blues/blues-kicad-lib/(commit log)

2022-10-25 blues kicad library files
    [9774025151R (rev1).stp, BQ24210DQCT.step, K3D-SF72S006VBD-V1_JAE_Proprietary.STEP, PTS810SJG250SMTRLFS.stp, S2B-PH-SM4-TB.STEP, TPS62748YFPT v1.step, TSM-112-01-L-SV.stp, TSM-116-01-T-SV.stp]
2023-04-20 Remove zip and .DS_Store files
    Unnecessary, don’t belong.
2023-04-20 Add symbols, footprints and models from Notecarrier-B port.
    [CS-C-0402.step, CS-C-0603.step, CS-C-1206.step, CS-T-A.step, CS-T-B.step, DIST-WASMSIM0250.step, DSS-CHS-01TB.step, FS-0603.step]
2023-04-20 Delete incorrect M.2 footprint.
    Seems it was key M instead of key E? Anyway, replaced now by `J-75-0050-MOS-M2-E.kicad_mod` and since the original is incorrectly named and unproven, I’ve opted to remove it to reduce confusion.
2023-04-25 Add and update symbols and footprints from port of Notecarrier-F schematic.
    See that project’s PortingNotes.md for more details.
2023-04-28 Port footprints from Notecarrier-F into pending library.
    Ultimately these will be merged with the main library and unused items deleted.
    [0402 cap.STEP, 0402 resistor.STEP, 0603 cap.STEP, 1206 resistor.STEP, 21-0164_L622+1C_MXM.step, C&K - PTS810.step, CAP 1206-0.8mm.STEP, CAP 1210-2.8mm.STEP]
2023-05-23 Add 0.1mm solder mask expansion.
    Should have always been there, but perhaps wasn’t included in the Notecarrier-F port because it gets overridden by a board wide setting anyway. But is required in the Notecarrier-A port so a good opportunity to fix it and use the part for both projects. Also added ref des text to the Fab layer for same purpose, but hidden by default.
    Note the same two improvements will also be made to SOT666 and J-NANOSIM-SF72S006VBA, but they are rolled up with other changes to those footprints, so don't appear in this commit.
2023-05-23 Add symbols, footprints and models from Notecarrier-A port.
    For details, see PortingNotes.md in the Notecarrier-A project.
    [ANT-NN03310-LTE.step, ANT-NN03320-GPS.step, CJS-1200TA--3DModel-STEP-56544.step, FRACTUS-0404.step, J-2-0200-MDS-B2B-PH-SM4.step, J-22-0254-FDT-H0508_EDGE.step, J-3-0254-FDT-H0508.step, J-3-MDS-UFL.step]
2023-05-29 Add symbols, footprints and models from Notecarrier-Pi port.
    For details, see PortingNotes.md in the Notecarrier-Pi project.
    [D-DO216AA.step, J-20X2-0254-FDT-SSQX03.step, J-4-0200-MOS-GROVE.step]
2023-07-19 Add models, footprints and symbols from Notecarrier-F KiCad port rev B.
    Includes all the new 3D models (see the Porting Notes in the Notecarrier-F KiCad project for details) as well as the alternate M.2 symbol “MDT420E01001_ALT”.
    All the footprints are named with a “_Fv1.2” suffix because they likely overlap with existing footprints, and because this is a one off it’s not clear what the merge behaviour should be. Distinguishing by name will make it easy to merge and consolidate in the future.
    [C-0402.step, C-0603.step, C-0805.step, C-1206.step, DIOM-5127.step, RESC1005X38N EIA 0402.step, RESC3116X65N EIA 1206.step, SMB_STM.step]
2023-07-28 Correct MDT420E01001 (M.2 connector) pin 38 name “NC38” —> “AUX5”.
    In Notecarrier-Pi it is NC38.
    In Notecarrier-F it is NC38, but the net name is N_AUX5.
    In Notecarrier-A it is NC38, but the net name is AUX5.
    But in Notecarrier-B it is AUX5 and the net name is AUX5.
    And now in reference design “SingleDryCell” it is again “AUX5”. Hence, I am updating the library since it will be used for “SingleDryCell”, and looks very much like a correction. In keeping with the original projects, I have also updated Notecarrier-B, but none of the others.
2026-09-28 Add Songbird parts: BQ25628, STDC14, ISL9122 WLCSP, Amphenol USB-C, SM6T SMB, SOD-523, WE RGB LED, CMT-8504, Alps SKRP
    Nine footprints (five with STEP models) and seven symbols from the Songbird
    reference design. The SM6T6V8A symbol's footprint link, which pointed at a
    "pending" library that does not resolve, now points at SMB_SM6T6V8A.
    Claude-Session: https://claude.ai/code/session_01K19zoZgDh9cS58KKYLsMBc
    [12402012E212A.STEP, BQ25628ERYKR.stp, Conn_Samtec_FTSH-107-01-L-DV-K_eec.STEP, SKRPAD.STEP, SM6T6V8A-E3_52.stp]
2026-09-28 README: KiCad version note, where parts come from, contributing conventions
    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
2026-09-28 Address review: BQ25628 description and datasheet, pin types, root locks, LED datasheet URL
    The BQ25628 RYK package has no exposed thermal pad (the pin table lists
    18 pins and no PAD; the land pattern is the Notecarrier CX production
    one), so the description no longer claims one. SCL on BQ25628ERYKR is an
    input; SDO on BME280 is bidirectional. Root-level lock flags removed from
    the SOD-523, SMB and STDC14 footprints. Datasheet fields on the RGB LED,
    STDC14 and BQ25628 footprints are manufacturer URLs.
    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
2026-10-03 Fix 3D model links that pointed outside the library
    Nine footprints from the original 2022 library still linked their 3D model
    by an absolute path on the original author's machine, so the model never
    loaded for anyone else. Seven of those files have been in 3d-models all
    along; the links now use ${BLUES_KICAD_LIB_DIR}/3d-models/ like the rest.
    CJS-1200TA now uses the library's SW-CJS1200TA.step with the same
    transform SW_CJS-1200TA applies to it (verified by rendering both).
    USB4105-GF-A linked a GCT STEP file that was never added to the library;
    the dangling link is removed.
    Three symbols (C&K PTS810, MAX17225ELT, TPS62748YFPT) still pointed their
    Footprint field at the "blues-kicad-lib-pe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
2026-10-03 USB4105-GF-A-ULTRA-LIBRARIAN: locating pegs are NPTH, not plated pads
    Pads 17 and 18 were plated through-holes whose copper diameter equalled
    the drill (0.6604 mm), i.e. zero annular ring, which KiCad 9 DRC reports
    on every board that uses the footprint. They are the connector's two
    locating pegs: the library's other footprint for the same part
    (USB4105-GF-A) has them as unnumbered NPTH holes at the same +/-2.89 mm
    spacing. Made them the same here.
2026-10-03 Remove the 36 *_Fv1.2 footprints from the retired Notecarrier F rev B port
    These variants were saved out of the hand-made Notecarrier F KiCad port
    (rev B). note-hardware has since replaced that port with a direct
    conversion of the Notecarrier F v1.3 and v1.5 Altium sources, validated
    against the released fabrication outputs, and no KiCad design in
    note-hardware or symbol in this library references any *_Fv1.2 footprint
    any more. The plain-named footprints they were variants of stay.
    They remain in git history; the README says so.
2026-10-03 Add 85 footprints and 63 STEP models from the note-hardware Altium conversions
    The ten Altium designs converted to KiCad in blues/note-hardware (Notecarrier
    F v1.3/v1.5, X/XS/XM v1.2, XI v1.4, CX v1.7, Cygnet v1.2, Mojo v1.1, Scoop
    v1.0) carry 102 vendor STEP models embedded inside their board files, and
    each board was validated against its released fabrication outputs. This
    brings into the library every footprint from those conversions that has a
    3D model and whose name was not already here, with the model extracted to
    3d-models/ and linked as ${BLUES_KICAD_LIB_DIR}/3d-models/<file> per the
    README, instead of embedded.
    Where several boards carry the same footprint name the most recent desi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
    [0805 resistor.STEP, 1769.stp, 61300411121.stp, 91292A005_TYPE 18-8 SS SHCS M2x5.STEP, 9774040151R (rev1).stp, AMPHENOL_12402012E212A.STEP, B2B-PH-SM4-TBT.STEP, BM04B-SRSS-TB.STEP]
2026-10-03 Remove eight 3D models no footprint links to
    The README asks that every model be linked from at least one footprint.
    These were not: four were orphaned by removing the *_Fv1.2 footprints
    (SMB_STM.step, DIOM-5127.step, WSON10-EXP.stp, Notecard-V2-Telit-WiFi.step;
    the plain SMB and WSON10-EXP footprints link their own models), and four
    had been unreferenced since 2023 ("9774025151R (rev1).stp", which the
    standoff footprint replaced with DIST-WASMSIM0250.step; the superseded M.2
    model mdt420e0x001_c3d.stp; RS-0805.step; and "notecard-v2-42mm-ME910C1
    v6.step"). All remain in git history.
    [9774025151R (rev1).stp, DIOM-5127.step, Notecard-V2-Telit-WiFi.step, RS-0805.step, SMB_STM.step, WSON10-EXP.stp, mdt420e0x001_c3d.stp, notecard-v2-42mm-ME910C1 v6.step]
2026-10-03 Upgrade the library to the KiCad 9 file formats
    kicad-cli sym upgrade / fp upgrade, so the symbol library (20220914 ->
    20241209) and all 215 footprints (11 at 20211014, 146 at 20221018, 58 at
    20241229 -> all 20241229) are in one current format. Every design that
    uses the library is on KiCad 9, and the mixed footprint versions meant
    KiCad 7 could not open part of the library anyway.
    The upgrade is geometry-neutral: a KiCad 9 Python dump of every
    footprint's pads, graphics, texts, zones, attributes and model
    transforms is identical before and after, and the symbol SVG plots differ
    only in their timestamp. One thing kicad-cli changed on the way was put
    back: it rewrote the layer set of NPTH pa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
2026-10-03 Add a library check and run it in CI
    tools/check_library.py fails on the defects this branch had to fix and
    on anything else that breaks a user of the library: model links that are
    not ${BLUES_KICAD_LIB_DIR}/3d-models/<file> or point at a missing file,
    model files no footprint links, kicad-embed:// or locked leftovers,
    symbol Footprint fields that name a missing footprint or a stale
    nickname, mixed footprint format versions, and any part kicad-cli cannot
    load and plot. Footprints that do not yet follow the README's contributing
    conventions (REF**, Value = name, attr, descr) are listed as warnings
    without failing, since 60-odd of the original footprints predate those
    conventions.
    .github/wor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
2026-10-05 Move the check to actions/checkout v7 on ubuntu-24.04
    actions/checkout@v4 targets Node 20, which GitHub now forces onto
    Node 24 with a deprecation warning on every run. v7 runs on Node 24
    natively. Since v6 it also keeps the persisted token in a file under
    RUNNER_TEMP rather than in .git/config, which matters here because the
    check mounts the whole checkout, .git included, into the KiCad
    container. v7's one breaking change (refusing fork checkouts under
    pull_request_target and workflow_run) does not touch this workflow.
    ubuntu-latest is ubuntu-24.04 today, so pinning it changes nothing now;
    it keeps the runner from moving to the next Ubuntu image unannounced,
    and matches the rest of the Blu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
2026-10-05 Give the check a read-only token and a timeout
    The org's default workflow permissions are write, so the check's
    GITHUB_TOKEN could write contents, pull requests, packages and the rest,
    for a job that only reads the repository. contents: read is all
    actions/checkout needs.
    Without timeout-minutes a hung kicad-cli would hold the runner for
    GitHub's default of six hours. The job takes about 35 s, so 10 minutes
    leaves plenty of room for a slow image pull.
2026-10-05 Have Dependabot keep the workflow's actions current
    Nothing watched the uses: pins, and actions/checkout had drifted three
    majors behind (v4 against v7). blues.dev added the same config after
    drifting two majors on the same action. The floating major tags already
    pick up minors and patches on their own, so in practice this opens a PR
    only for a new major version, with any minor or patch bumps grouped
    into one.
    Dependabot cannot see the kicad/kicad image tag, because it sits in a
    run: command rather than a Dockerfile or a uses: line, so the KiCad
    version is still bumped by hand. It has to stay on KiCad 9.0.x anyway
    for as long as the library must load in KiCad 9.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
