blues/blues-kicad-lib/(notices)

Notices in the files:
3d-models/TSM-112-01-L-SV.stp:
FILE_NAME( 'e:/temp/worker_809/temp/exporttempdir_904_387_Oa3K6/format_0/TSM-112-01-L-SV.stp', '2022-06-01T22:33:05', ( 'License CC BY-ND 4.0' ), ( 'CADENAS' ), ' ', 'PARTsolutions', ' ' );
3d-models/CES-116-01-L-S.stp:
FILE_NAME( 'e:/temp/worker_208/temp/exporttempdir_3520_2065_nfZ3Y/format_0/CES-116-01-L-S.stp', '2022-04-22T03:48:04', ( 'License CC BY-ND 4.0' ), ( 'CADENAS' ), ' ', 'PARTsolutions', ' ' );
3d-models/CES-112-01-L-S.stp:
FILE_NAME( 'e:/temp/worker_209/temp/exporttempdir_4864_434_ZVTZ2/format_0/CES-112-01-L-S.stp', '2022-04-22T03:47:31', ( 'License CC BY-ND 4.0' ), ( 'CADENAS' ), ' ', 'PARTsolutions', ' ' );
3d-models/CES-124-01-S-S.stp:
FILE_NAME( 'e:/temp/worker_453/temp/exporttempdir_8520_49_KJQMu/format_0/CES-124-01-S-S.stp', '2022-01-31T22:30:32', ( 'License CC BY-ND 4.0' ), ( 'CADENAS' ), ' ', 'PARTsolutions', ' ' );
3d-models/TSM-116-01-T-SV.stp:
FILE_NAME( 'e:/temp/worker_809/temp/exporttempdir_904_372_lLXPP/format_0/TSM-116-01-T-SV.stp', '2022-06-01T22:32:02', ( 'License CC BY-ND 4.0' ), ( 'CADENAS' ), ' ', 'PARTsolutions', ' ' );
